YoshuaNava/TesisCuadricoptero/Circuitos/Datasheets/Changing PWM frequencies on Arduino controllers   Let's Make Robots!_files/great_motor_2.jpg

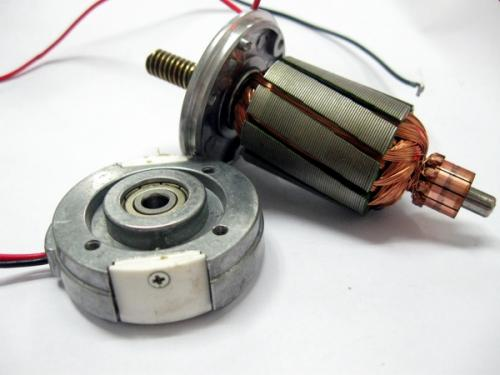
Circuitos/Datasheets/Changing PWM frequencies on Arduino controllers Let's Make Robots!_files/great_motor_2.jpg
