YoshuaNava/TesisCuadricoptero/README.md

Estabilización de un cuadricoptero mediante un algoritmo Proporcional-Integral-Derivativo
==================

Documentos, códigos, imagenes y videos de la tesis. 

Trabajo realizado por Luis Vicens y Yoshua Nava, estudiantes de Ingeniería Informática de la Universidad Católica Andrés Bello.
