YoshuaNava/TesisCuadricoptero/Documento/Lista de graficas que faltan en el documento.txt

Gráfico de respuesta en frecuencia del sensor ultrasónico
  Gráfico de las mediciones del sensor ultrasónico sin filtro y con filtro
