YoshuaNava/TesisCuadricoptero/Referencias/lecture3_state_estimation_tum.pdf

## Visual Navigation for Flying Robots

Dr. Jürgen Sturm

## Probabilistic Models and State Estimation

## Scientific Research

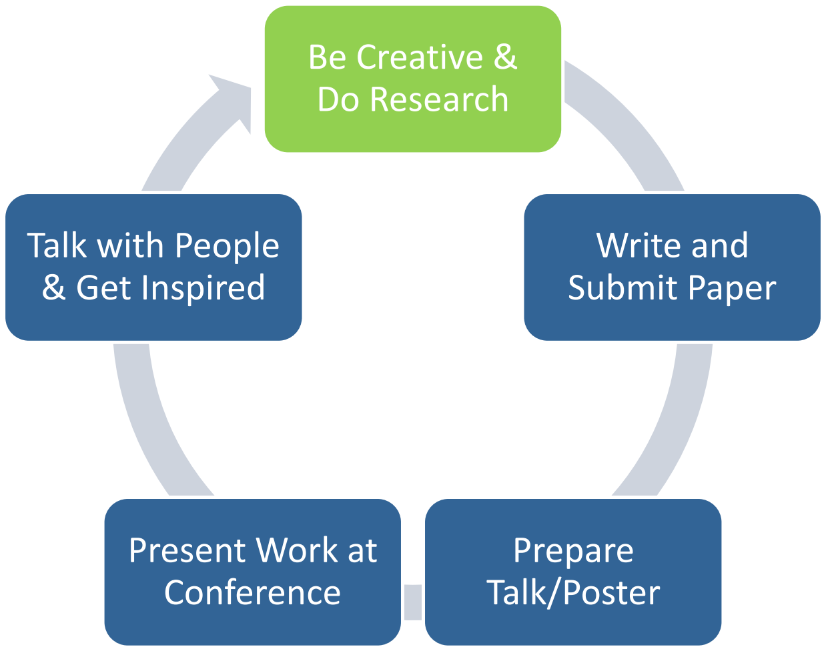
[picture p189: figure]
Be Creative & Do Research; Write and Submit Paper; Prepare Talk/Poster; Present Work at Conference; Talk with People & Get Inspired

Visual Navigation for Flying Robots | 2 | Dr. Jürgen Sturm, Computer Vision Group, TUM

## Flow of Publications

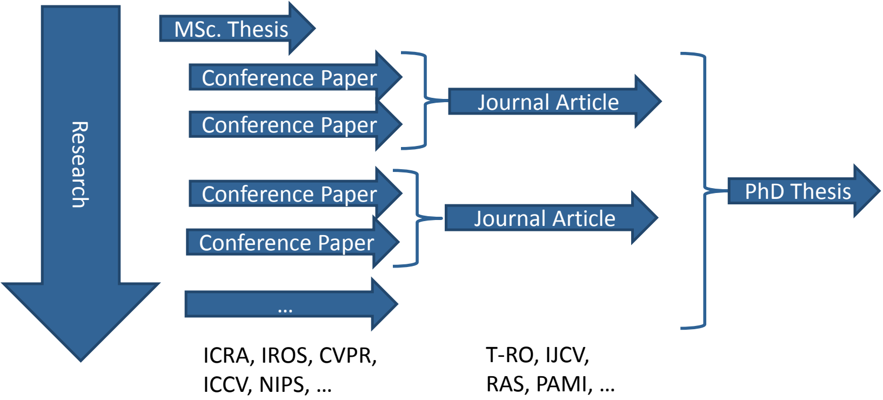
[picture p190: figure]
Conference Paper; Journal Article; ICRA, IROS, CVPR, ICCV, NIPS, …; PhD Thesis; T-RO, IJCV, RAS, PAMI, …; MSc. Thesis

Visual Navigation for Flying Robots | 3 | Dr. Jürgen Sturm, Computer Vision Group, TUM Research

## Important Conferences

- Robotics
- International Conference on Robotics and Automation (ICRA)
- International Conference on Intelligent Robots and Systems (IROS)
- Robotics: Science and Systems (RSS)
- Computer Vision
- International Conference on Computer Vision (ICCV)
- Computer Vision and Pattern Recognition (CVPR)
- German Conference on Computer Vision (GCPR)
Visual Navigation for Flying Robots | 4 | Dr. Jürgen Sturm, Computer Vision Group, TUM

next week

## ICRA: Preview

- Christian’s work got nominated for the “Best Vision Paper”
- Four sessions (with 6 papers each) on flying robots
- Interesting sessions:
- Localization
- Theory and Methods for SLAM
- Visual Servoing
- Sensor Fusion
- Trajectory Planning for Aerial Robots
- Novel Aerial Robots
- Aerial Robots and Manipulation
- Modeling & Control of Aerial Robots
- Sensing for Navigation
- Will report on interesting papers!
Visual Navigation for Flying Robots | 5 | Dr. Jürgen Sturm, Computer Vision Group, TUM

## Perception

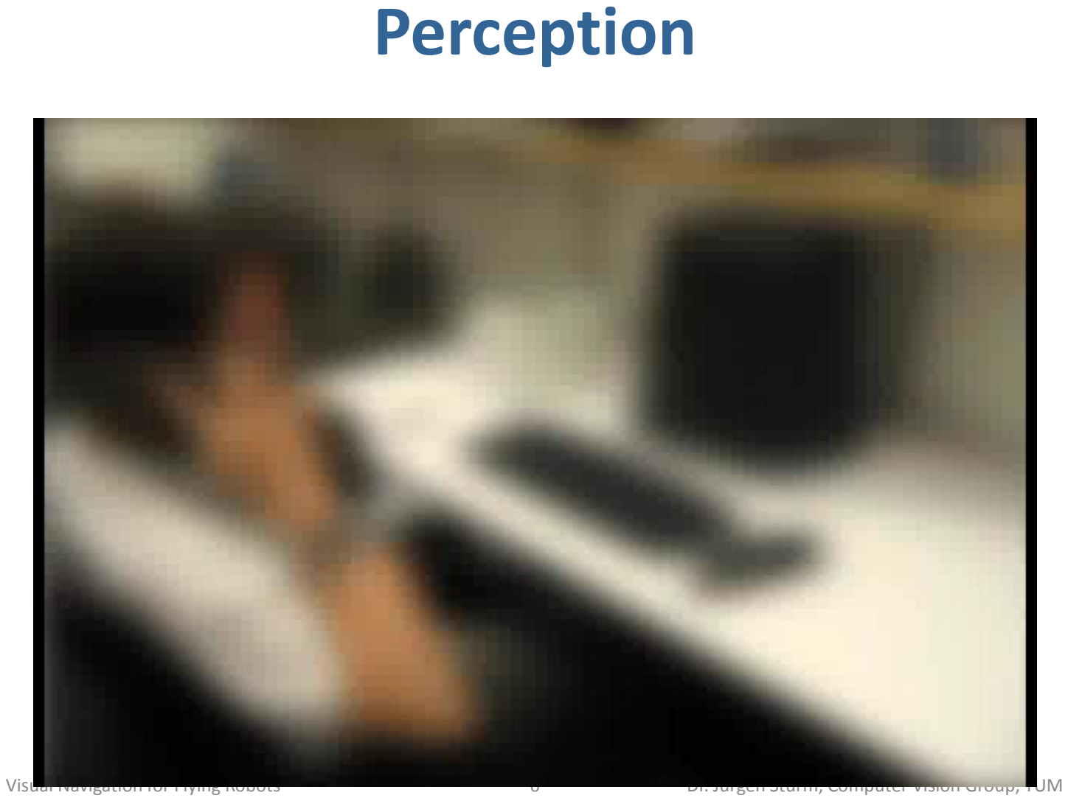
[picture p191: page 6]

Visual Navigation for Flying Robots | 6 | Dr. Jürgen Sturm, Computer Vision Group, TUM

## Perception

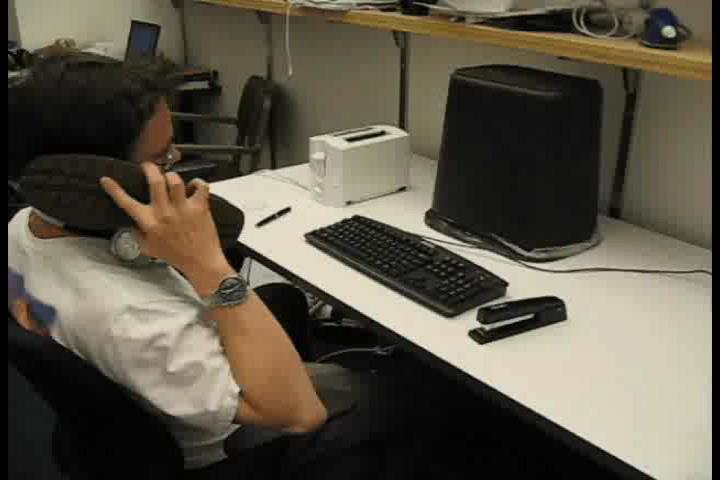
[picture p192: page 7]

Visual Navigation for Flying Robots | 7 | Dr. Jürgen Sturm, Computer Vision Group, TUM

## Perception

- Perception and models are strongly linked

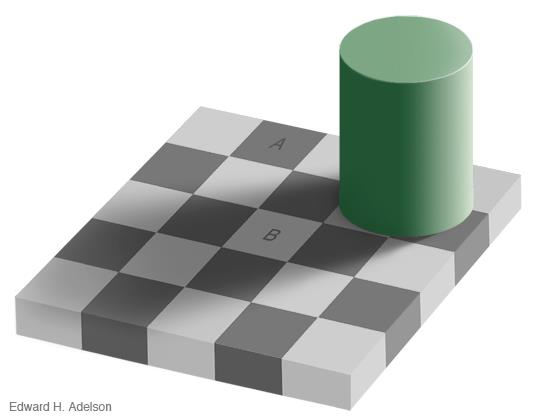
[picture p193: figure]

Visual Navigation for Flying Robots | 8 | Dr. Jürgen Sturm, Computer Vision Group, TUM

## Perception

- Perception and models are strongly linked
- Example: Human Perception

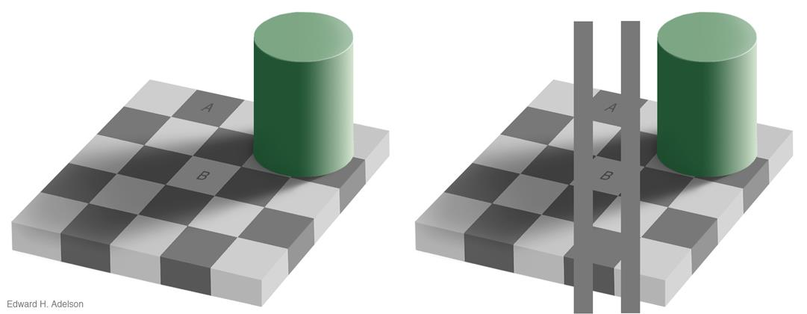
[picture p194: figure]

Visual Navigation for Flying Robots | 9 | Dr. Jürgen Sturm, Computer Vision Group, TUM

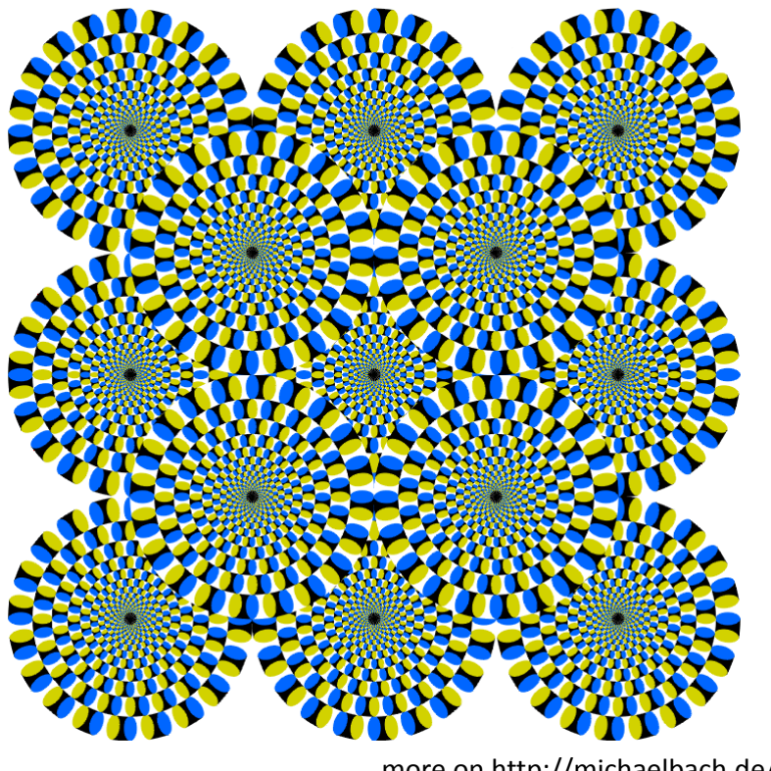
[picture p195: figure]

more on http://michaelbach.de/ot/index.html

Visual Navigation for Flying Robots | 10 | Dr. Jürgen Sturm, Computer Vision Group, TUM

## Models in Human Perception

- Count the black dots

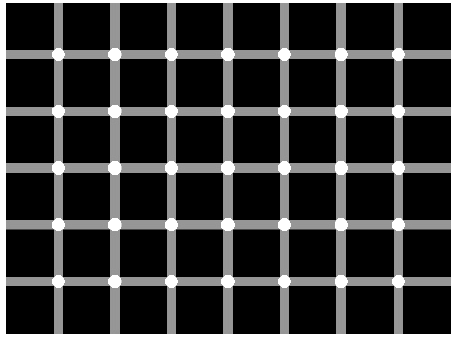
[picture p196: figure]

Visual Navigation for Flying Robots | 11 | Dr. Jürgen Sturm, Computer Vision Group, TUM

## State Estimation

- Cannot observe world state directly
- Need to estimate the world state
- Robot maintains belief about world state
- Update belief according to observations and actions using models
- Sensor observations → sensor model
- Executed actions → action/motion model
Visual Navigation for Flying Robots | 12 | Dr. Jürgen Sturm, Computer Vision Group, TUM

## State Estimation

What parts of the world state are (most) relevant for a flying robot?

Visual Navigation for Flying Robots | 13 | Dr. Jürgen Sturm, Computer Vision Group, TUM

## State Estimation

What parts of the world state are (most) relevant for a flying robot?
- Position
- Velocity
- Obstacles
- Map
- Positions and intentions of other
robots/humans
- …
Visual Navigation for Flying Robots | 14 | Dr. Jürgen Sturm, Computer Vision Group, TUM

## Models and State Estimation

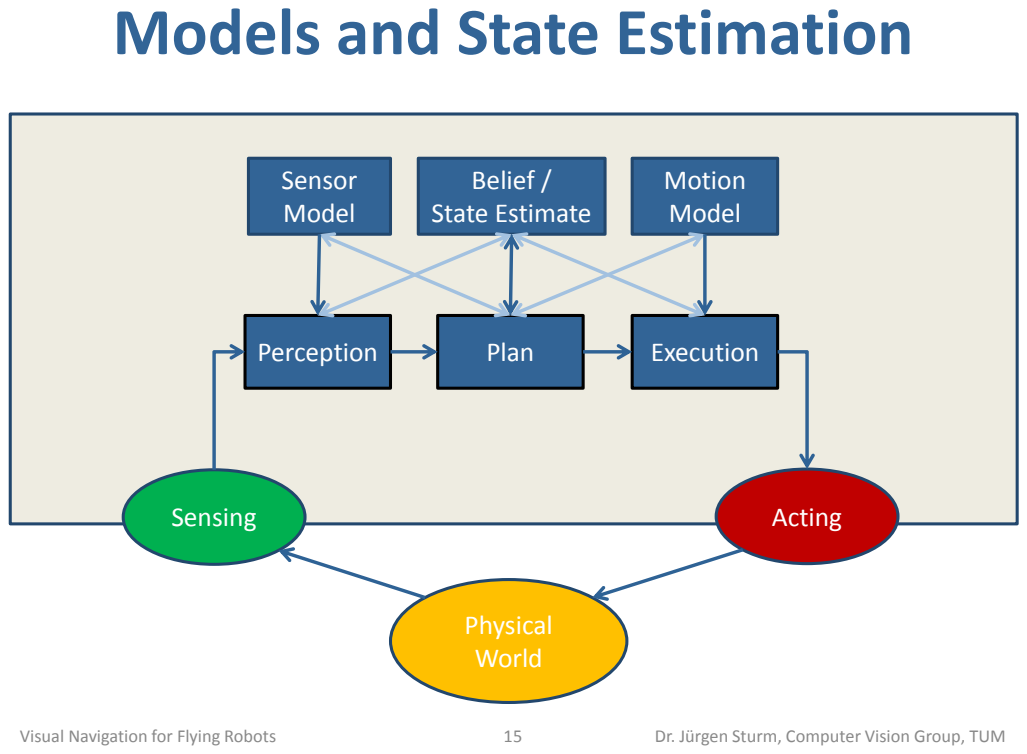
[picture p197: page 15]
Sensor Model; Visual Navigation for Flying Robots; Dr. Jürgen Sturm, Computer Vision Group, TUM; Perception; Plan; Execution; Sensing; Acting; Physical World; Belief / State Estimate; Motion Model

## (Deterministic) Sensor Model

- Robot perceives the environment through its sensors
- Goal: Infer the state of the world from sensor readings

sensor
reading

world
state

observation
function
Visual Navigation for Flying Robots | 16 | Dr. Jürgen Sturm, Computer Vision Group, TUM

## (Deterministic) Motion Model

- Robot executes an action
(e.g., move forward at 1m/s)
- Update belief state according to motion model
Visual Navigation for Flying Robots | 17 | Dr. Jürgen Sturm, Computer Vision Group, TUM
current state | previous
state

transition
function

executed
action

## Probabilistic Robotics

- Sensor observations are noisy, partial, potentially missing (why?)
- All models are partially wrong and incomplete (why?)
- Usually we have prior knowledge (from where?)
Visual Navigation for Flying Robots | 18 | Dr. Jürgen Sturm, Computer Vision Group, TUM

## Probabilistic Robotics

- Probabilistic sensor and motion models
- Integrate information from multiple sensors (multi-modal)
- Integrate information over time (filtering)
Visual Navigation for Flying Robots | 19 | Dr. Jürgen Sturm, Computer Vision Group, TUM

## Agenda for Today

- Motivation ✓
- Bayesian Probability Theory
- Bayes Filter
- Normal Distribution
- Kalman Filter
Visual Navigation for Flying Robots | 20 | Dr. Jürgen Sturm, Computer Vision Group, TUM

## The Axioms of Probability Theory

Visual Navigation for Flying Robots | 21 | Dr. Jürgen Sturm, Computer Vision Group, TUM
Notation: | refers to the probability that
proposition holds

1.

2.

3.

## A Closer Look at Axiom 3

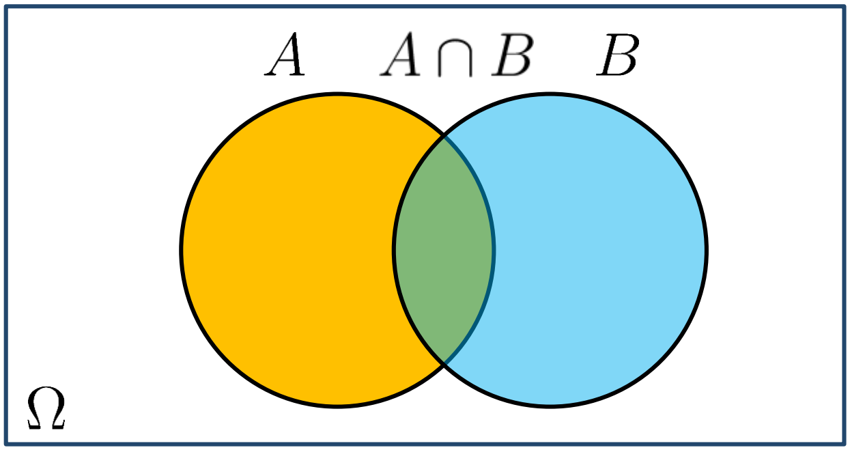
[picture p198: figure]

Visual Navigation for Flying Robots | 22 | Dr. Jürgen Sturm, Computer Vision Group, TUM

## Discrete Random Variables

- denotes a random variable
- can take on a countable number of values in
- is the probability that the random variable takes on value
- is called the probability mass function
- Example:
Visual Navigation for Flying Robots | 23 | Dr. Jürgen Sturm, Computer Vision Group, TUM

## Continuous Random Variables

- takes on continuous values
- | or | is called the probability
density function (PDF)
- Example
Visual Navigation for Flying Robots | 24 | Dr. Jürgen Sturm, Computer Vision Group, TUM

## Proper Distributions Sum To One

- Discrete case
- Continuous case
Visual Navigation for Flying Robots | 25 | Dr. Jürgen Sturm, Computer Vision Group, TUM

## Joint and Conditional Probabilities

Visual Navigation for Flying Robots | 26 | Dr. Jürgen Sturm, Computer Vision Group, TUM

▪

- If and are independent then
- is the probability of x given y
- If and are independent then

## Conditional Independence

Visual Navigation for Flying Robots | 27 | Dr. Jürgen Sturm, Computer Vision Group, TUM
- Definition of conditional independence
- Equivalent to
- Note: this does not necessarily mean that

## Marginalization

- Discrete case
- Continuous case
Visual Navigation for Flying Robots | 28 | Dr. Jürgen Sturm, Computer Vision Group, TUM

## Example: Marginalization

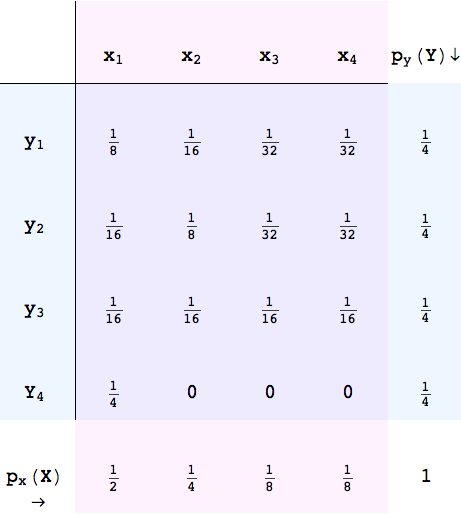
[picture p199: figure]

Visual Navigation for Flying Robots | 29 | Dr. Jürgen Sturm, Computer Vision Group, TUM

## Law of Total Probability

- Discrete case
- Continuous case
Visual Navigation for Flying Robots | 30 | Dr. Jürgen Sturm, Computer Vision Group, TUM

- Discrete case
- Continuous case
- The expected value is the weighted average of all values a random variable can take on.
- Expectation is a linear operator

## Expected Value of a Random Variable

Visual Navigation for Flying Robots | 31 | Dr. Jürgen Sturm, Computer Vision Group, TUM

## Covariance of a Random Variable

- Measures the squared expected deviation from the mean
Visual Navigation for Flying Robots | 32 | Dr. Jürgen Sturm, Computer Vision Group, TUM

## Estimation from Data

- Observations
- Sample Mean

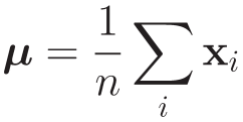
[picture p200: figure]

- Sample Covariance
Visual Navigation for Flying Robots | 33 | Dr. Jürgen Sturm, Computer Vision Group, TUM

## The State Estimation Problem

We want to estimate the world state from
1. Sensor measurements and
2. Controls (or odometry readings)

We need to model the relationship between these random variables, i.e.,

Visual Navigation for Flying Robots | 34 | Dr. Jürgen Sturm, Computer Vision Group, TUM

## Causal vs. Diagnostic Reasoning

- is diagnostic
- is causal
- Often causal knowledge is easier to obtain
- Bayes rule allows us to use causal knowledge:
Visual Navigation for Flying Robots | 35 | Dr. Jürgen Sturm, Computer Vision Group, TUM

observation likelihood prior on world state

prior on sensor observations

## Bayes Formula

- Derivation of Bayes Formula
- Our usage
Visual Navigation for Flying Robots | 36 | Dr. Jürgen Sturm, Computer Vision Group, TUM

## Bayes Formula

- Derivation of Bayes Formula
- Our usage
Visual Navigation for Flying Robots | 37 | Dr. Jürgen Sturm, Computer Vision Group, TUM

- Direct computation of can be difficult
- Idea: Compute improper distribution, normalize afterwards
- Step 1:
- Step 2:
- Step 3:

## Normalization

Visual Navigation for Flying Robots | 38 | Dr. Jürgen Sturm, Computer Vision Group, TUM

(Law of total
probability)

### Bayes Rule with Background Knowledge

Visual Navigation for Flying Robots | 39 | Dr. Jürgen Sturm, Computer Vision Group, TUM

## Example: Sensor Measurement

- Quadrocopter seeks the landing zone
- Landing zone is marked with many bright lamps
- Quadrocopter has a brightness sensor

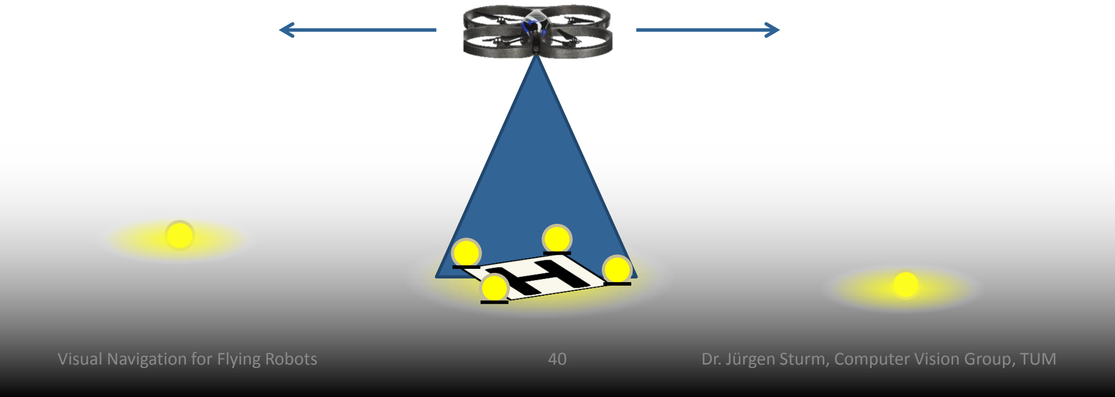
[picture p201: figure]

Visual Navigation for Flying Robots | 40 | Dr. Jürgen Sturm, Computer Vision Group, TUM

## Example: Sensor Measurement

- Binary sensor
- Binary world state
- Sensor model
- Prior on world state
- Assume: Robot observes light, i.e.,
- What is the probability

that the robot is above the landing zone?

Visual Navigation for Flying Robots | 41 | Dr. Jürgen Sturm, Computer Vision Group, TUM

## Example: Sensor Measurement

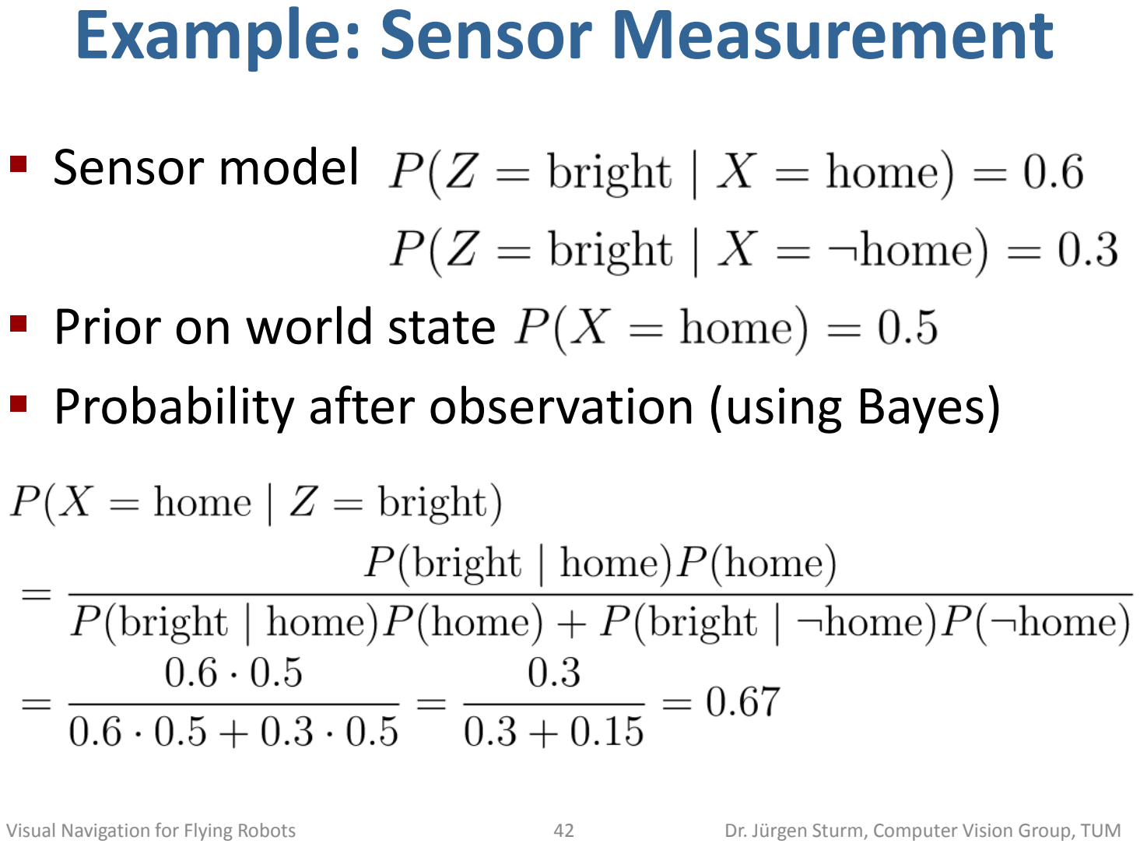
[picture p202: page 42]

- Sensor model
- Prior on world state
- Probability after observation (using Bayes)
Visual Navigation for Flying Robots | 42 | Dr. Jürgen Sturm, Computer Vision Group, TUM

## Example: Sensor Measurement

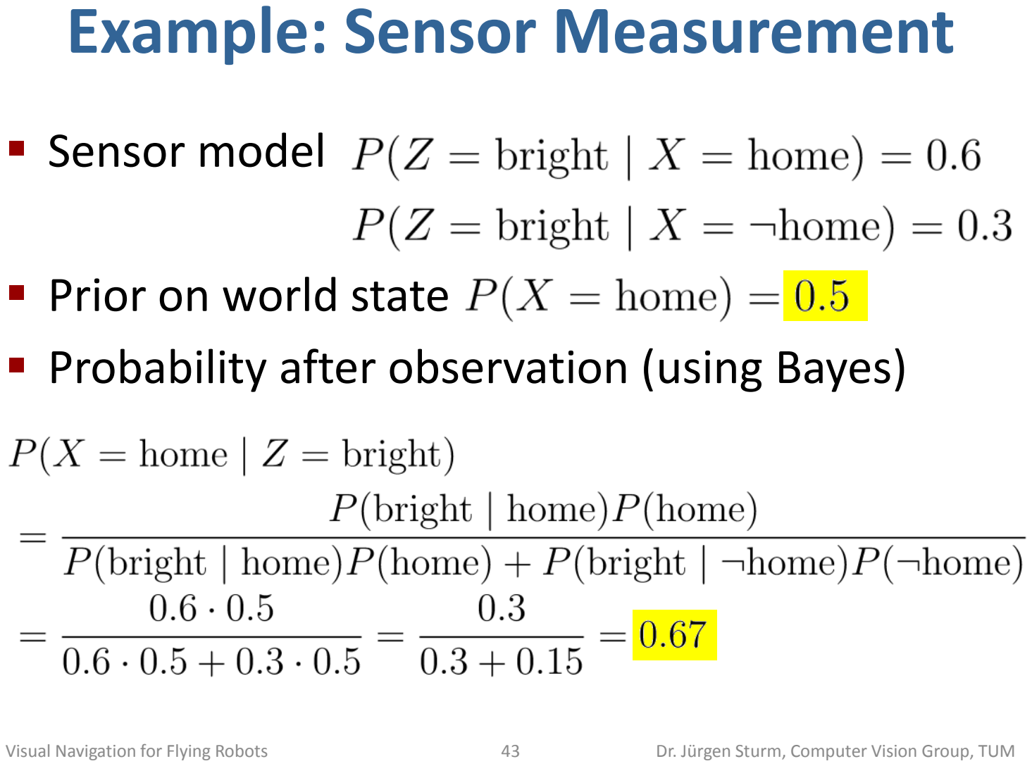
[picture p203: page 43]

- Sensor model
- Prior on world state
- Probability after observation (using Bayes)
Visual Navigation for Flying Robots | 43 | Dr. Jürgen Sturm, Computer Vision Group, TUM

## Combining Evidence

- Suppose our robot obtains another observation (either from the same or a different sensor)
- How can we integrate this new information?
- More generally, how can we estimate
| ?
Visual Navigation for Flying Robots | 44 | Dr. Jürgen Sturm, Computer Vision Group, TUM

## Combining Evidence

- Suppose our robot obtains another observation (either from the same or a different sensor)
- How can we integrate this new information?
- More generally, how can we estimate
| ?
- Bayes formula gives us:
Visual Navigation for Flying Robots | 45 | Dr. Jürgen Sturm, Computer Vision Group, TUM

## Recursive Bayesian Updates

Visual Navigation for Flying Robots | 46 | Dr. Jürgen Sturm, Computer Vision Group, TUM

## Recursive Bayesian Updates

Visual Navigation for Flying Robots | 47 | Dr. Jürgen Sturm, Computer Vision Group, TUM
- Markov Assumption:
is independent of | if we know

## Recursive Bayesian Updates

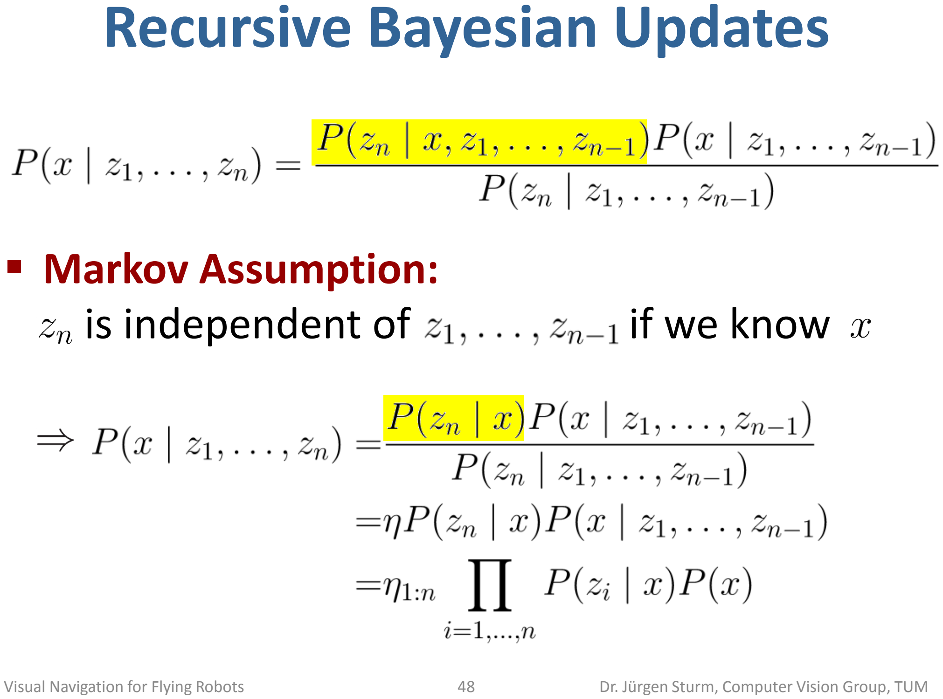
[picture p204: page 48]

Visual Navigation for Flying Robots | 48 | Dr. Jürgen Sturm, Computer Vision Group, TUM
- Markov Assumption:
is independent of | if we know

## Example: Sensor Measurement

- Quadrocopter seeks the landing zone
- Landing zone is marked with many bright lamps and a visual marker

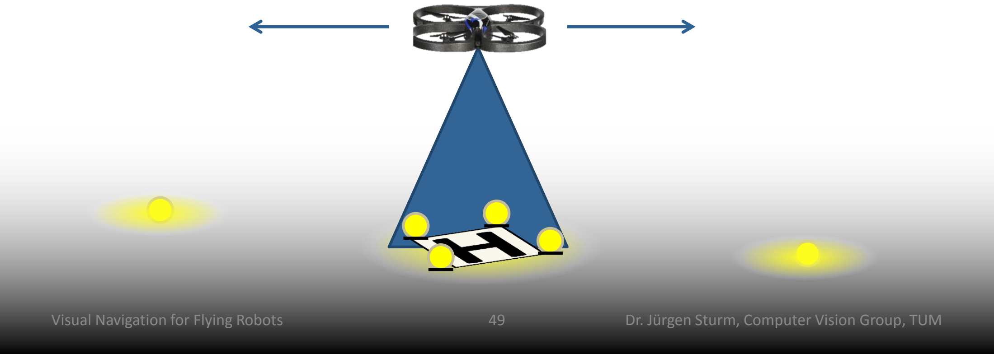
[picture p205: figure]

Visual Navigation for Flying Robots | 49 | Dr. Jürgen Sturm, Computer Vision Group, TUM

## Example: Second Measurement

- Sensor model
- Previous estimate
- Assume robot does not observe marker
- What is the probability of being home?

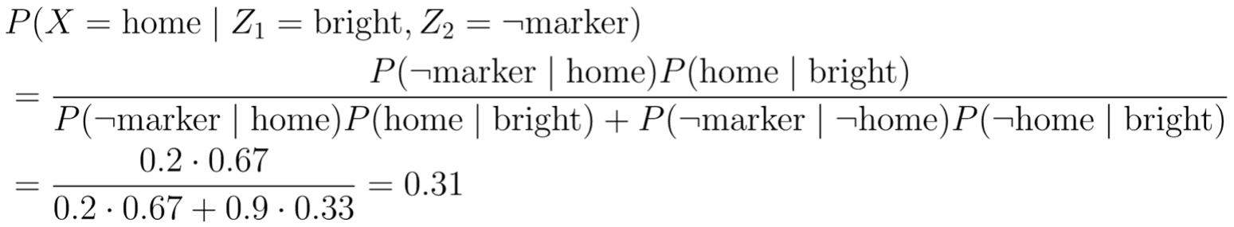
[picture p206: figure]

Visual Navigation for Flying Robots | 50 | Dr. Jürgen Sturm, Computer Vision Group, TUM

## Example: Second Measurement

- Sensor model
- Previous estimate
- Assume robot does not observe marker
- What is the probability of being home?

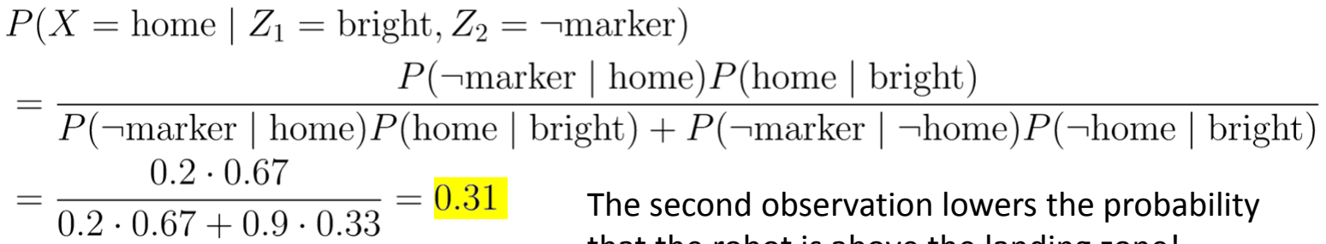
[picture p207: figure]

Visual Navigation for Flying Robots | 51 | Dr. Jürgen Sturm, Computer Vision Group, TUM

The second observation lowers the probability that the robot is above the landing zone!

## Actions (Motions)

- Often the world is dynamic since
- actions carried out by the robot…
- actions carried out by other agents…
- or just time passing by…
…change the world
- How can we incorporate actions?
Visual Navigation for Flying Robots | 52 | Dr. Jürgen Sturm, Computer Vision Group, TUM

## Typical Actions

- Quadrocopter accelerates by changing the speed of its motors
- Position also changes when quadrocopter does “nothing” (and drifts..)
- Actions are never carried out with absolute certainty
- In contrast to measurements, actions generally increase the uncertainty of the state estimate
Visual Navigation for Flying Robots | 53 | Dr. Jürgen Sturm, Computer Vision Group, TUM

## Action Models

- To incorporate the outcome of an action into the current state estimate (“belief”), we use the conditional pdf
- This term specifies the probability that executing the action u in state x will lead to state x’
Visual Navigation for Flying Robots | 54 | Dr. Jürgen Sturm, Computer Vision Group, TUM

## Example: Take-Off

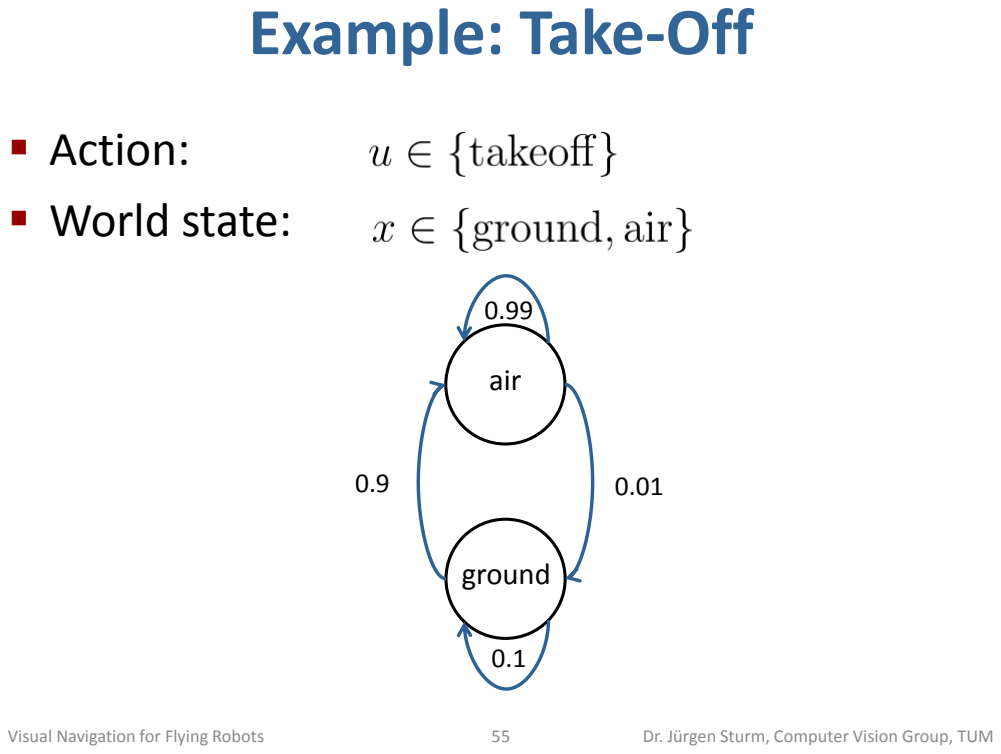
[picture p208: page 55]
▪ Action: ▪ World state:; Visual Navigation for Flying Robots; Dr. Jürgen Sturm, Computer Vision Group, TUM; ground; air

## Integrating the Outcome of Actions

- Discrete case
- Continuous case
Visual Navigation for Flying Robots | 56 | Dr. Jürgen Sturm, Computer Vision Group, TUM

## Example: Take-Off

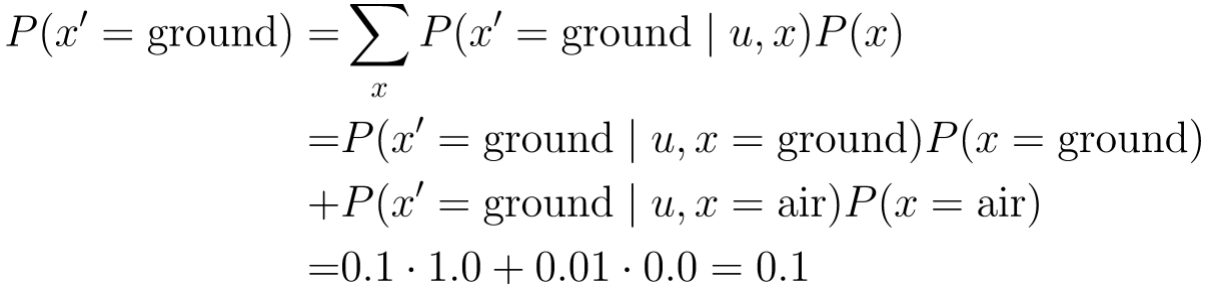
[picture p209: figure]

Visual Navigation for Flying Robots | 57 | Dr. Jürgen Sturm, Computer Vision Group, TUM
- Prior belief on robot state:
(robot is located on the ground)
- Robot executes “take-off” action
- What is the robot’s belief after one time step?
- Question: What is the probability at t=2?

## Markov Chain

- A Markov chain is a stochastic process where, given the present state, the past and the future states are independent

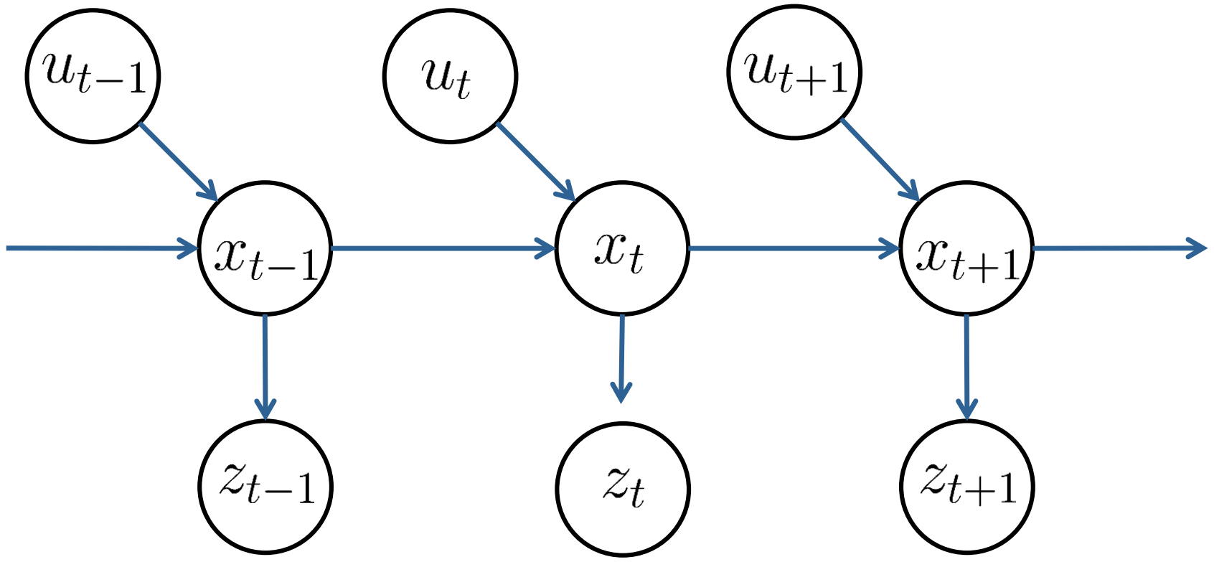
[picture p210: figure]

Visual Navigation for Flying Robots | 58 | Dr. Jürgen Sturm, Computer Vision Group, TUM

## Markov Assumption

- Observations depend only on current state
- Current state depends only on previous state and current action
- Underlying assumptions
- Static world
- Independent noise
- Perfect model, no approximation errors
Visual Navigation for Flying Robots | 59 | Dr. Jürgen Sturm, Computer Vision Group, TUM

## Bayes Filter

- Given:
- Stream of observations and actions :
- Sensor model
- Action model
- Prior probability of the system state
- Wanted:
- Estimate of the state of the dynamic system
- Posterior of the state is also called belief
Visual Navigation for Flying Robots | 60 | Dr. Jürgen Sturm, Computer Vision Group, TUM

## Bayes Filter

For each time step, do
1. Apply motion model
2. Apply sensor model

Note: Bayes filters also work on continuous state spaces (replace sum by integral)

Visual Navigation for Flying Robots | 61 | Dr. Jürgen Sturm, Computer Vision Group, TUM

## Bayes Filter

For each time step, do
1. Apply motion model
2. Apply sensor model

Second note: Bayes filter also works when actions and observations are asynchronous!

Visual Navigation for Flying Robots | 62 | Dr. Jürgen Sturm, Computer Vision Group, TUM

## Example: Localization

- Discrete state
- Belief distribution can be represented as a grid
- This is also called a histogram filter
Visual Navigation for Flying Robots | 63 | Dr. Jürgen Sturm, Computer Vision Group, TUM

P = 1.0

P = 0.0

## Example: Localization

- Action
- Robot can move one cell in each time step
- Actions are not perfectly executed

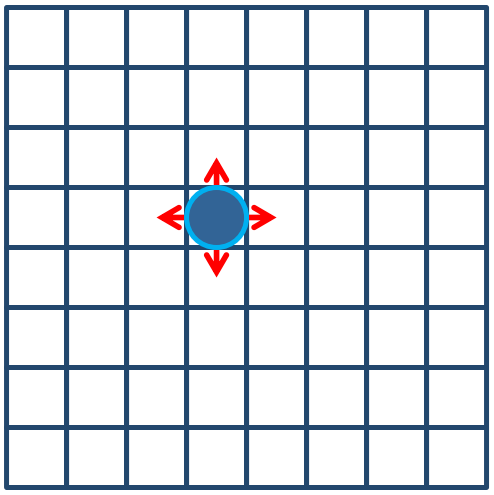
[picture p211: figure]

Visual Navigation for Flying Robots | 64 | Dr. Jürgen Sturm, Computer Vision Group, TUM

## Example: Localization

- Action
- Robot can move one cell in each time step
- Actions are not perfectly executed
- Example: move east

60% success rate, 10% to stay/move too far/ move one up/move one down

Visual Navigation for Flying Robots | 65 | Dr. Jürgen Sturm, Computer Vision Group, TUM

## Example: Localization

- Binary observation
- One (special) location has a marker
- Marker is sometimes also detected in neighboring cells
Visual Navigation for Flying Robots | 66 | Dr. Jürgen Sturm, Computer Vision Group, TUM

## Example: Localization

- Let’s start a simulation run… (shades are hand-drawn, not exact!)
Visual Navigation for Flying Robots | 67 | Dr. Jürgen Sturm, Computer Vision Group, TUM

## Example: Localization

- t=0
- Prior distribution (initial belief)
- Assume we know the initial location (if not, we could initialize with a uniform prior)

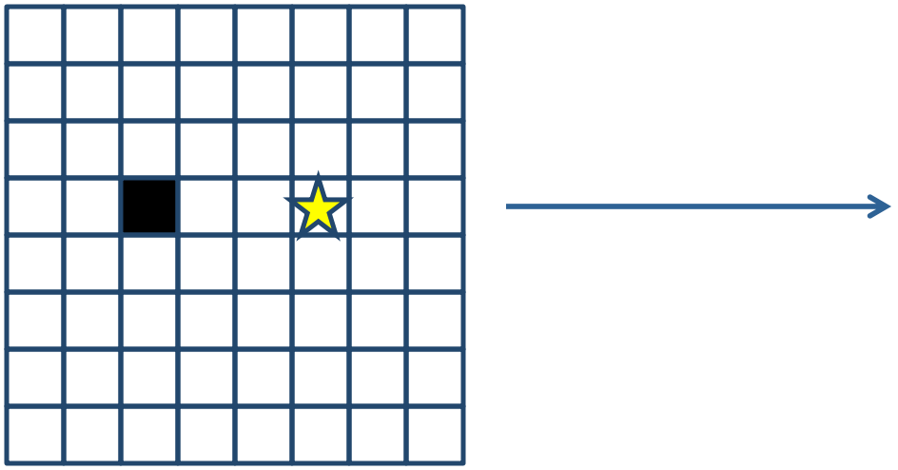
[picture p212: figure]

Visual Navigation for Flying Robots | 68 | Dr. Jürgen Sturm, Computer Vision Group, TUM

## Example: Localization

- t=1, u=east, z=no-marker
- Bayes filter step 1: Apply motion model

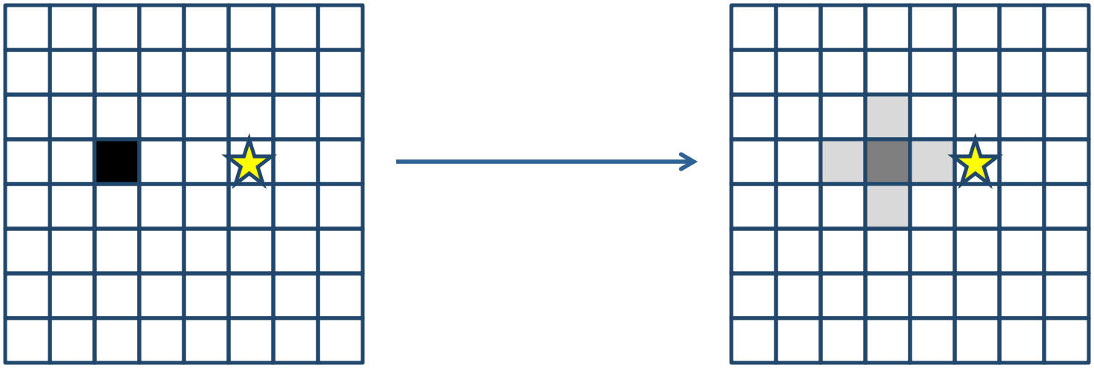
[picture p213: figure]

Visual Navigation for Flying Robots | 69 | Dr. Jürgen Sturm, Computer Vision Group, TUM

## Example: Localization

- t=1, u=east, z=no-marker
- Bayes filter step 2: Apply observation model

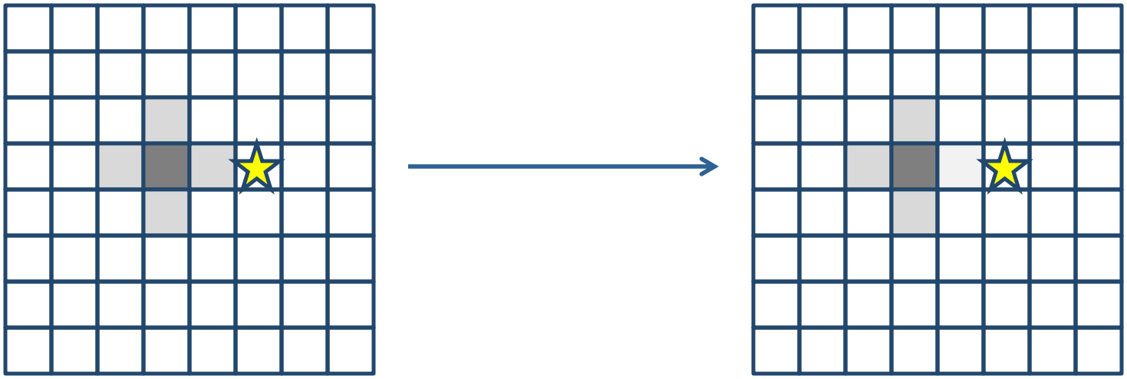
[picture p214: figure]

Visual Navigation for Flying Robots | 70 | Dr. Jürgen Sturm, Computer Vision Group, TUM

## Example: Localization

- t=2, u=east, z=marker
- Bayes filter step 2: Apply motion model

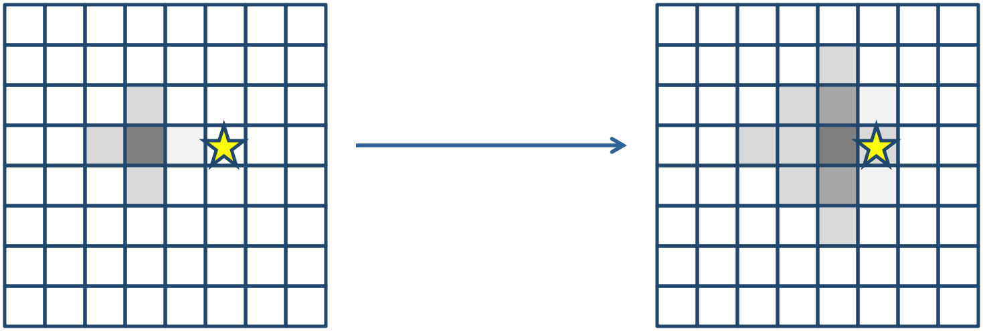
[picture p215: figure]

Visual Navigation for Flying Robots | 71 | Dr. Jürgen Sturm, Computer Vision Group, TUM

## Example: Localization

- t=2, u=east, z=marker
- Bayes filter step 1: Apply observation model
- Question: Where is the robot?

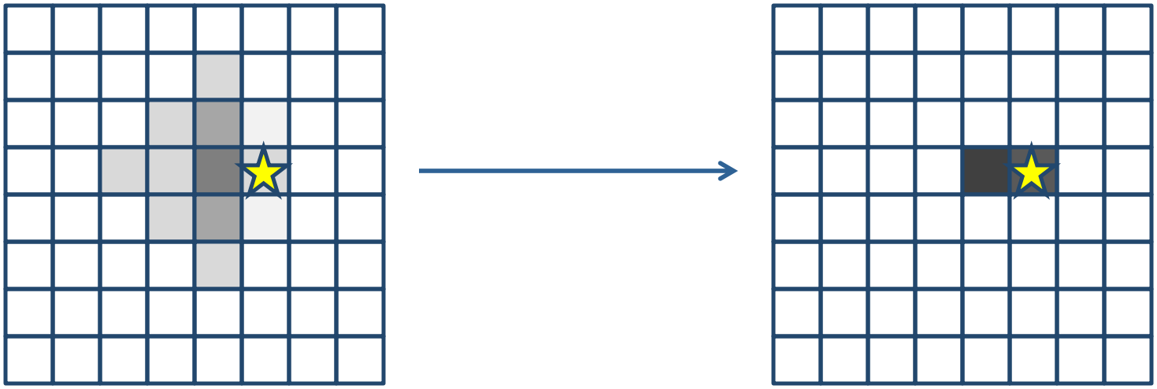
[picture p216: figure]

Visual Navigation for Flying Robots | 72 | Dr. Jürgen Sturm, Computer Vision Group, TUM

## Bayes Filter - Summary

- Markov assumption allows efficient recursive Bayesian updates of the belief distribution
- Useful tool for estimating the state of a dynamic system
- Bayes filter is the basis of many other filters
- Kalman filter
- Particle filter
- Hidden Markov models
- Dynamic Bayesian networks
- Partially observable Markov decision processes (POMDPs)
Visual Navigation for Flying Robots | 73 | Dr. Jürgen Sturm, Computer Vision Group, TUM

## Kalman Filter

- Bayes filter with continuous states
- State represented with a normal distribution
- Developed in the late 1950’s
- Kalman filter is very efficient (only requires a few matrix operations per time step)
- Applications range from economics, weather forecasting, satellite navigation to robotics and many more
- Most relevant Bayes filter variant in practice
→ exercise sheet 2
Visual Navigation for Flying Robots | 74 | Dr. Jürgen Sturm, Computer Vision Group, TUM

## Normal Distribution

- Univariate normal distribution

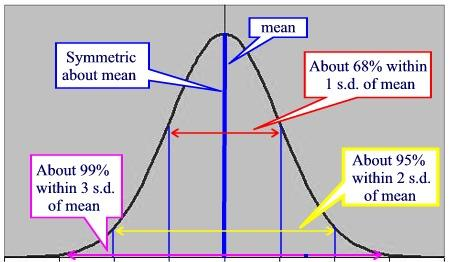
[picture p217: figure]

Visual Navigation for Flying Robots | 75 | Dr. Jürgen Sturm, Computer Vision Group, TUM

## Normal Distribution

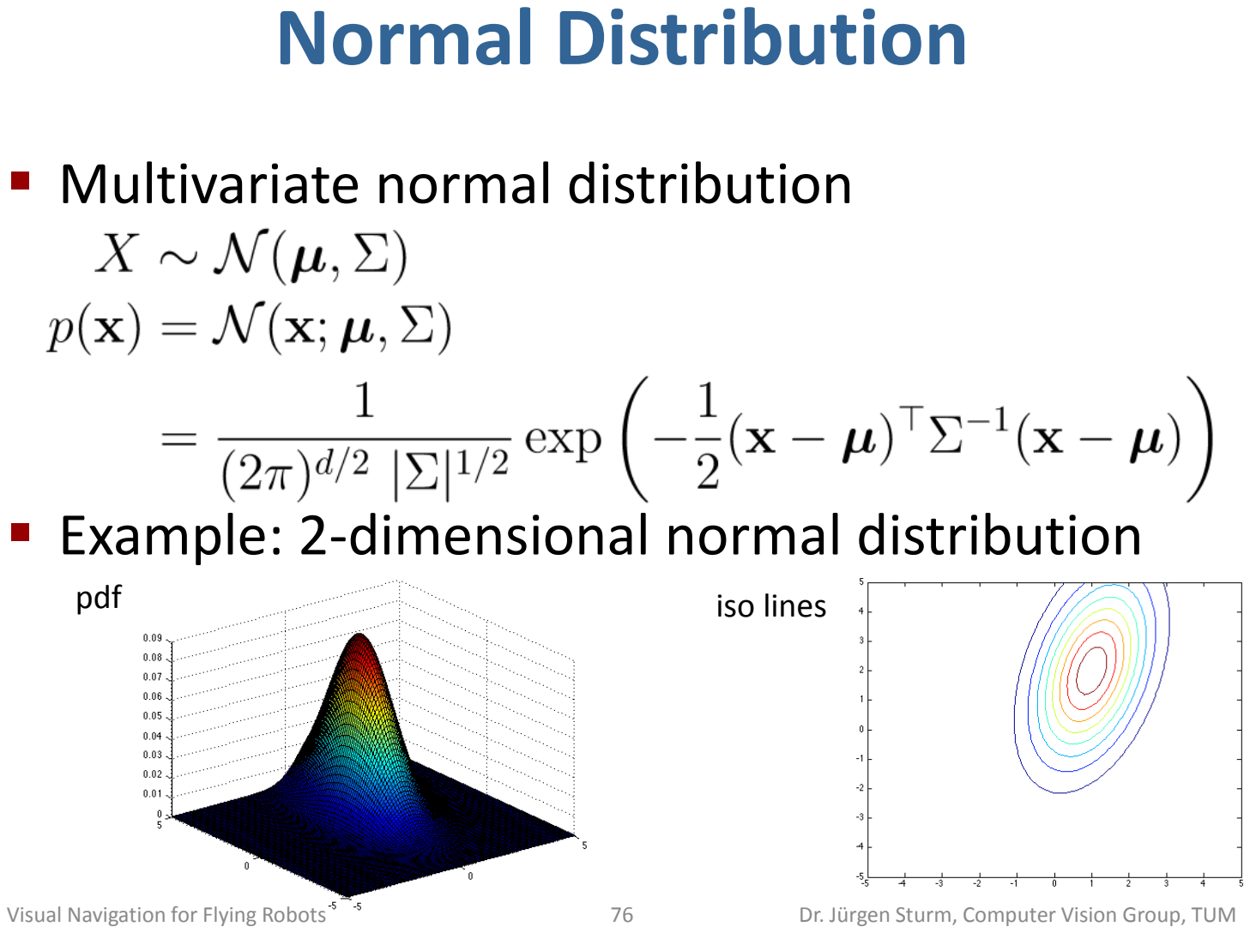
[picture p218: page 76]

- Multivariate normal distribution
- Example: 2-dimensional normal distribution
Visual Navigation for Flying Robots | 76 | Dr. Jürgen Sturm, Computer Vision Group, TUM
pdf | iso lines

## Properties of Normal Distributions

- Linear transformation → remains Gaussian
- Intersection of two Gaussians → remains Gaussian
Visual Navigation for Flying Robots | 77 | Dr. Jürgen Sturm, Computer Vision Group, TUM

## Linear Process Model

- Consider a time-discrete stochastic process (Markov chain)
Visual Navigation for Flying Robots | 78 | Dr. Jürgen Sturm, Computer Vision Group, TUM

## Linear Process Model

- Consider a time-discrete stochastic process
- Represent the estimated state (belief) by a Gaussian
Visual Navigation for Flying Robots | 79 | Dr. Jürgen Sturm, Computer Vision Group, TUM

## Linear Process Model

- Consider a time-discrete stochastic process
- Represent the estimated state (belief) by a Gaussian
- Assume that the system evolves linearly over time, then
Visual Navigation for Flying Robots | 80 | Dr. Jürgen Sturm, Computer Vision Group, TUM

## Linear Process Model

- Consider a time-discrete stochastic process
- Represent the estimated state (belief) by a Gaussian
- Assume that the system evolves linearly over time and depends linearly on the controls
Visual Navigation for Flying Robots | 81 | Dr. Jürgen Sturm, Computer Vision Group, TUM

## Linear Process Model

- Consider a time-discrete stochastic process
- Represent the estimated state (belief) by a Gaussian
- Assume that the system evolves linearly over time, depends linearly on the controls, and has zero-mean, normally distributed process noise

with

Visual Navigation for Flying Robots | 82 | Dr. Jürgen Sturm, Computer Vision Group, TUM

## Linear Observations

- Further, assume we make observations that depend linearly on the state
Visual Navigation for Flying Robots | 83 | Dr. Jürgen Sturm, Computer Vision Group, TUM

## Linear Observations

- Further, assume we make observations that depend linearly on the state and that are perturbed by zero-mean, normally distributed observation noise

with

Visual Navigation for Flying Robots | 84 | Dr. Jürgen Sturm, Computer Vision Group, TUM

## Kalman Filter

Estimates the state of a discrete-time controlled process that is governed by the linear stochastic difference equation

and (linear) measurements of the state

with | and
Visual Navigation for Flying Robots | 85 | Dr. Jürgen Sturm, Computer Vision Group, TUM

## Variables and Dimensions

- State
- Controls
- Observations
- Process equation
- Measurement equation
Visual Navigation for Flying Robots | 86 | Dr. Jürgen Sturm, Computer Vision Group, TUM

## Kalman Filter

- Initial belief is Gaussian
- Next state is also Gaussian (linear transformation)
- Observations are also Gaussian
Visual Navigation for Flying Robots | 87 | Dr. Jürgen Sturm, Computer Vision Group, TUM

## From Bayes Filter to Kalman Filter

For each time step, do
1. Apply motion model
Visual Navigation for Flying Robots | 88 | Dr. Jürgen Sturm, Computer Vision Group, TUM

## From Bayes Filter to Kalman Filter

For each time step, do
1. Apply motion model

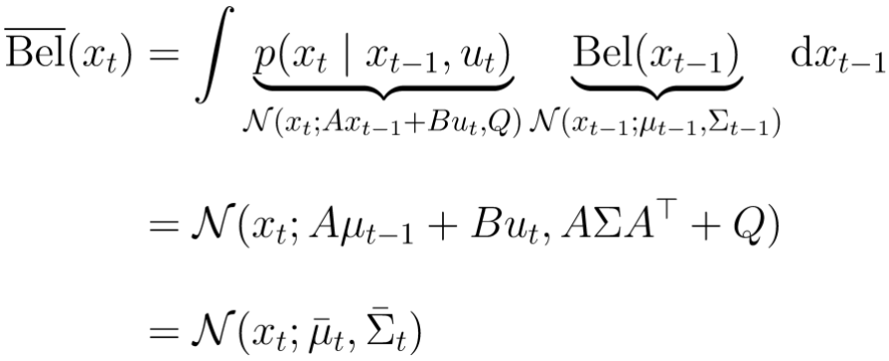
[picture p219: figure]

Visual Navigation for Flying Robots | 89 | Dr. Jürgen Sturm, Computer Vision Group, TUM

## From Bayes Filter to Kalman Filter

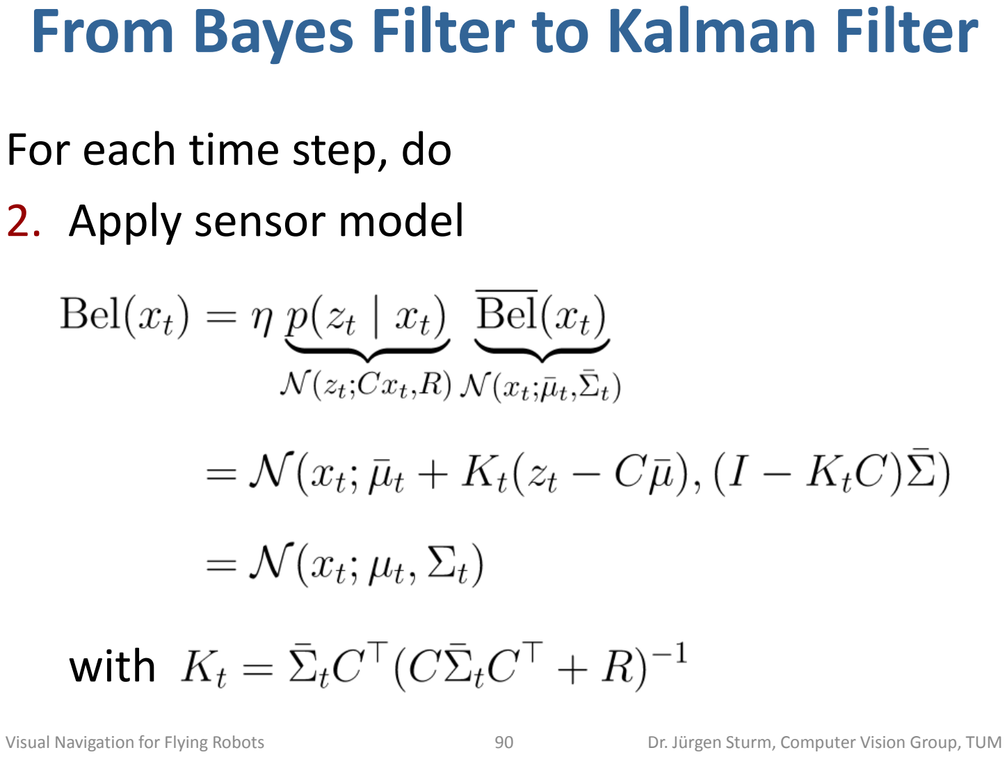
[picture p220: page 90]

For each time step, do
2. Apply sensor model

with

Visual Navigation for Flying Robots | 90 | Dr. Jürgen Sturm, Computer Vision Group, TUM

## Kalman Filter

For each time step, do
1. Apply motion model
2. Apply sensor model

with

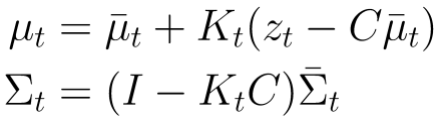
[picture p221: figure]

Visual Navigation for Flying Robots | 91 | Dr. Jürgen Sturm, Computer Vision Group, TUM

For the interested readers: See Probabilistic Robotics for full derivation (Chapter 3)

## Kalman Filter

- Highly efficient: Polynomial in the measurement dimensionality k and state dimensionality n:
- Optimal for linear Gaussian systems!
- Most robotics systems are nonlinear!
Visual Navigation for Flying Robots | 92 | Dr. Jürgen Sturm, Computer Vision Group, TUM

## Nonlinear Dynamical Systems

- Most realistic robotic problems involve nonlinear functions
- Motion function
- Observation function
Visual Navigation for Flying Robots | 93 | Dr. Jürgen Sturm, Computer Vision Group, TUM

## Taylor Expansion

- Solution: Linearize both functions
- Motion function
- Observation function

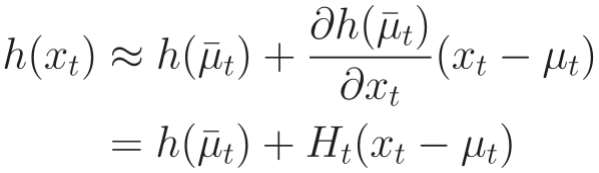
[picture p222: figure]

Visual Navigation for Flying Robots | 94 | Dr. Jürgen Sturm, Computer Vision Group, TUM

## Extended Kalman Filter

For each time step, do
1. Apply motion model

with

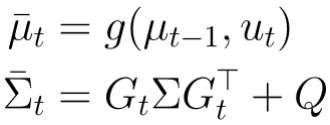
[picture p223: figure]

2. Apply sensor model

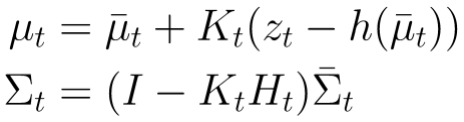
[picture p224: figure]

Visual Navigation for Flying Robots | 95 | Dr. Jürgen Sturm, Computer Vision Group, TUM

For the interested readers: See Probabilistic Robotics for full derivation (Chapter 3)

## Example

- 2D case
- State

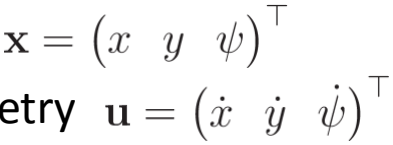
[picture p225: figure]

- Odometry
- Observations of visual marker (relative to robot pose)
- Fixed time intervals
Visual Navigation for Flying Robots | 96 | Dr. Jürgen Sturm, Computer Vision Group, TUM

## Example

- Motion function
- Derivative of motion function
Visual Navigation for Flying Robots | 97 | Dr. Jürgen Sturm, Computer Vision Group, TUM

## Example

- Observation Function (→ Sheet 2)
Visual Navigation for Flying Robots | 98 | Dr. Jürgen Sturm, Computer Vision Group, TUM

## Example

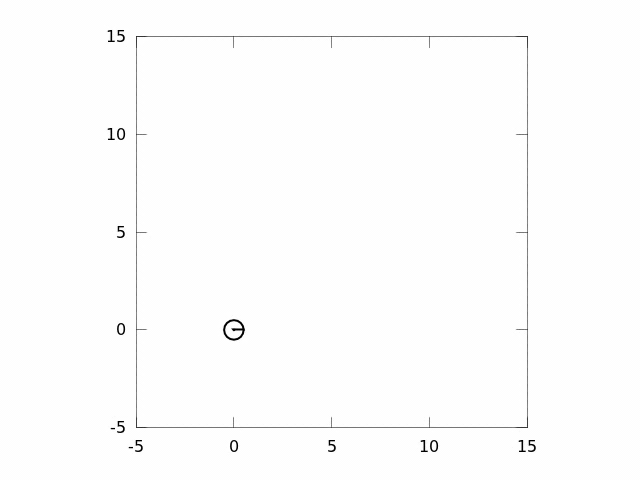
[picture p226: figure]

Visual Navigation for Flying Robots | 99 | Dr. Jürgen Sturm, Computer Vision Group, TUM
- Dead reckoning (no observations)
- Large process noise in x+y

## Example

Visual Navigation for Flying Robots | 100 | Dr. Jürgen Sturm, Computer Vision Group, TUM
- Dead reckoning (no observations)
- Large process noise in x+y+yaw

## Example

- Now with observations (limited visibility)
- Assume robot knows correct starting pose
Visual Navigation for Flying Robots | 101 | Dr. Jürgen Sturm, Computer Vision Group, TUM

## Example

- What if the initial pose (x+y) is wrong?

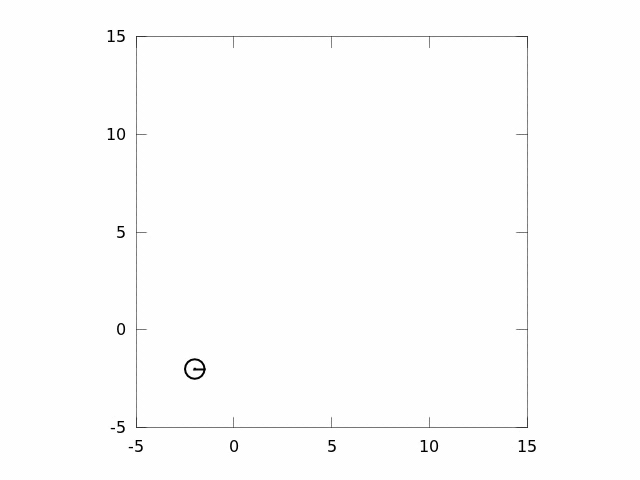
[picture p227: figure]

Visual Navigation for Flying Robots | 102 | Dr. Jürgen Sturm, Computer Vision Group, TUM

## Example

- What if the initial pose (x+y+yaw) is wrong?

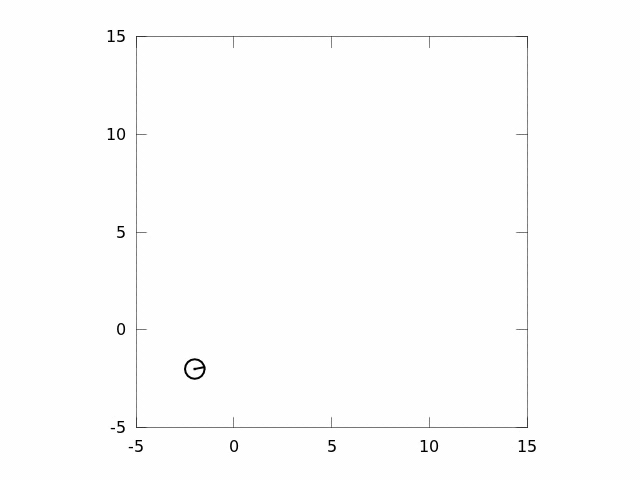
[picture p228: figure]

Visual Navigation for Flying Robots | 103 | Dr. Jürgen Sturm, Computer Vision Group, TUM

## Example

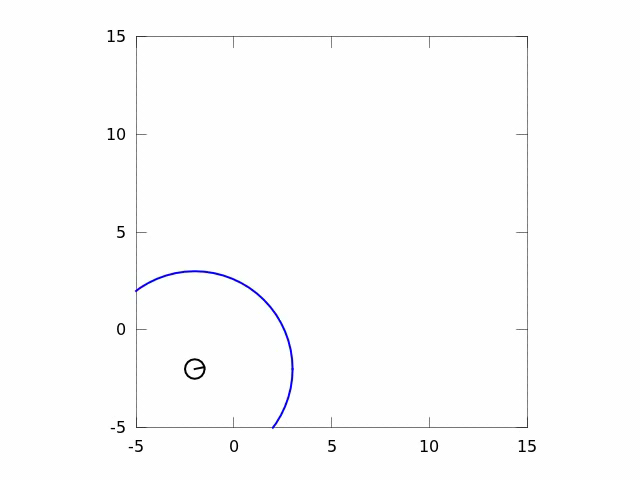
[picture p229: figure]

Visual Navigation for Flying Robots | 104 | Dr. Jürgen Sturm, Computer Vision Group, TUM
- If we are aware of a bad initial guess, we set the initial sigma to a large value (large uncertainty)

## Example

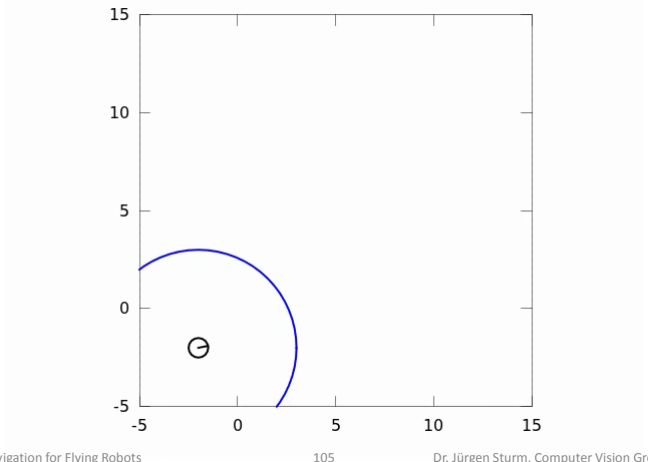
[picture p230: figure]

Visual Navigation for Flying Robots | 105 | Dr. Jürgen Sturm, Computer Vision Group, TUM

## Lessons Learned Today

- Observations and actions are inherently noisy
- Knowledge about state is inherently uncertain
- Probability theory
- Probabilistic sensor and motion models
- Bayes Filter, Histogram Filter, Kalman Filter, Examples
Visual Navigation for Flying Robots | 106 | Dr. Jürgen Sturm, Computer Vision Group, TUM
