YoshuaNava/TesisCuadricoptero/Referencias/FULLTEXT01.pdf

Document name

Military Quadrotor

Author | Approved by | Date of issue | Page
Mathias Wannberg | Owe Lyrsell | 2012-7-2 | 1 (62)
Address | Gävlegatan 22
SE-113 30 Stockholm, Sweden

Phone:
Fax:

+46-(0)8-674 12 00
+46-(0)8-674 12 01
Web | www.etteplan.com

## The Quadrotor Platform

from a military point of view

Mathias Wannberg

mwan@kth.se

7/2/2012

Author | Document name | Date of issue | Page
Mathias Wannberg | Military Quadrotor | 2012-07-09 | 2 (62)

## Abstract

The use of military UAV’s has become increasingly popular amongst the military powers of the world. But most of these UAV’s lack the vertical take-off and landing (VTOL) ability. This report investigates the quadrotor which is an excellent VTOL platform. The main disadvantage that the quadrotor platform possesses is that it suffers from poor performance if compared to airplanes. Quadrotors lack the endurance and the capability to carry heavy payloads. An effort is to be done to investigate the possible application area of use for the quadrotor platform from a military point of view. In order to solve these problems, two COTS (Commercial off the Shelf) quadrotors has been bought and a number of test flights have been performed with them. The results from these tests have been evaluated in MATLAB and a number of simulation models have been created in order to get a clear picture of the quadrotors potential. Rotorcraft such as the quadrotor is affected by the aerodynamic phenomena of induced power, this phenomena is important to understand when designing a control system for the quadrotor and when optimizing its endurance. A number of suggestions for how to improve the quadrotor platform have been proposed such as using ducted propellers, hybrid fuel systems, gyroscopes, and micro technology. A simulation model has been created that predicts the time that a quadrotor of a given size carrying different payloads could maintain itself in hover, this model show that battery based quadrotors are limited in how big they can be made. Much work has been dedicated to the extended sight concept where the quadrotor is intended to be powered by a cable and serve as a
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
