YoshuaNava/TesisCuadricoptero/Circuitos/CircuitoDiodos.png

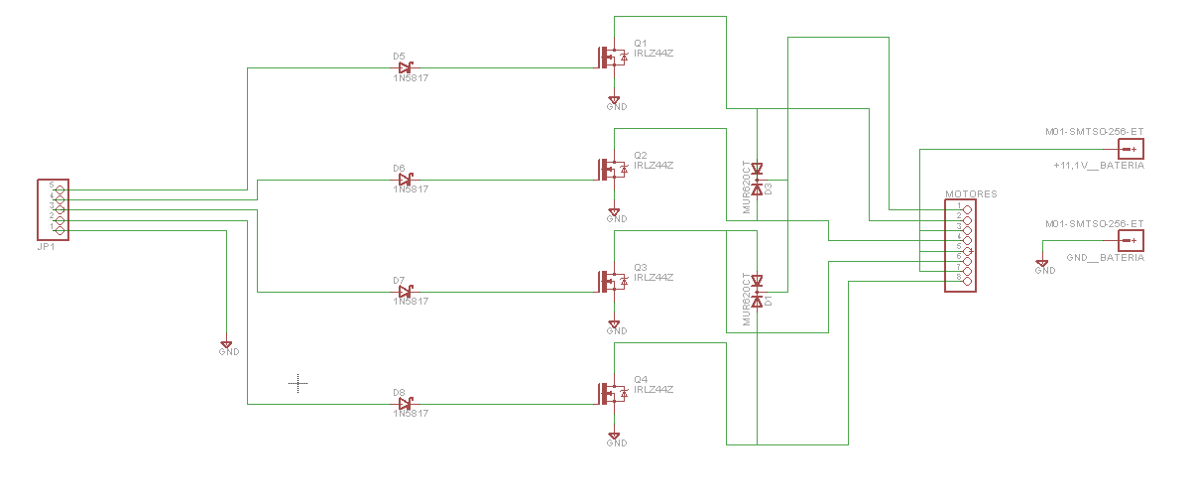
Circuitos/CircuitoDiodos.png
