YoshuaNava/TesisCuadricoptero/Circuitos/CircuitoOptocoupler.png

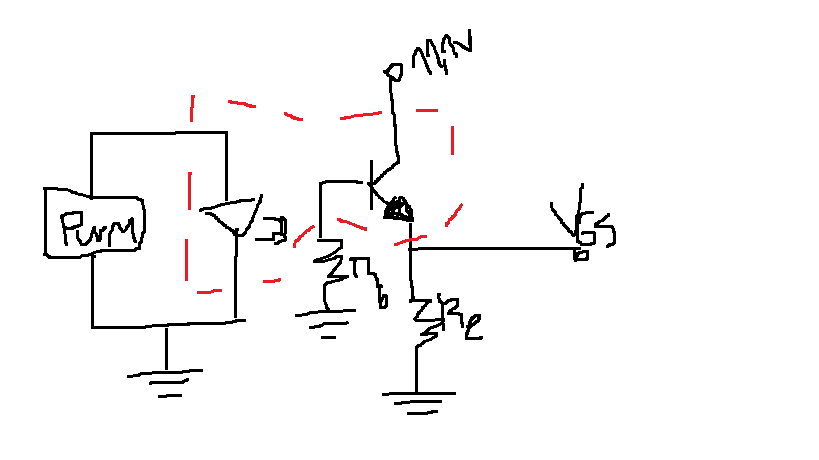
Circuitos/CircuitoOptocoupler.png
