YoshuaNava/TesisCuadricoptero/Circuitos/Datasheets/FR307.jpg

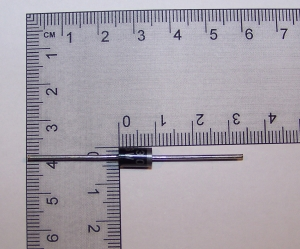
Circuitos/Datasheets/FR307.jpg
