YoshuaNava/TesisCuadricoptero/Circuitos/Datasheets/MOSFETs que venían de fábrica.jpg

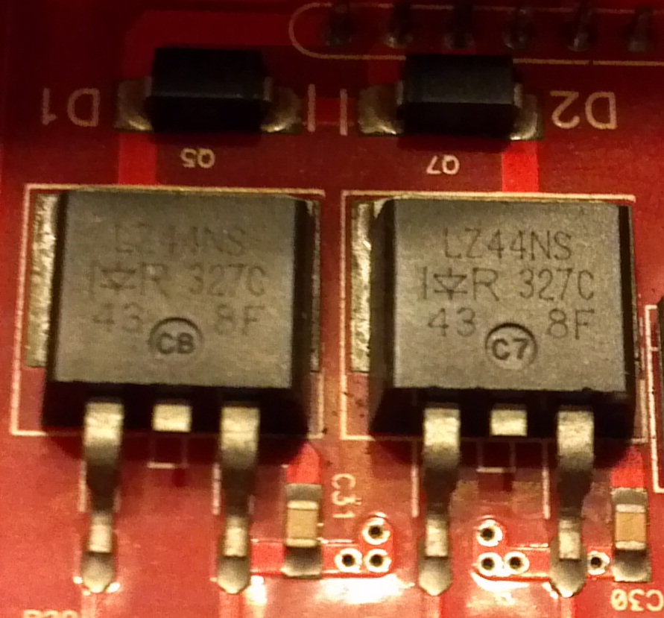
Circuitos/Datasheets/MOSFETs que venían de fábrica.jpg
