YoshuaNava/TesisCuadricoptero/Circuitos/EsquemaCircuito.png

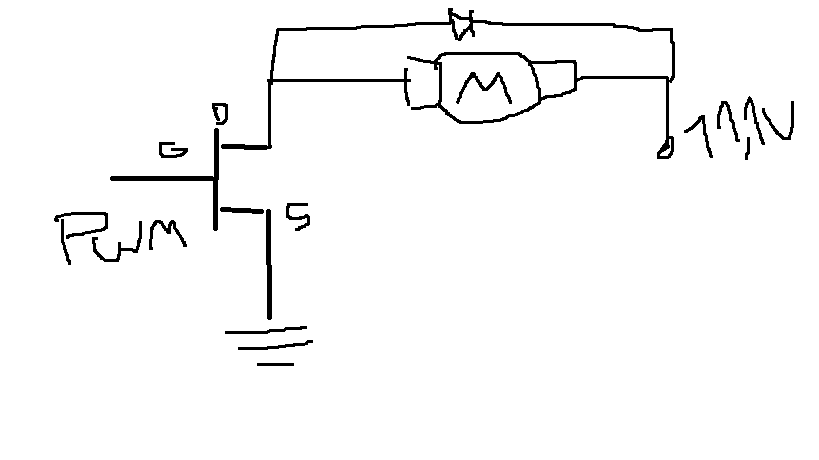
Circuitos/EsquemaCircuito.png
