YoshuaNava/TesisCuadricoptero/Documento/CapturasPantallaROS/Captura_rqt_graph.png

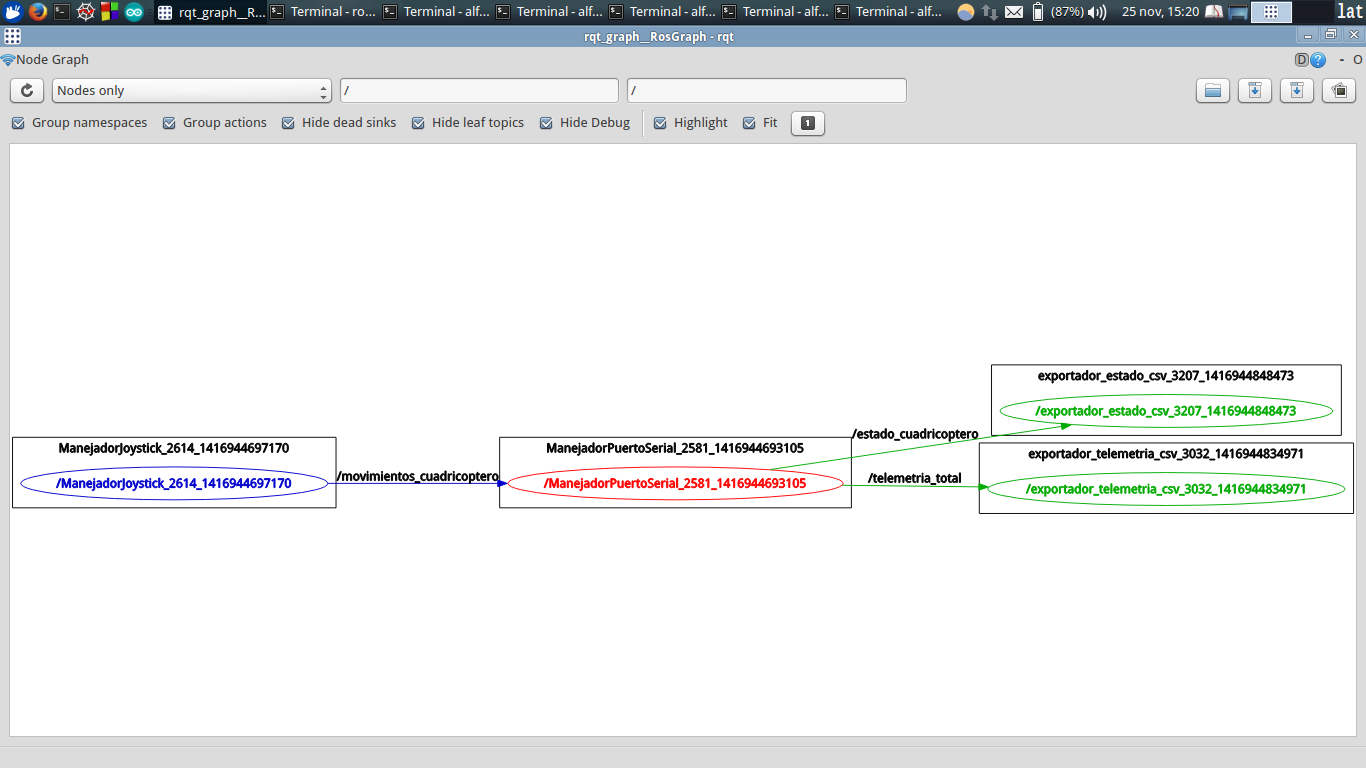
Documento/CapturasPantallaROS/Captura_rqt_graph.png
