YoshuaNava/TesisCuadricoptero/Documento/CaracterizacionSensoresPID/EstimacionVelocidadZ.png

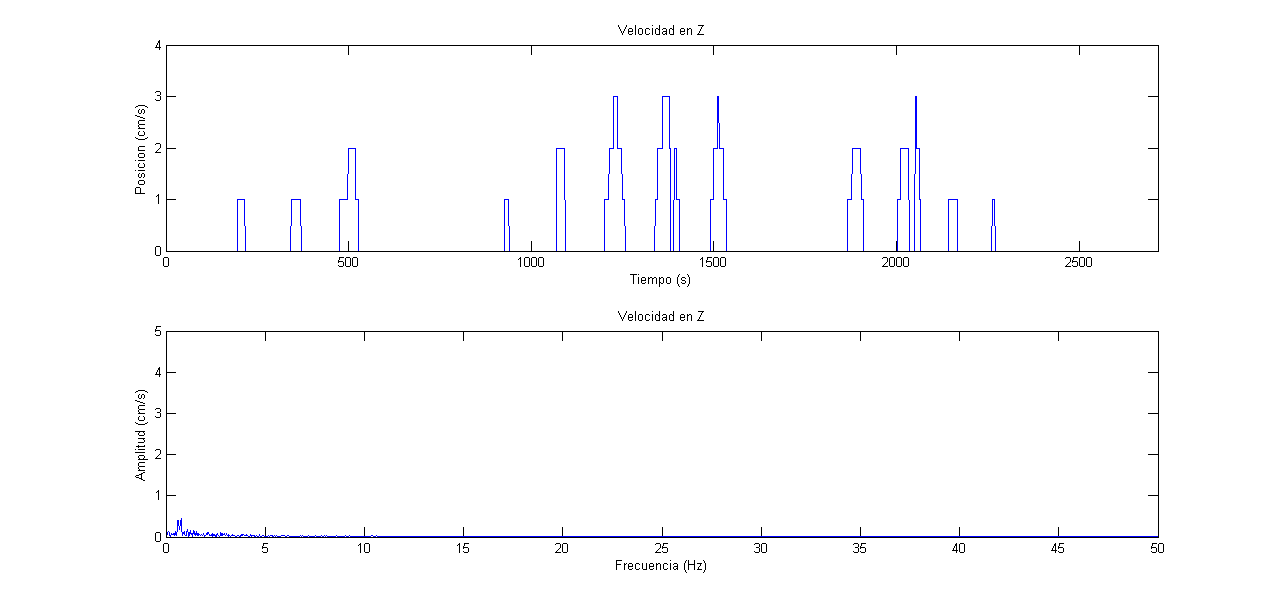
Documento/CaracterizacionSensoresPID/EstimacionVelocidadZ.png
