YoshuaNava/TesisCuadricoptero/Documento/CaracterizacionSensoresPID/FiltradoSensorUltrasonicoDistancia.png

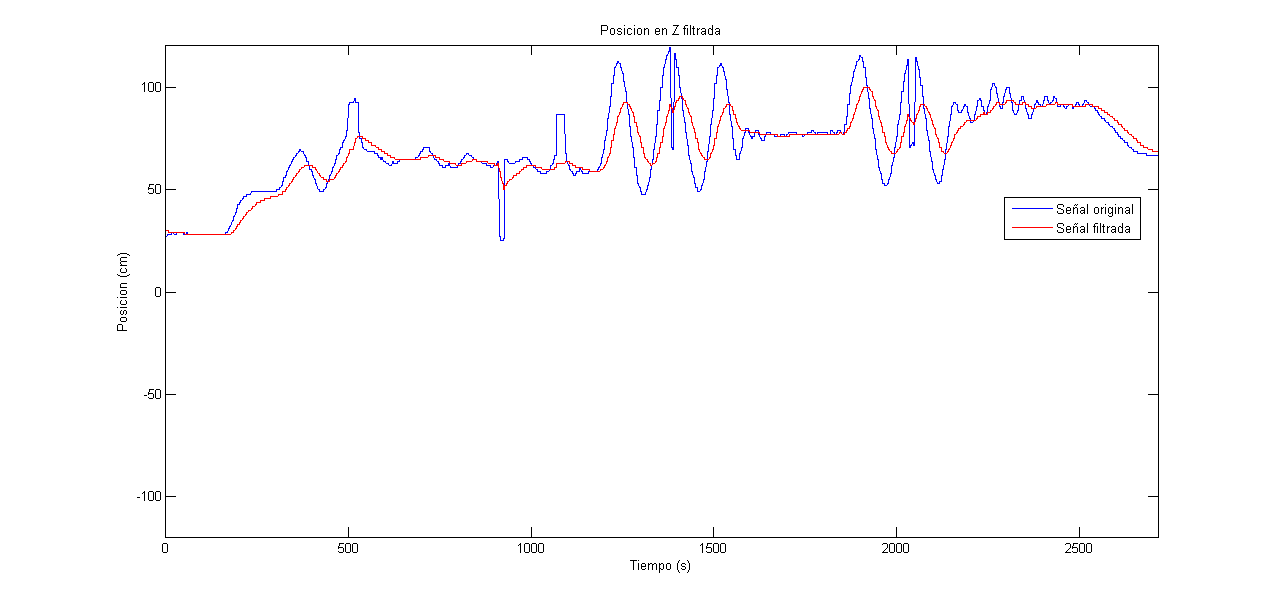
Documento/CaracterizacionSensoresPID/FiltradoSensorUltrasonicoDistancia.png
