YoshuaNava/TesisCuadricoptero/Documento/CaracterizacionSensoresPID/RendimientoPID_posicionAngularYaw_08012015.jpg

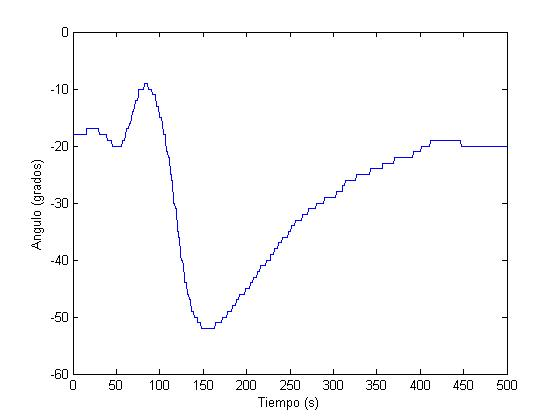
Documento/CaracterizacionSensoresPID/RendimientoPID_posicionAngularYaw_08012015.jpg
