YoshuaNava/TesisCuadricoptero/Documento/CaracterizacionSensoresPID/RendimientoPID_velocidadAngularYaw_08012015.jpg

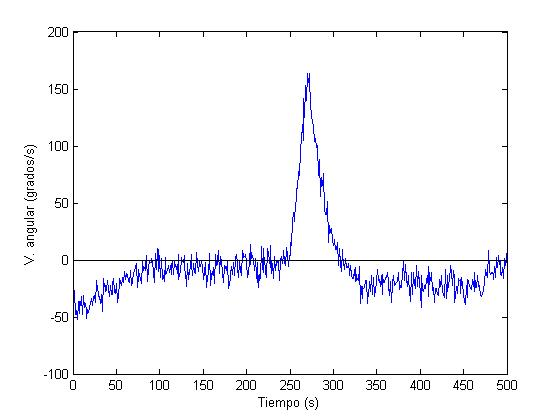
Documento/CaracterizacionSensoresPID/RendimientoPID_velocidadAngularYaw_08012015.jpg
