YoshuaNava/TesisCuadricoptero/Documento/CaracterizacionSensoresPID/RespuestaFrecuenciaSensorUltrasonicoDistanciaFiltrado.png

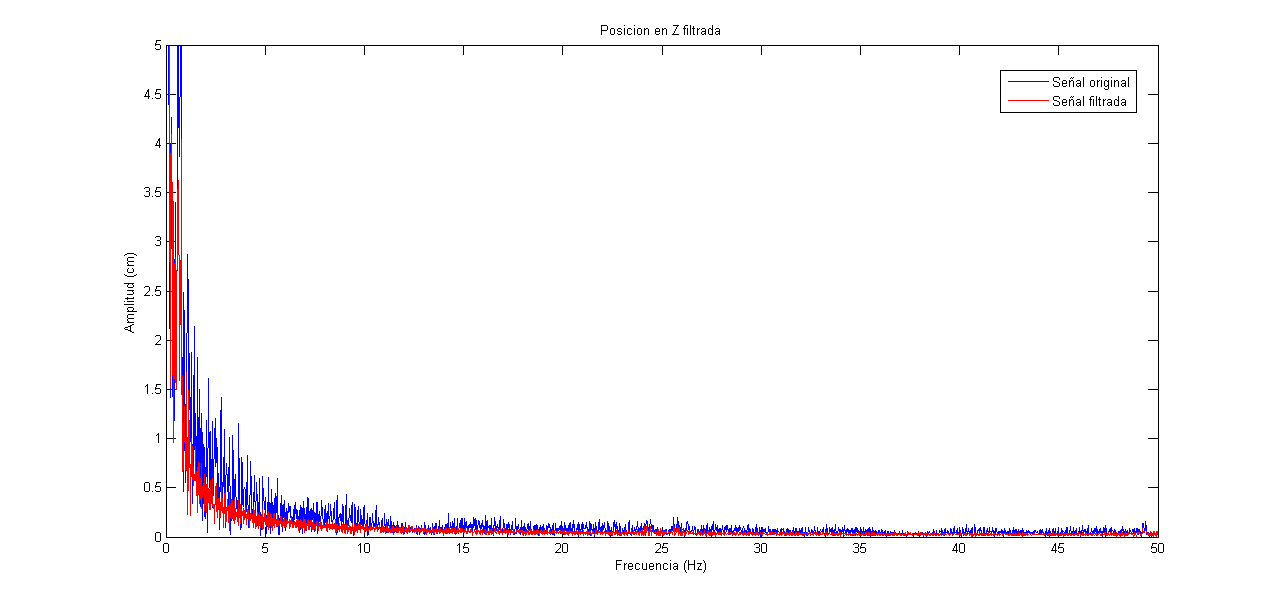
Documento/CaracterizacionSensoresPID/RespuestaFrecuenciaSensorUltrasonicoDistanciaFiltrado.png
