YoshuaNava/TesisCuadricoptero/Documento/Diagramas/ArquitecturaSoftware.png

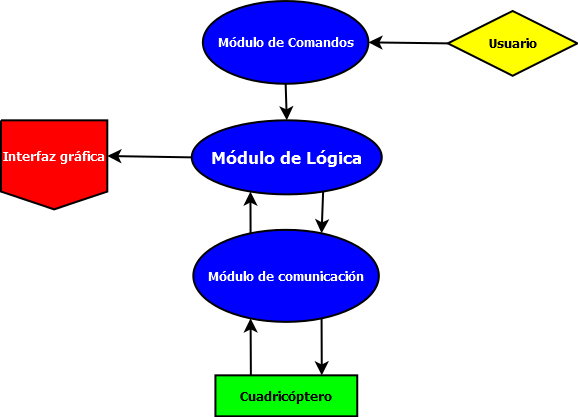
Documento/Diagramas/ArquitecturaSoftware.png
