YoshuaNava/TesisCuadricoptero/Documento/Diagramas/comunicacion arduino PC.jpg

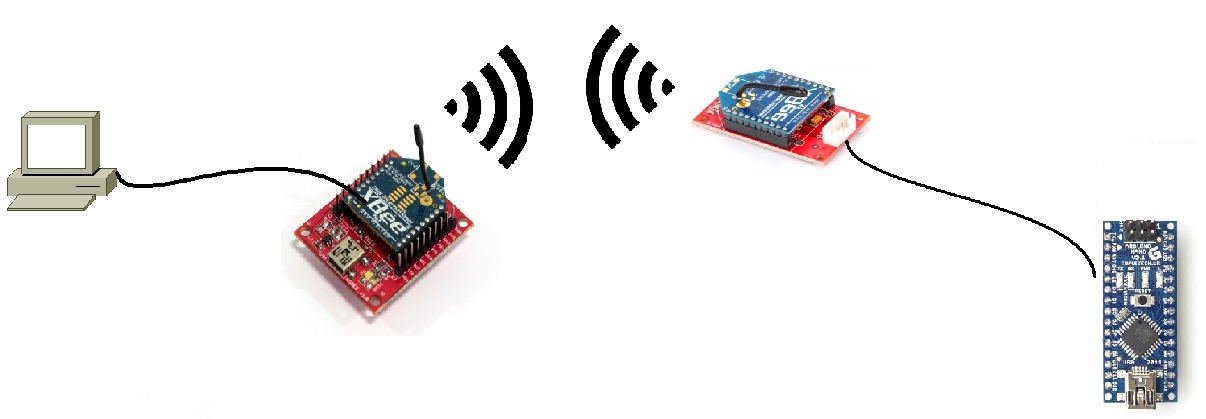
Documento/Diagramas/comunicacion arduino PC.jpg
