YoshuaNava/TesisCuadricoptero/Documento/Diagramas/Estimacion altura y velocidad de elevacion.jpeg

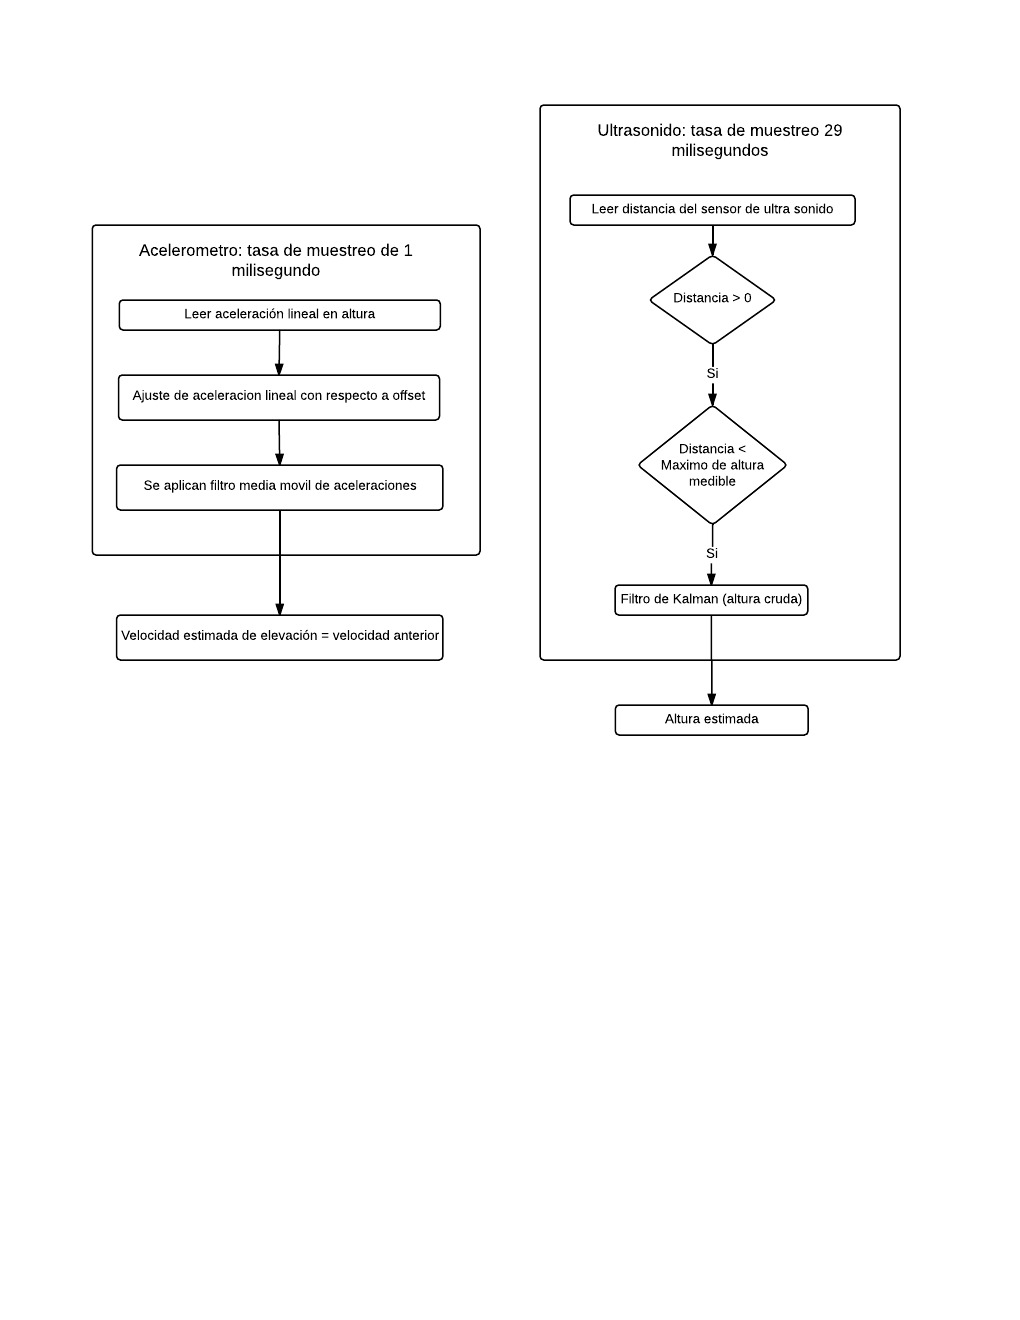
Documento/Diagramas/Estimacion altura y velocidad de elevacion.jpeg
