YoshuaNava/TesisCuadricoptero/Fotos/05-09-2014/DSC_0121.JPG

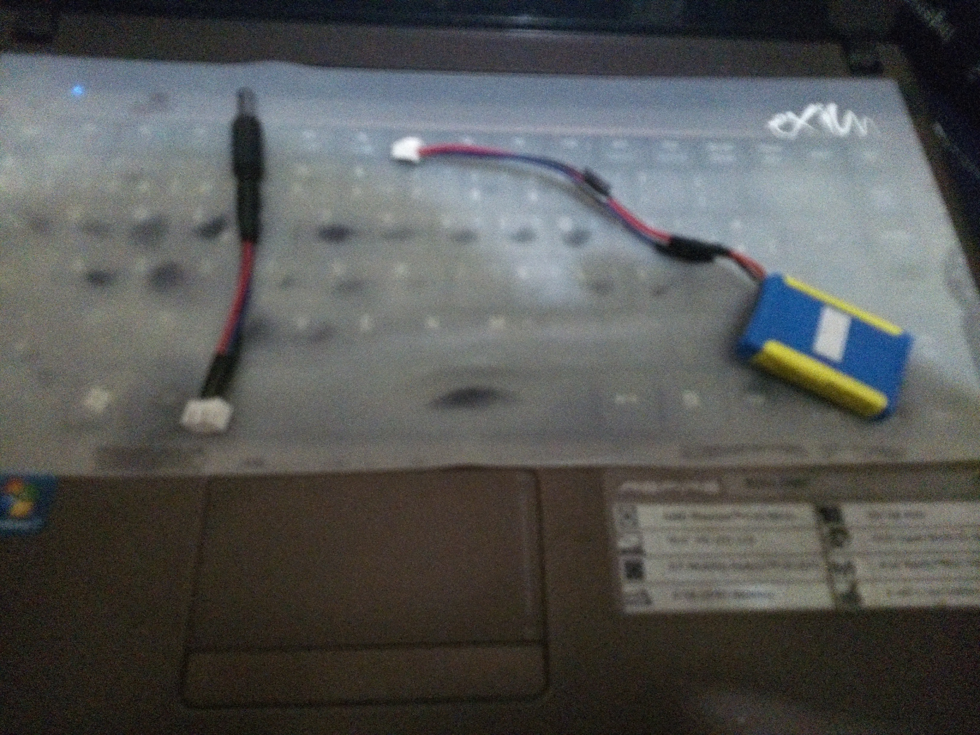
Fotos/05-09-2014/DSC_0121.JPG
