YoshuaNava/TesisCuadricoptero/Fotos/05-09-2014/DSC_0135.JPG

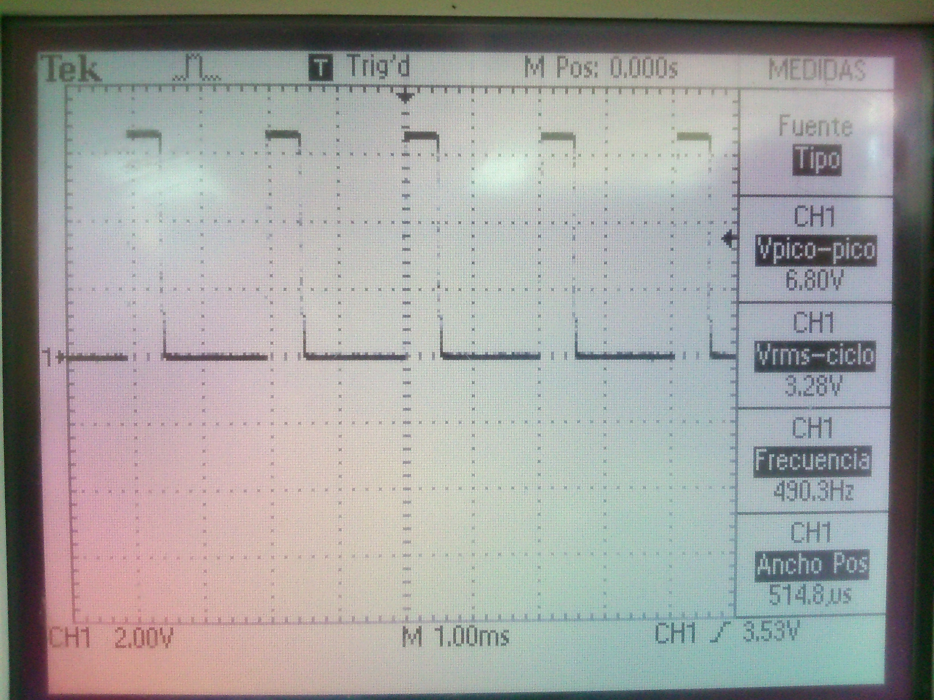
Fotos/05-09-2014/DSC_0135.JPG
