YoshuaNava/TesisCuadricoptero/Fotos/DSC_0097.JPG

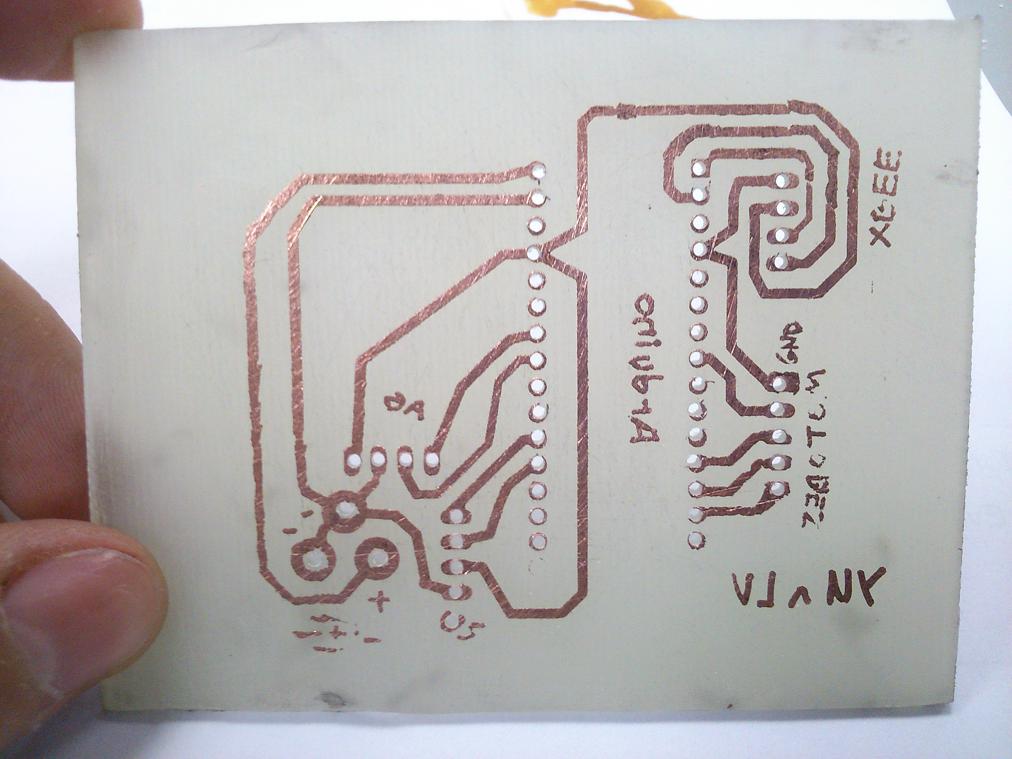
Fotos/DSC_0097.JPG
