YoshuaNava/TesisCuadricoptero/Fotos/DSC_0107.jpg

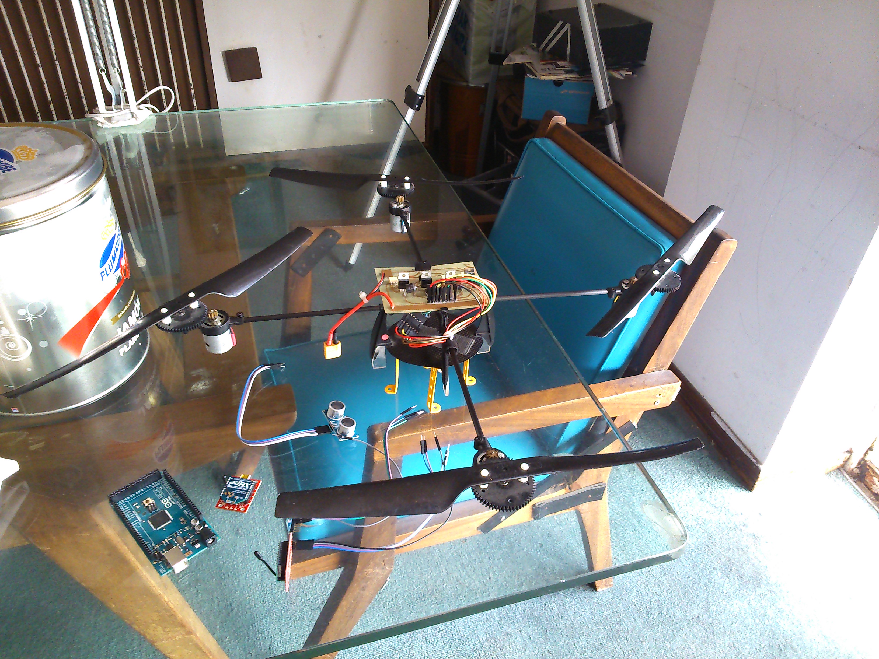
Fotos/DSC_0107.jpg
