YoshuaNava/TesisCuadricoptero/Fotos/DSC_0114.jpg

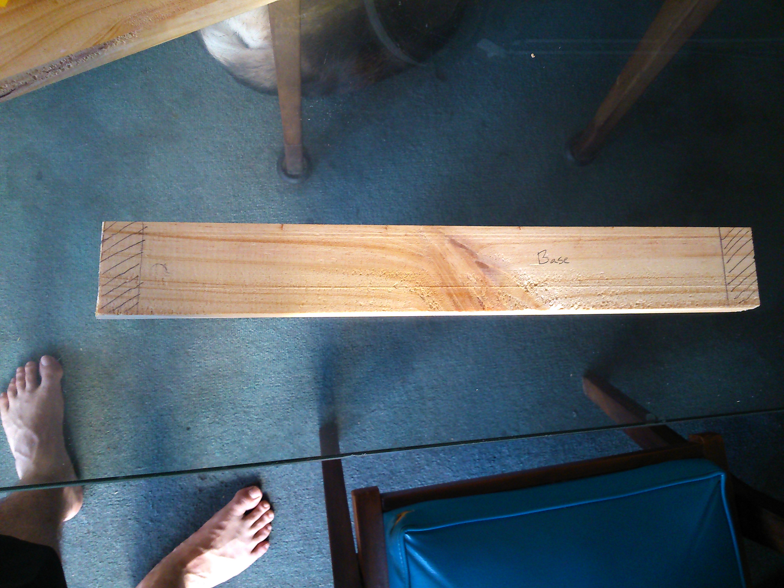
Fotos/DSC_0114.jpg
