YoshuaNava/TesisCuadricoptero/Fotos/DSC_0115.jpg

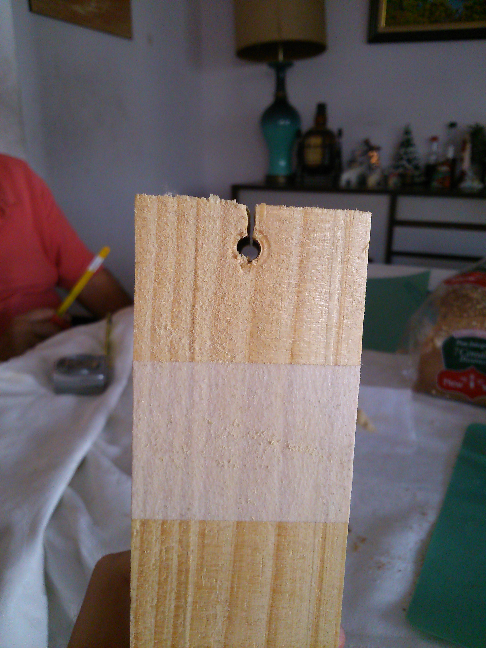
Fotos/DSC_0115.jpg
