YoshuaNava/TesisCuadricoptero/Fotos/DSC_0119.jpg

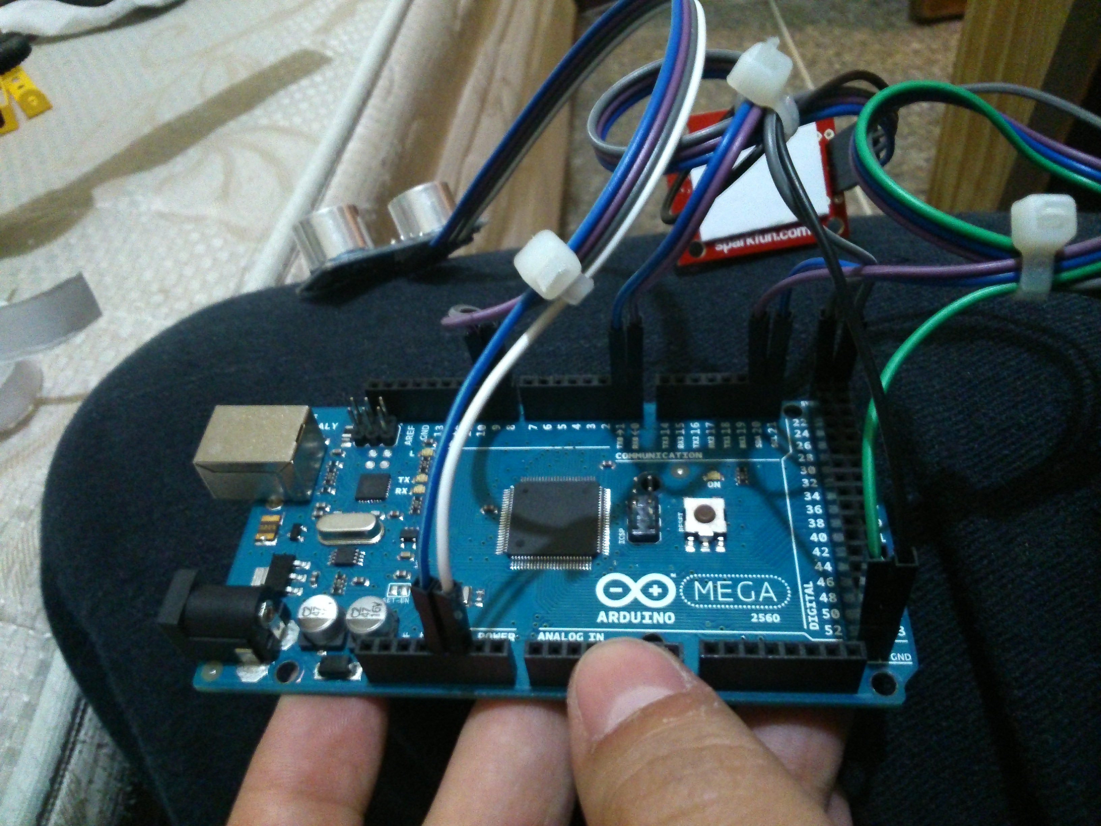
Fotos/DSC_0119.jpg
