YoshuaNava/TesisCuadricoptero/Fotos/DSC_0122.JPG

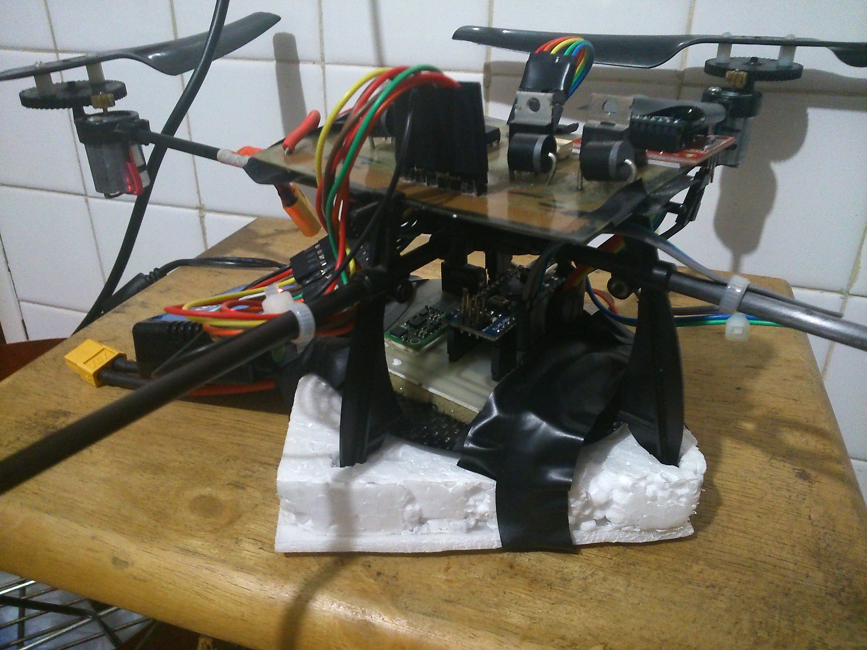
Fotos/DSC_0122.JPG
