YoshuaNava/TesisCuadricoptero/Fotos/DSC_0124.JPG

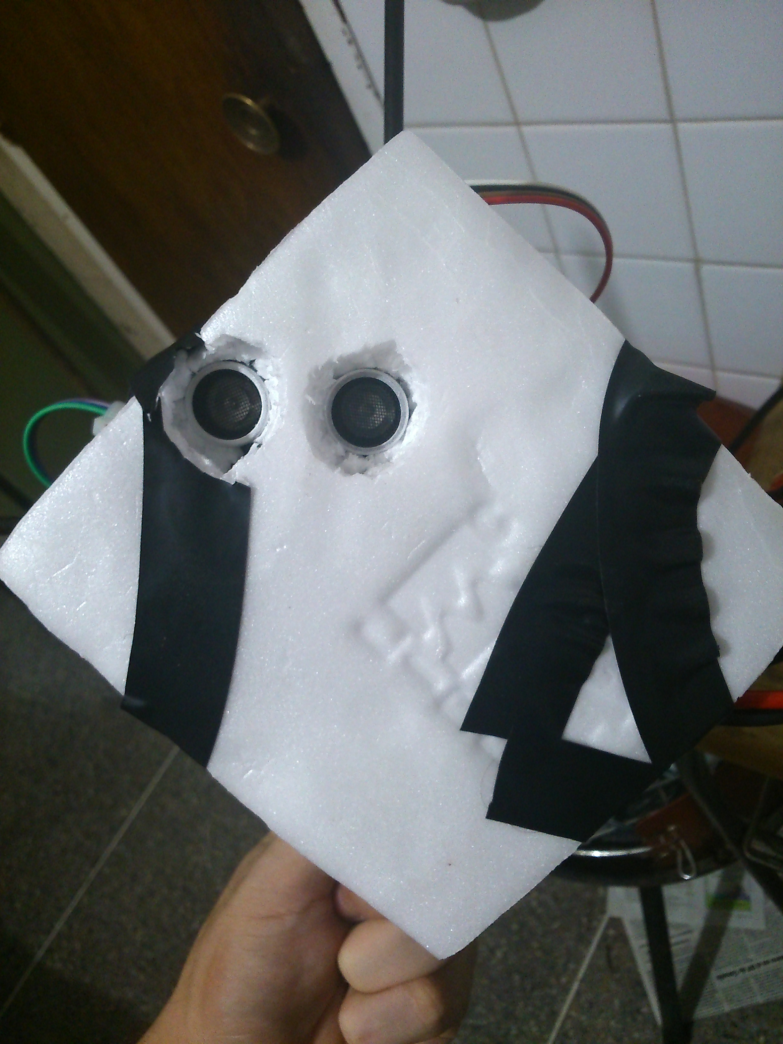
Fotos/DSC_0124.JPG
