YoshuaNava/TesisCuadricoptero/Fotos/DSC_0126.JPG

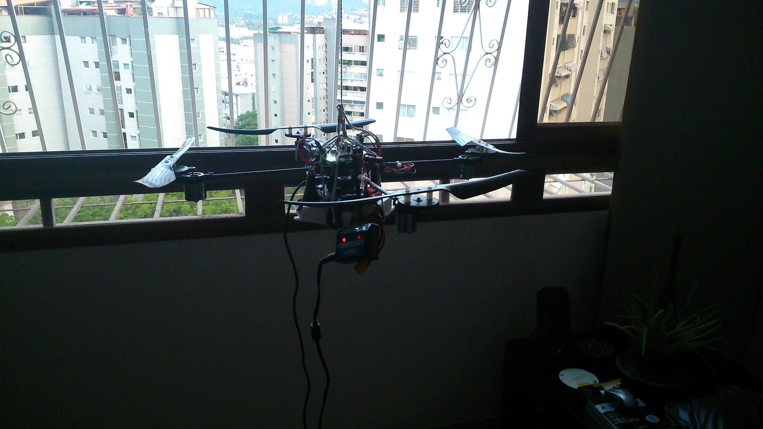
Fotos/DSC_0126.JPG
