YoshuaNava/TesisCuadricoptero/Fotos/DSC_0127.JPG

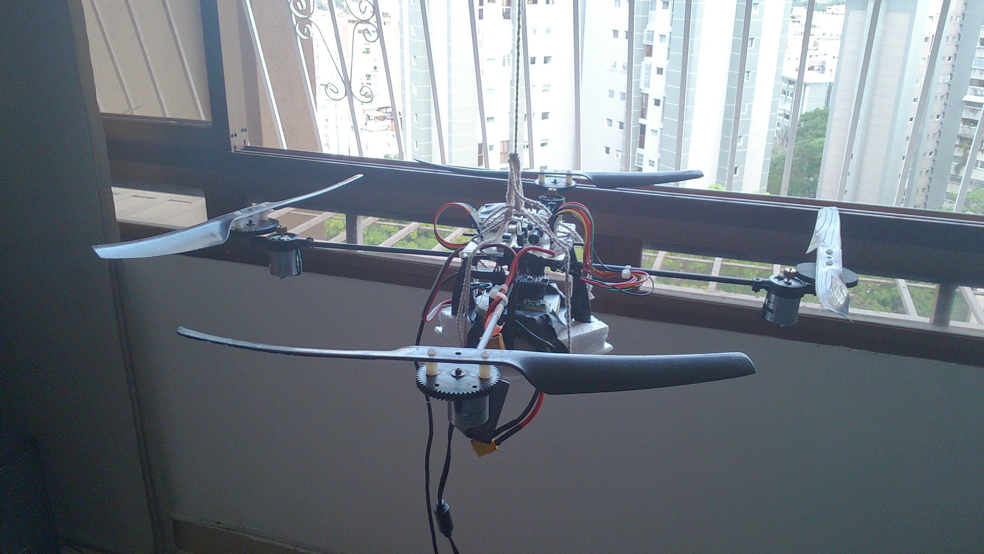
Fotos/DSC_0127.JPG
