YoshuaNava/TesisCuadricoptero/Fotos/DSC_0135.JPG

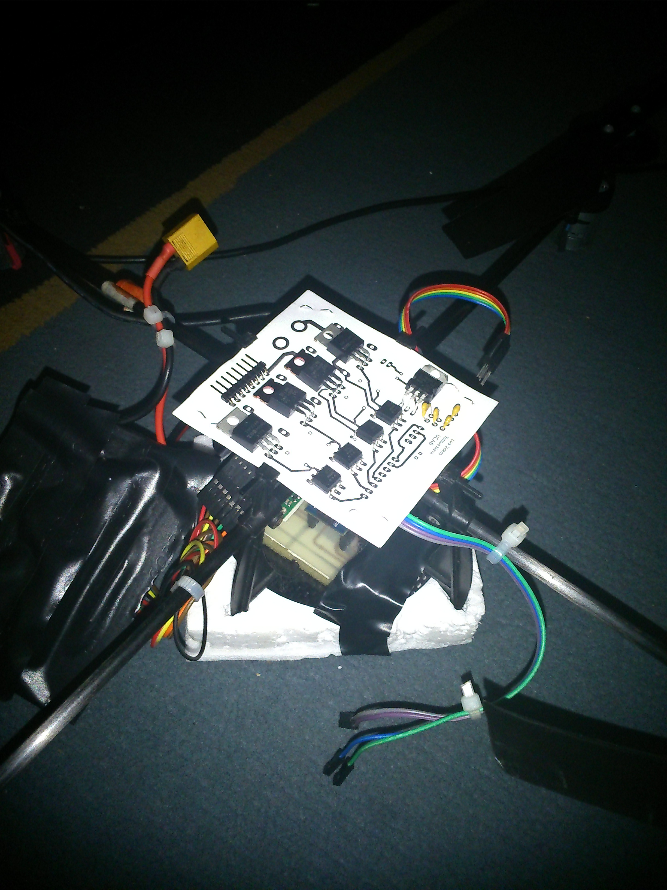
Fotos/DSC_0135.JPG
