YoshuaNava/TesisCuadricoptero/Fotos/DSC_0163.JPG

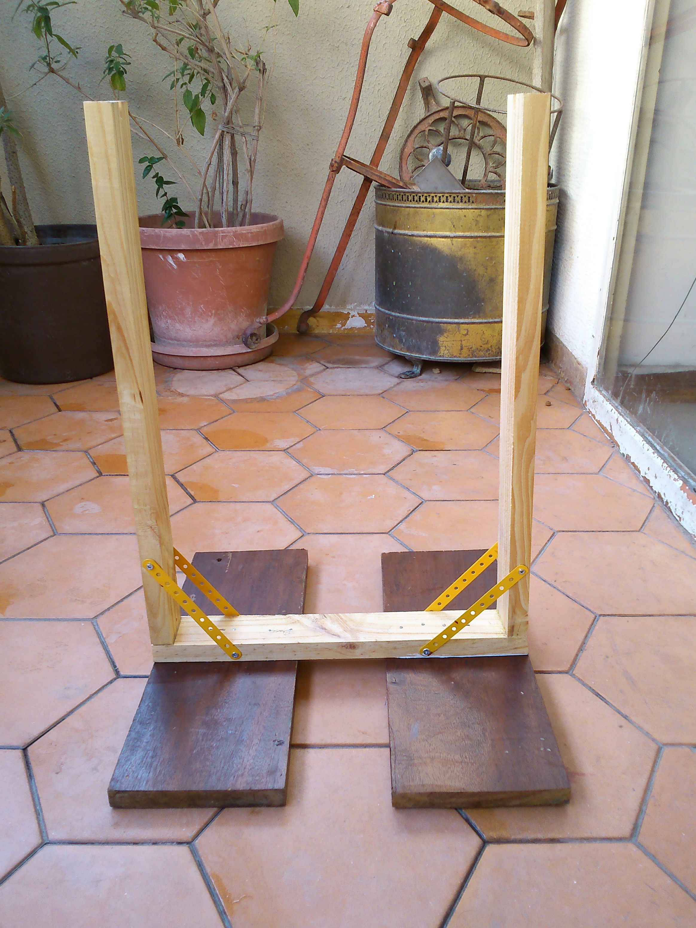
Fotos/DSC_0163.JPG
