YoshuaNava/TesisCuadricoptero/Fotos/DSC_0180.JPG

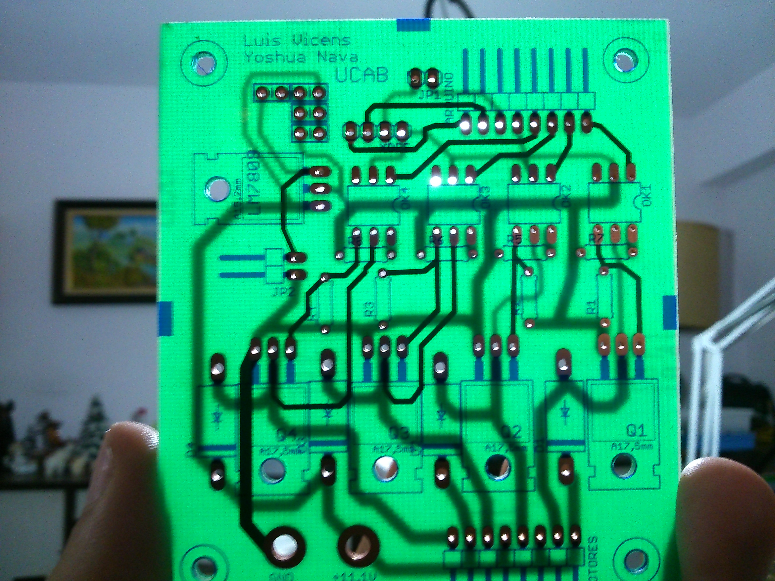
Fotos/DSC_0180.JPG
