YoshuaNava/TesisCuadricoptero/Fotos/DSC_0181.JPG

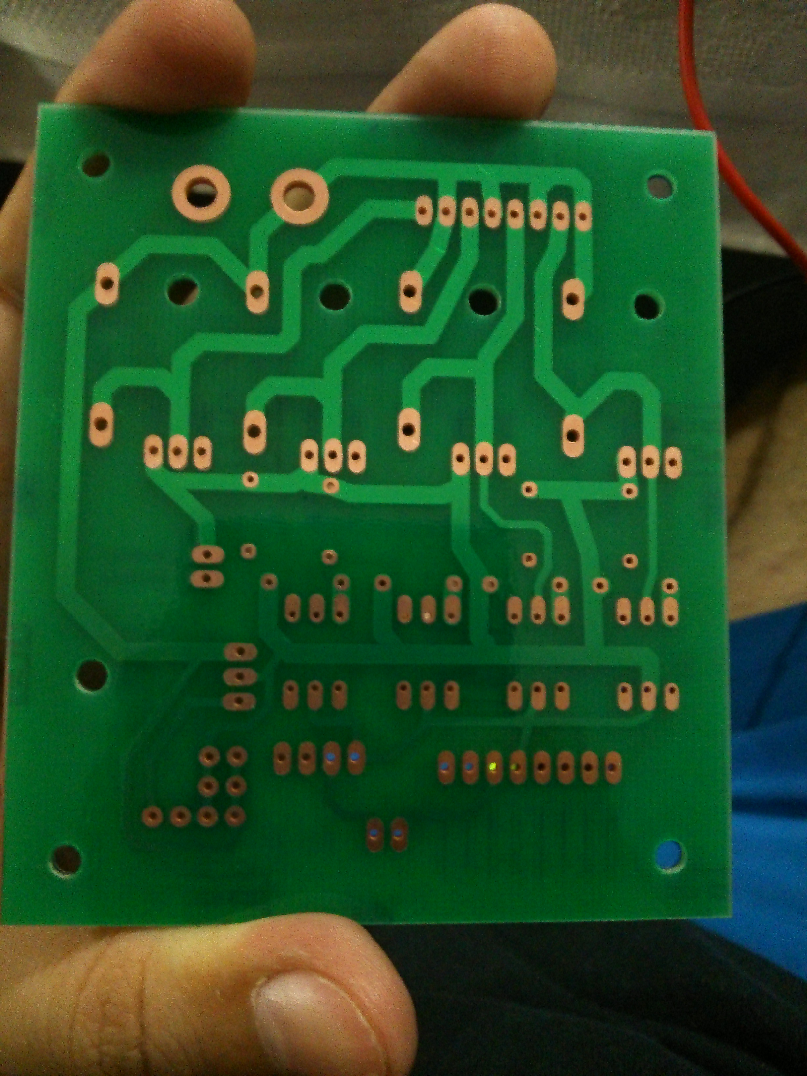
Fotos/DSC_0181.JPG
