YoshuaNava/TesisCuadricoptero/Fotos/DSC_0182.JPG

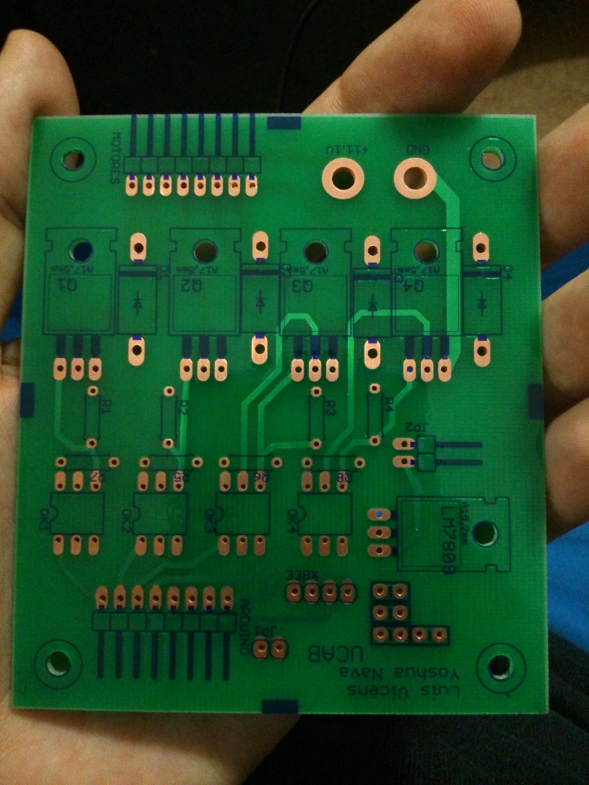
Fotos/DSC_0182.JPG
