YoshuaNava/TesisCuadricoptero/Fotos/DSC_0191.JPG

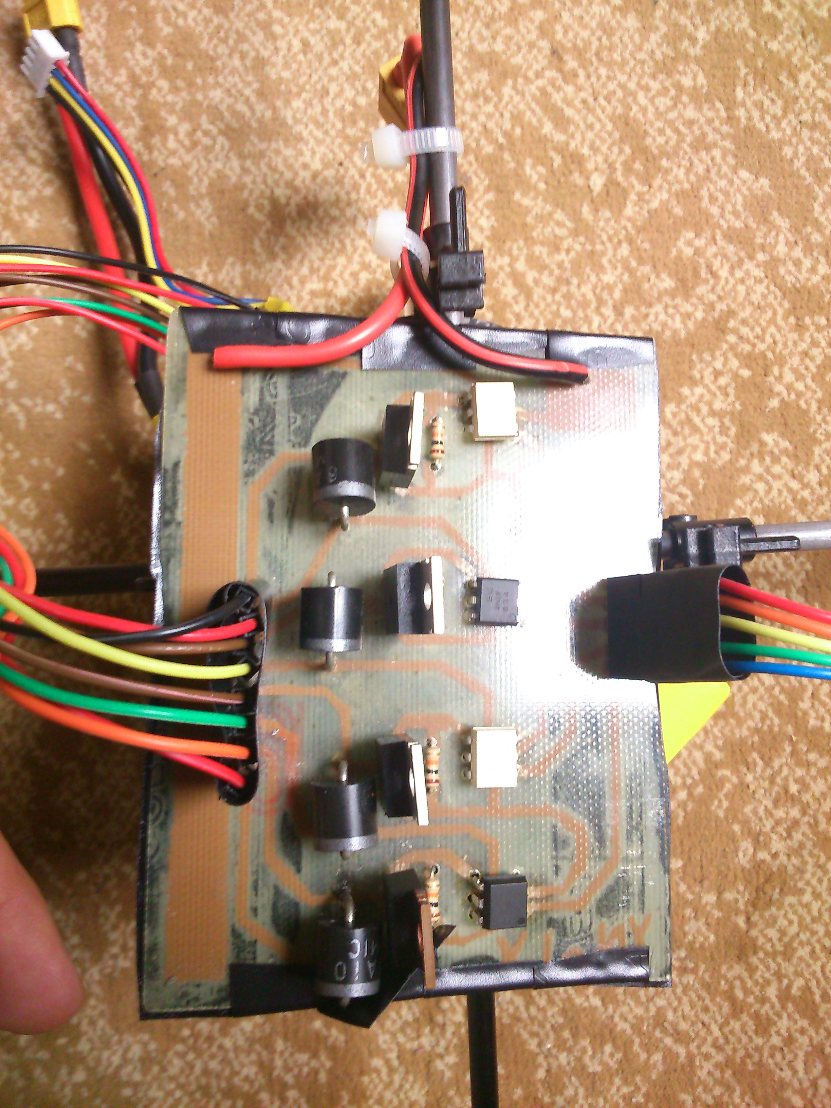
Fotos/DSC_0191.JPG
