YoshuaNava/TesisCuadricoptero/Fotos/DSC_0219.JPG

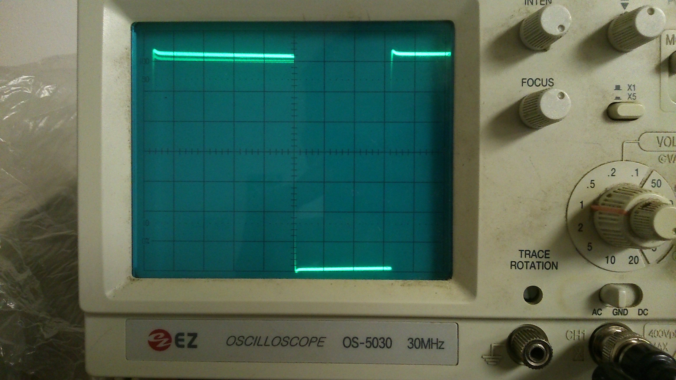
Fotos/DSC_0219.JPG
