YoshuaNava/TesisCuadricoptero/Fotos/DSC_0220.JPG

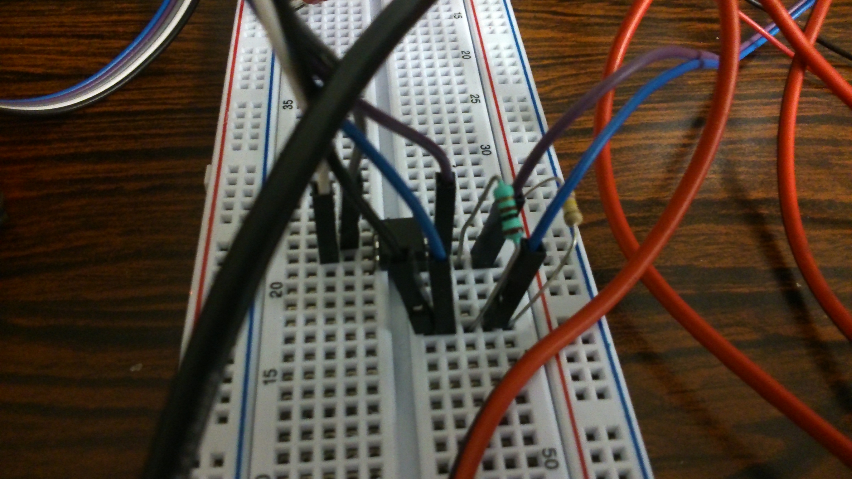
Fotos/DSC_0220.JPG
