YoshuaNava/TesisCuadricoptero/Fotos/DSC_0245.JPG

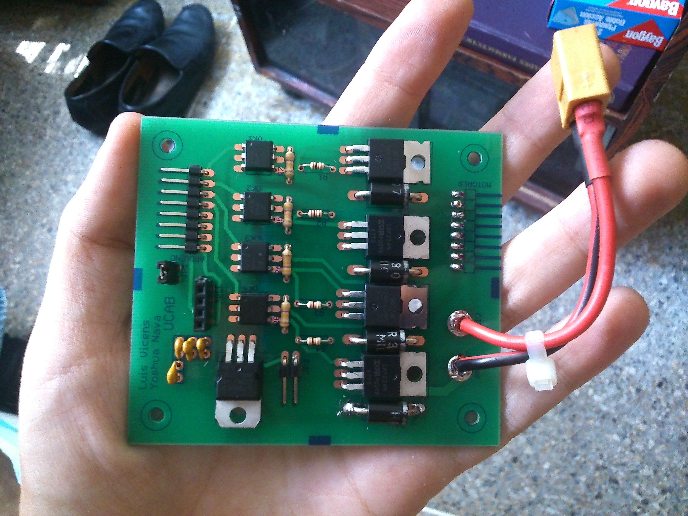
Fotos/DSC_0245.JPG
