YoshuaNava/TesisCuadricoptero/Fotos/DSC_0247.JPG

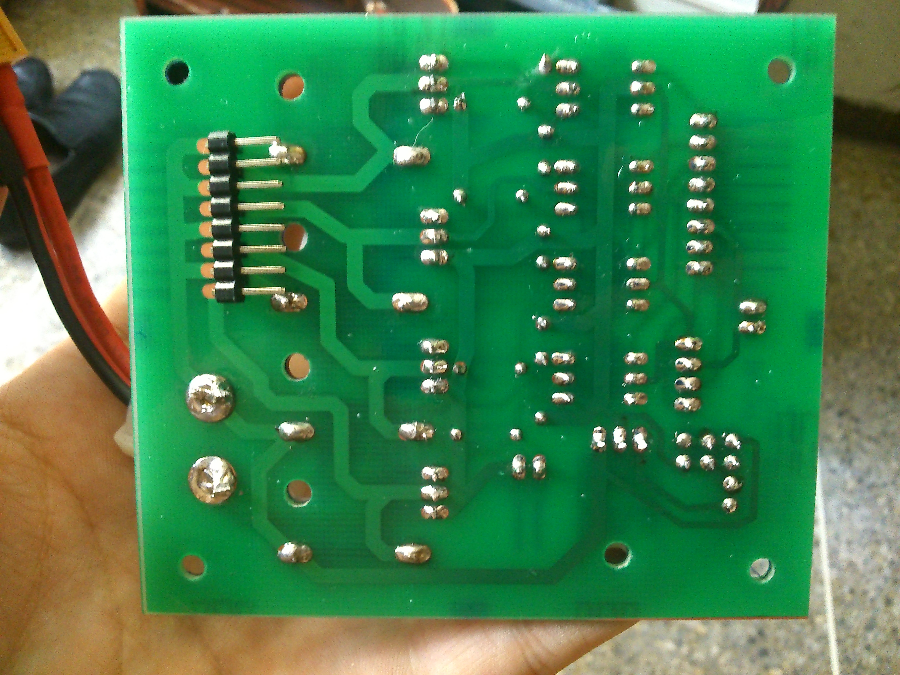
Fotos/DSC_0247.JPG
