YoshuaNava/TesisCuadricoptero/Fotos/DSC_0248.JPG

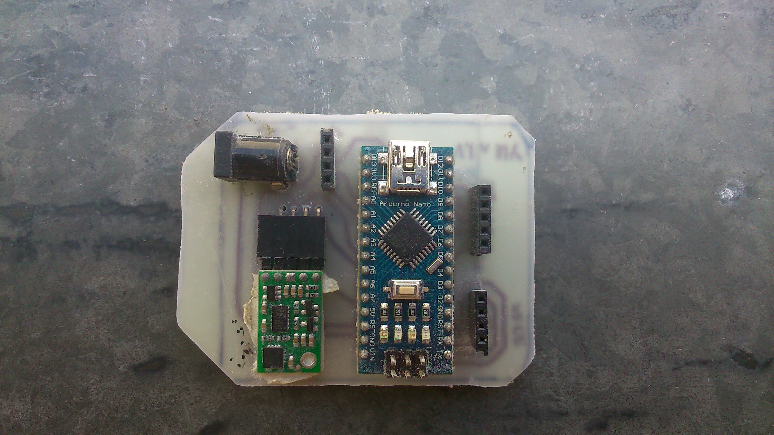
Fotos/DSC_0248.JPG
