YoshuaNava/TesisCuadricoptero/Fotos/IMG_20140119_162431.jpg

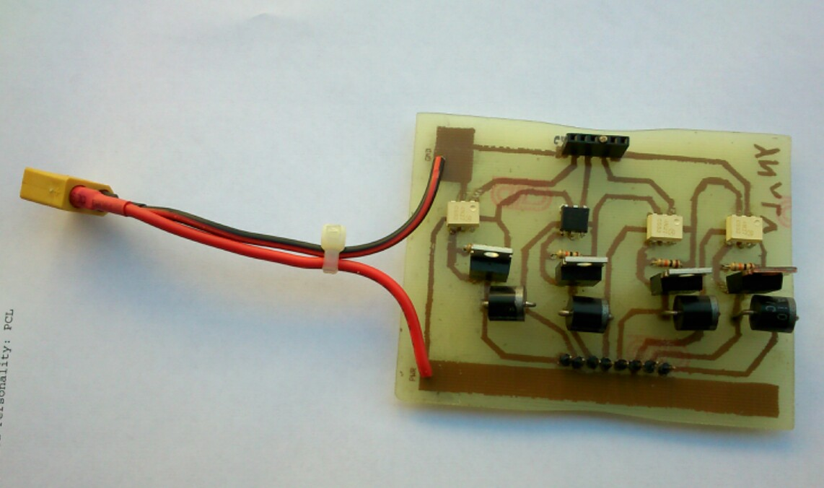
Fotos/IMG_20140119_162431.jpg
