YoshuaNava/TesisCuadricoptero/Fotos/IMG_20140119_162508.jpg

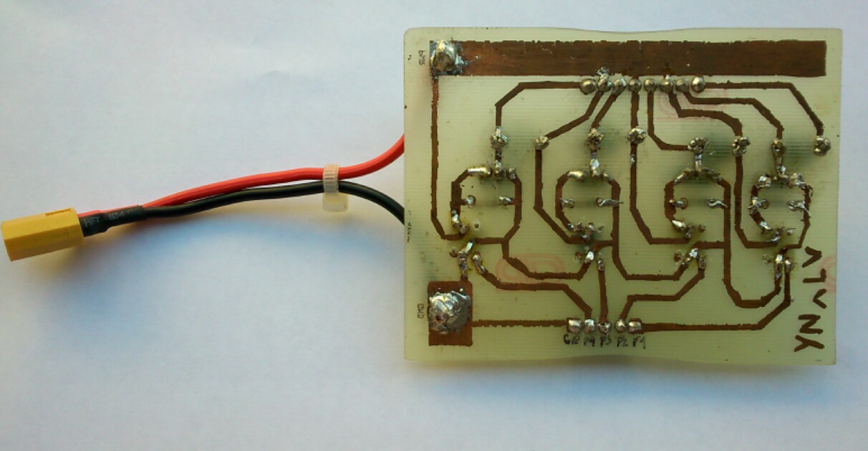
Fotos/IMG_20140119_162508.jpg
