YoshuaNava/TesisCuadricoptero/Fotos/IMG_20140313_173442.jpg

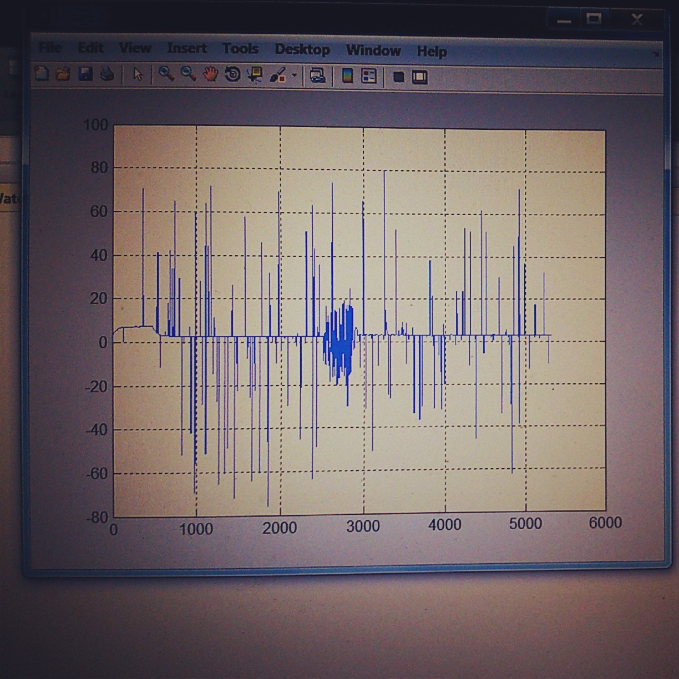
Fotos/IMG_20140313_173442.jpg
