YoshuaNava/TesisCuadricoptero/Fotos/IMG_20140329_142308.jpg

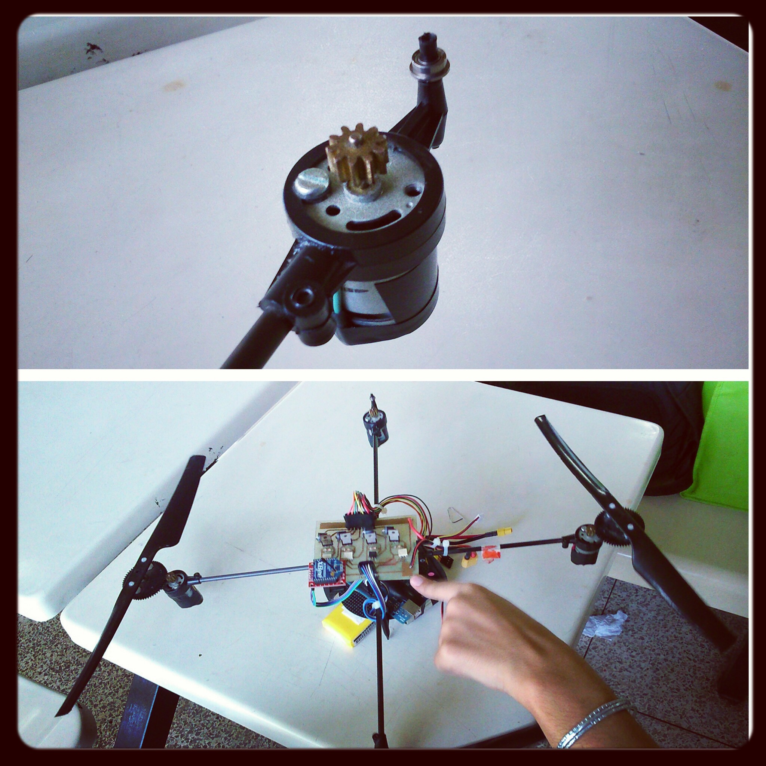
Fotos/IMG_20140329_142308.jpg
