YoshuaNava/TesisCuadricoptero/Fotos/IMG_20140414_145531.jpg

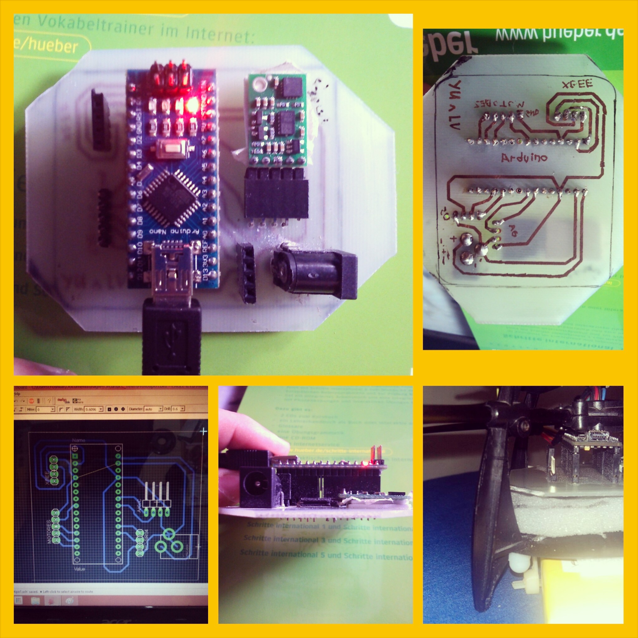
Fotos/IMG_20140414_145531.jpg
