YoshuaNava/TesisCuadricoptero/Modelo físico/RendimientoPIDVelocidad.png

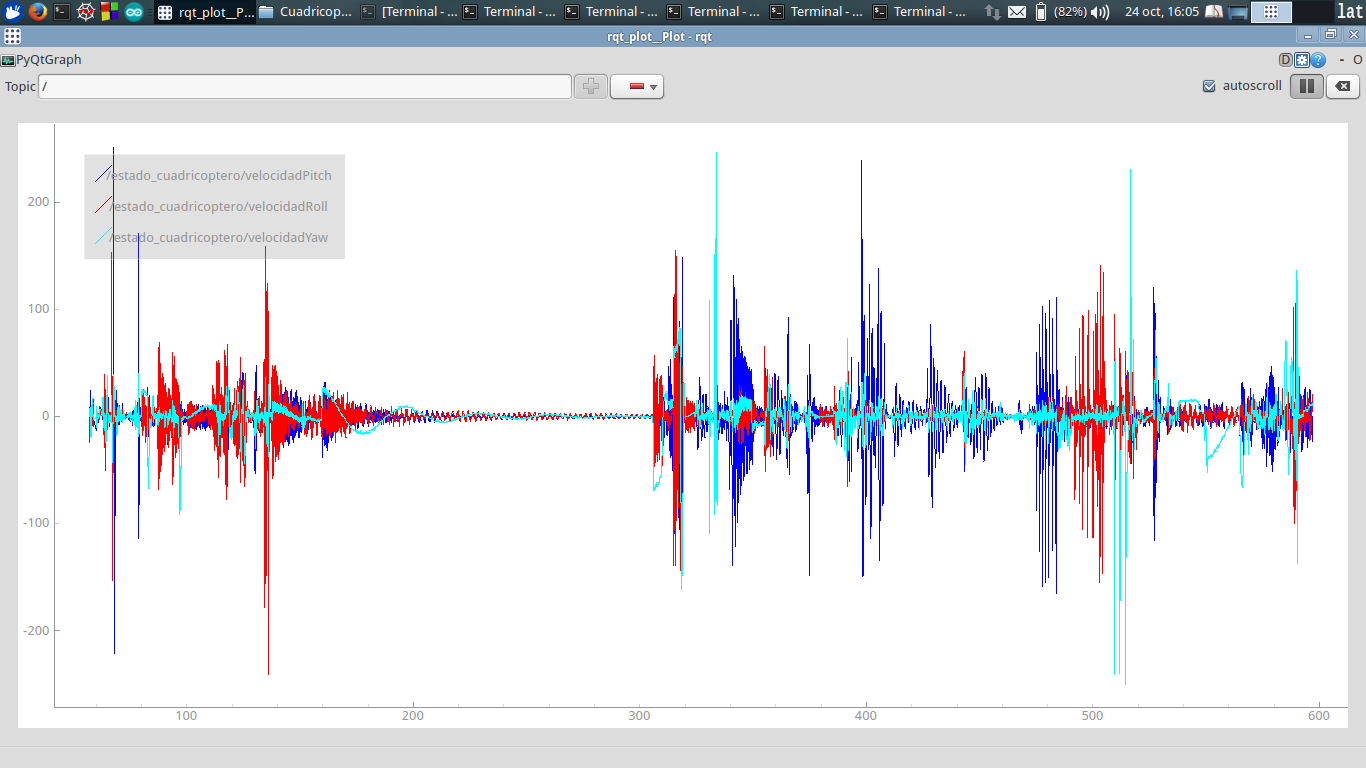
Modelo físico/RendimientoPIDVelocidad.png
