YoshuaNava/TesisCuadricoptero/Modelo físico/VibracionesGiroscopio.png

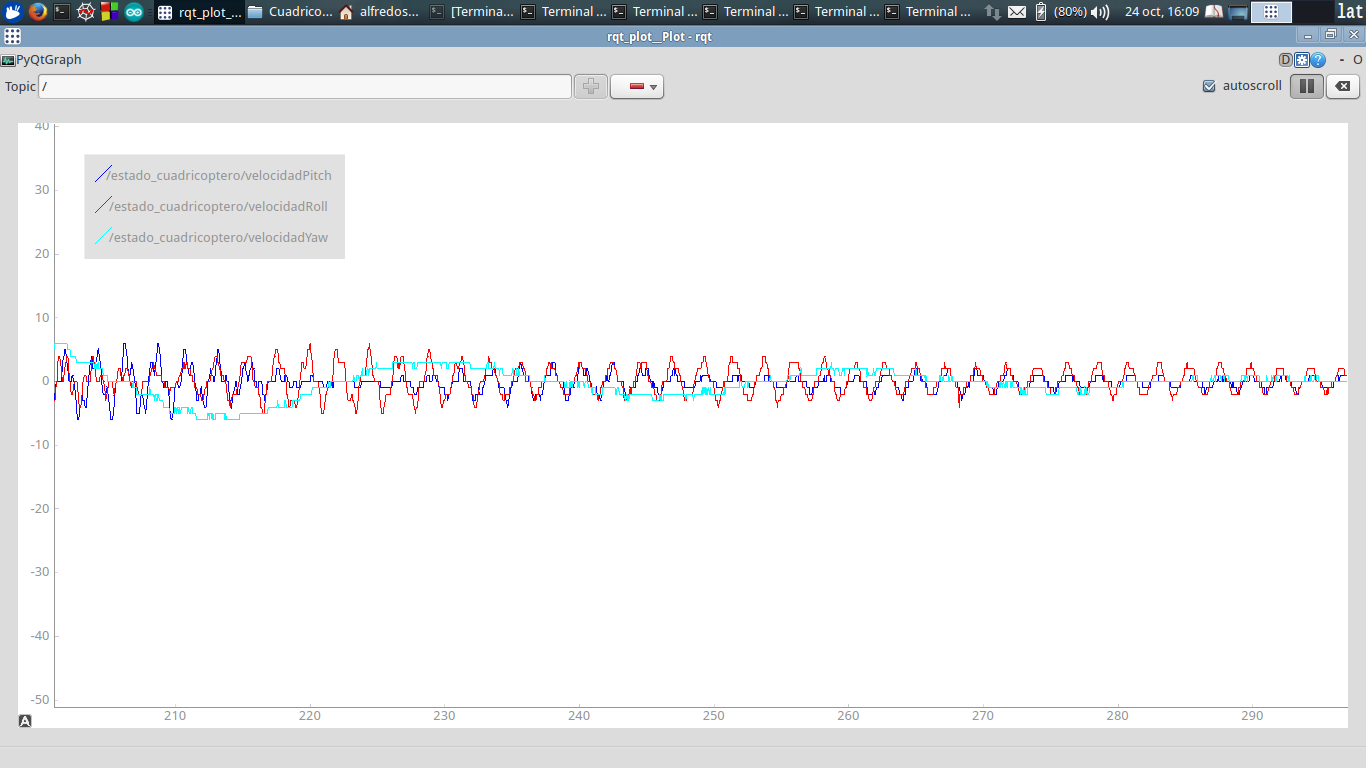
Modelo físico/VibracionesGiroscopio.png
