YoshuaNava/TesisCuadricoptero/Documento/Cuadro mensajes de telemetria.xlsx

Sheet: Hoja1
Tipo de mensaje | Codigo de mensaje | Contenido del mensaje
Mensaje de estado | 6 | Posición YAW positiva | Posición YAW negativa | Posición PITCH (de 0 a 180 siendo el valor 90 igual a 0 grados) | Posición ROLL (de 0 a 180 siendo el valor 90 igual a 0 grados) | Velocidad YAW positiva | Velocidad YAW negativa | Velocidad PITCH positiva | Velocidad PITCH Negativa | Velocidad ROLL positiva | Velocidad ROLL negativa | Altura | Estado Motores
Mensaje de telemetría completo | 8 | ESTMADO |  |  |  |  |  | BRUTO |  |  |  |  |  | FILTRADO |  |  |  |  |  | BRUTO |  |  |  |  |  | FILTRADO |  |  |  |  |  | BRUTO | FILTRADO | Estimado
 |  | Posición YAW positiva | Posición YAW positiva | Posición PITCH positiva | Posición PITCH positiva | Posición ROLL positiva | Posición ROLL positiva | Velocidad YAW positiva | Velocidad YAW positiva | Velocidad PITCH positiva | Velocidad PITCH positiva | Velocidad ROLL positiva | Velocidad ROLL positiva | Velocidad YAW positiva | Velocidad YAW positiva | Velocidad PITCH positiva | Velocidad PITCH positiva | Velocidad ROLL positiva | Velocidad ROLL positiva | Aceleracion YAW positiva | Aceleracion YAW positiva | Aceleracion PITCH positiva | Aceleracion PITCH positiva | Aceleracion ROLL positiva | Aceleracion ROLL positiva | Aceleracion YAW positiva | Aceleracion YAW positiva | Aceleracion PITCH positiva | Aceleracion PITCH positiva | Aceleracion ROLL positiva | Aceleracion ROLL positiva | altura | ALTURA | Velocidad Z positiva | Velocidad Z negativa | pwm motor delantero | pwm motor trasero | pwm motor derecho | pwm motor izquierdo
Mensaje de recibido | 7 | Código mensaje recibido
Mensaje de motores | 1 | · Para apagar motores: 0
 |  | · Para encender motores:1
Mensaje de movimiento | 2 | Movimiento Eje Roll |  |  |  | Movimiento Eje Pitch

Sheet: Hoja2
Tipo de mensaje | Estado | Telemetría completa |  | Acknowledge | Encendido de motores | Movimiento
Codigo de mensaje | 6 | 8 |  | 7 | 1 | 2
Contenido del mensaje | Posición YAW positiva | Estimado | Posición YAW positiva | Código mensaje recibido | Para apagar motores: 0 Para encender motores: 1 | Movimiento Eje Pitch
 | Posición YAW negativa |  | Posición YAW negativa
 | Posición PITCH (de 0 a 180 siendo el valor 90 igual a 0 grados) |  | Posición PITCH positiva
 | Posición ROLL (de 0 a 180 siendo el valor 90 igual a 0 grados) |  | Posición PITCH negativa
 | Velocidad YAW positiva |  | Posición ROLL positiva |  |  | Movimiento Eje Roll
 | Velocidad YAW negativa |  | Posición ROLL negativa
 | Velocidad PITCH positiva | Bruto | Velocidad YAW positiva
 | Velocidad PITCH Negativa |  | Velocidad YAW negativa
 | Velocidad ROLL positiva |  | Velocidad PITCH positiva |  |  | Movimiento de altura
 | Velocidad ROLL negativa |  | Velocidad PITCH positiva
 | Altura |  | Velocidad ROLL positiva
 | Estado Motores |  | Velocidad ROLL positiva
 |  | Filtrado | Velocidad YAW positiva
 |  |  | Velocidad YAW negativa
 |  |  | Velocidad PITCH positiva
 |  |  | Velocidad PITCH negativa
 |  |  | Velocidad ROLL positiva
 |  |  | Velocidad ROLL negativa
 |  | Bruto | Aceleracion YAW positiva
 |  |  | Aceleracion YAW positiva
 |  |  | Aceleracion PITCH positiva
 |  |  | Aceleracion PITCH positiva
 |  |  | Aceleracion ROLL positiva
 |  |  | Aceleracion ROLL positiva
 |  | Filtrado | Aceleracion YAW positiva
 |  |  | Aceleracion YAW negativa
 |  |  | Aceleracion PITCH positiva
 |  |  | Aceleracion PITCH negativa
 |  |  | Aceleracion ROLL positiva
 |  |  | Aceleracion ROLL negativa
 |  | Bruto | Altura
 |  | Filtrado | Altura
 |  | Estimado | Velocidad Z positiva
 |  |  | Velocidad Z negativa
 |  | PWM motor delantero
 |  | PWM motor trasero
 |  | PWM motor derecho
 |  | PWM motor izquierdo

Sheet: Hoja3
Tipo de mensaje | Codigo de mensaje | Contenido del mensaje
Estado | 6 | Posición YAW positiva | Posición YAW negativa | Posición PITCH (de 0 a 180 siendo el valor 90 igual a 0 grados) | Posición ROLL (de 0 a 180 siendo el valor 90 igual a 0 grados) | Velocidad YAW positiva | Velocidad YAW negativa | Velocidad PITCH positiva | Velocidad PITCH Negativa | Velocidad ROLL positiva | Velocidad ROLL negativa | Altura | Estado Motores
Telemetría completa | 8 | Estimado |  |  |  |  |  | Bruto |  |  |  |  |  | Filtrado |  |  |  |  |  | Bruto |  |  |  |  |  | Filtrado |  |  |  |  |  | Bruto | Filtrado | Estimado |  | PWM motor delantero | PWM motor trasero | PWM motor derecho | PWM motor izquierdo
 |  | Posición YAW positiva | Posición YAW negativa | Posición PITCH positiva | Posición PITCH negativa | Posición ROLL positiva | Posición ROLL negativa | Velocidad YAW positiva | Velocidad YAW negativa | Velocidad PITCH positiva | Velocidad PITCH positiva | Velocidad ROLL positiva | Velocidad ROLL positiva | Velocidad YAW positiva | Velocidad YAW negativa | Velocidad PITCH positiva | Velocidad PITCH negativa | Velocidad ROLL positiva | Velocidad ROLL negativa | Aceleracion YAW positiva | Aceleracion YAW positiva | Aceleracion PITCH positiva | Aceleracion PITCH positiva | Aceleracion ROLL positiva | Aceleracion ROLL positiva | Aceleracion YAW positiva | Aceleracion YAW negativa | Aceleracion PITCH positiva | Aceleracion PITCH negativa | Aceleracion ROLL positiva | Aceleracion ROLL negativa | Altura | Altura | Velocidad Z positiva | Velocidad Z negativa
Acknowledge | 7 | Código mensaje recibido
Encendido de motores | 1 | Para apagar motores: 0 Para encender motores: 1
Movimiento | 2 | Movimiento Eje Roll |  |  |  | Movimiento Eje Pitch |  |  |  | Movimiento de altura
