YoshuaNava/TesisCuadricoptero/(list of files, cad)

Other CAD files:
EstacionControl_ROS/src/pygame/obj/win32/scale_mmx.obj
EstacionControl_ROS/src/pygame/obj/win64/scale_mmx.obj
