YoshuaNava/TesisCuadricoptero/Referencias/Misceláneos/PWM/Changing PWM frequencies on Arduino controllers _ Let's Make Robots!.pdf

29/6/2014 | Changing PWM frequencies on Arduino controllers | Let's Make Robots!

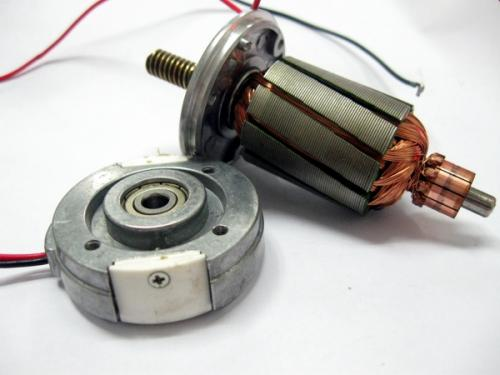
[picture p312: figure]

http://letsmakerobots.com/node/40136 | 1/3

## Changing PWM frequencies on Arduino controllers

Login (http://letsmakerobots.com/user/login?destination=node/40136%2523comment-form) or register (http://letsmakerobots.com/user/register?destination=node/40136%2523comment-form) to post comments by OddBot (http://letsmakerobots.com/profile/oddbot) Collected by 5 users (http://letsmakerobots.com/node/40136/who)
Tip/walkthrough (http://letsmakerobots.com/view/node/list/robot_tip)

By OddBot (http://letsmakerobots.com/users/oddbot) @ January 29, 2014
Increase torque or reduce noise in DC brushed motors

By default, most Arduino pwm outputs are set to about 490Hz or 980Hz. These frequencies work quite well with small dc brushed motors but can cause unwanted noise or reduce motor torque in some cases.

The frequencies are generated as a result of the clock frequency (this tutorial assumes 16MHz) being divided by a pre-scaler. For 8Mhz clocks, divide the frequency by 2. Before you start changing frequencies there are a few things you must be careful of.

1. Many motor controllers cannot work at high frequencies and can short circuit when you change to high frequencies.
2. High frequencies increase inductive reactance of the motor windings. This can increase heat and decrease motor torque.
3. Timers may be used by other functions and libraries. Changing PWM frequencies can have unexpected side affects.

So before you start, check what is the maximum PWM frequency your motor controller can handle, check what timers are currently used (eg. Timer 0 used for Arduino timing functions, Timer 1 or 5 used for servos, Timer 2 used by tone() command.

Below are 2 list of timer settings. 1 for Arduinos using ATmega 8, 168, 328 and the other for Arduino's using ATmega1280 and ATmega2560 processors. Cut and paste the lines you need directly into your setup() function.

You should find that lower frequencies provide better torque for most small DC hobby motors. A frequency of 122.55Hz provides good torque without too much noise. A frequency of 30.64Hz give the best torque at low speeds but can cause noticable vibration in your robot.

Frequencies from 490.2Hz to 7812.5Hz are noisy and cause the motors to loose torque. Frequencies above 20000Hz cannot be heard by most humans although the pets might complain. Unless your motor and motor driver are designed for these frequencies then you
risk damaging them. I found that the most small DC motors lost a lot of torque and tended to overheat.

Note: Divide the PWM frequency by 2 for an 8MHz clock, multiply by 1.25 for a 20MHz clock.

For Arduino Uno, Nano, Micro Magician, Mini Driver, Lilly Pad and any other board using ATmega 8, 168 or 328 //---------------------------------------------- Set PWM frequency for D5 & D6 -------------------------------
//TCCR0B = TCCR0B & B11111000 | B00000001; | // set timer 0 divisor to | 1 for PWM frequency of 62500.00 Hz (http://letsmakerobots.com/user/14021)
//TCCR0B = TCCR0B & B11111000 | B00000010; | // set timer 0 divisor to | 8 for PWM frequency of 7812.50 Hz
TCCR0B = TCCR0B & B11111000 | B00000011; | // set timer 0 divisor to | 64 for PWM frequency of | 976.56 Hz (http://letsmakerobots.com/user/17864)
//TCCR0B = TCCR0B & B11111000 | B00000100; | // set timer 0 divisor to | 256 for PWM frequency of | 244.14 (http://letsmakerobots.com/users/bdk6) Hz

Start Here (http://letsmakerobots.com/start)
Rules (http://letsmakerobots.com/lmr/rules)
TopTips (http://letsmakerobots.com/view/tip/list)
Robots (http://letsmakerobots.com/view/node/list/robot)
Something else (http://letsmakerobots.com/view/node/list/something_else)
Blogs (http://letsmakerobots.com/blog)
Reviews (http://letsmakerobots.com/reviews/components)
3D print club (http://letsmakerobots.com/content/join-lmr-3d-print-club)
Challenges (http://letsmakerobots.com/view/challenges/list)
Forums (http://letsmakerobots.com/forums)
Recent (http://letsmakerobots.com/tracker)
About (http://letsmakerobots.com/content/together-we-push-evolution-0)
My Account (http://letsmakerobots.com/user)
My stuff (http://letsmakerobots.com/my)

Home (http://letsmakerobots.com/)

### Search

Search
Shout Box Pop Out (http://letsmakerobots.com/content/shout-box)

### User login

Username: *

Password: *

Log in
Create new account (http://letsmakerobots.com/user/register)
Request new password (http://letsmakerobots.com/user/password)
Log in using OpenID (http://letsmakerobots.com/%2523)

### Recent blog posts

Miscellaneous items
updates.... (http://letsmakerobots.com/blog/roxanna77/miscellaneous-items-updates)
AuMac, a multitask robot (http://letsmakerobots.com/blog/vishu2287/aumac-multitask-robot)
Good bye for a while. (http://letsmakerobots.com/blog/dangerousthing/good-bye-while)
Wall-e MkII/Project 2:
The master plans (http://letsmakerobots.com/blog/craighissett/wall-e-mkiiproject-2-master-plans)
Toys for kids with
disabilities (http://letsmakerobots.com/blog/lumi/toys-kids-disabilities)
The batteries are coming! (http://letsmakerobots.com/blog/dangerousthing/batteries-are-coming)
Rocker-Bogies. (http://letsmakerobots.com/blog/fossil1999/rocker-bogies)
I2C IO expander/servo
controller using a picaxe
20x2 (http://letsmakerobots.com/blog/mintvelt/i2c-io-expanderservo-controller-using-picaxe-20x2)
Emotions and
Motivations as behaviour
architecture (http://letsmakerobots.com/blog/lordbot/emotions-and-motivations-behaviour-architecture)
Wall-e MkII - the
tinkering begins... (http://letsmakerobots.com/blog/craighissett/wall-e-mkii-tinkering-begins)
more (http://letsmakerobots.com/blog)

### Latest weblinks

SoCal MakerCon - Nov
8th 2014 (http://letsmakerobots.com/content/socal-makercon-nov-8th-2014)
Linear travel motor (http://letsmakerobots.com/content/linear-travel-motor)
Oh dear Jesus this is
Terrifying (http://letsmakerobots.com/content/oh-dear-jesus-terrifying)
Safety (http://letsmakerobots.com/content/safety)
Octaworm (http://letsmakerobots.com/content/octaworm)
Forth (http://letsmakerobots.com/content/forth)
Humanoid Robot Pianist
On Your PC (http://letsmakerobots.com/content/humanoid-robot-pianist-your-pc)
The PiBot Website (http://letsmakerobots.com/content/pibot-website)
Hackaday judge and
embedded guru: Jack
Ganssle (http://letsmakerobots.com/content/hackaday-judge-and-embedded-guru-jack-ganssle)
Engineering 101: It's all
in the datasheet (http://letsmakerobots.com/content/engineering-101-its-all-datasheet)

### Who's online

There are currently 21 users and 21 guests online.
Online users
birdmun (http://letsmakerobots.com/user/14021)
Mr.What (http://letsmakerobots.com/user/17864)
bdk6 (http://letsmakerobots.com/users/bdk6)

//TCCR0B = TCCR0B & B11111000 | B00000101; | // set timer 0 divisor to 1024 for PWM frequency of | 61.04 (http://letsmakerobots.com/user/19048) Hz

//---------------------------------------------- Set PWM frequency for D9 & D10 ------------------------------ (http://letsmakerobots.com/user/4873)
//TCCR1B = TCCR1B & B11111000 | B00000001; | // set timer 1 divisor to | 1 for PWM frequency of 31372.55 Hz
//TCCR1B = TCCR1B & B11111000 | B00000010; | // set timer 1 divisor to | 8 for PWM frequency of 3921.16 Hz (http://letsmakerobots.com/users/mark8suttongmailcom)
TCCR1B = TCCR1B & B11111000 | B00000011; | // set timer 1 divisor to | 64 for PWM frequency of | 490.20 Hz (http://letsmakerobots.com/user/22059)
//TCCR1B = TCCR1B & B11111000 | B00000100; | // set timer 1 divisor to | 256 for PWM frequency of | 122.55 Hz
//TCCR1B = TCCR1B & B11111000 | B00000101; | // set timer 1 divisor to 1024 for PWM frequency of | 30.64 Hz (http://letsmakerobots.com/user/3022)
//---------------------------------------------- Set PWM frequency for D3 & D11 ------------------------------
//TCCR2B = TCCR2B & B11111000 | B00000001; | // set timer 2 divisor to | 1 for PWM frequency of 31372.55 (http://letsmakerobots.com/users/bdk6) Hz
//TCCR2B = TCCR2B & B11111000 | B00000010; | // set timer 2 divisor to | 8 for PWM frequency of 3921.16 Hz
//TCCR2B = TCCR2B & B11111000 | B00000011; | // set timer 2 divisor to | 32 for PWM frequency of | 980.39 Hz (http://letsmakerobots.com/users/maxhirez)
TCCR2B = TCCR2B & B11111000 | B00000100; | // set timer 2 divisor to | 64 for PWM frequency of | 490.20 Hz (http://letsmakerobots.com/users/dannyjeffrey)
//TCCR2B = TCCR2B & B11111000 | B00000101; | // set timer 2 divisor to | 128 for PWM frequency of | 245.10 Hz
//TCCR2B = TCCR2B & B11111000 | B00000110; | // set timer 2 divisor to | 256 for PWM frequency of | 122.55 Hz (http://letsmakerobots.com/user/14887)
//TCCR2B = TCCR2B & B11111000 | B00000111; | // set timer 2 divisor to 1024 for PWM frequency of | 30.64 Hz (http://letsmakerobots.com/user/5404)

For Arduino Mega1280, Mega2560, MegaADK, Spider or any other board using ATmega1280 or ATmega2560 //---------------------------------------------- Set PWM frequency for D4 & D13 ------------------------------ (http://letsmakerobots.com/users/drewtoby)
//TCCR0B = TCCR0B & B11111000 | B00000001; | // set timer 0 divisor to | 1 for PWM frequency of 62500.00 Hz
//TCCR0B = TCCR0B & B11111000 | B00000010; | // set timer 0 divisor to | 8 for PWM frequency of 7812.50 Hz
TCCR0B = TCCR0B & B11111000 | B00000011; | // set timer 0 divisor to | 64 for PWM frequency of | 976.56 Hz (https://plus.google.com/u/0/112079279304962380860/posts)
//TCCR0B = TCCR0B & B11111000 | B00000100; | // set timer 0 divisor to | 256 for PWM frequency of | 244.14 Hz (http://www.facebook.com/group.php?gid=52847854131)
//TCCR0B = TCCR0B & B11111000 | B00000101; | // set timer 0 divisor to 1024 for PWM frequency of | 61.04 Hz (http://www.flickr.com/groups/letsmakerobots)

//---------------------------------------------- Set PWM frequency for D11 & D12 ----------------------------- (http://letsmakerobots.com/content/lmr-scrapbook)
//TCCR1B = TCCR1B & B11111000 | B00000001; | // set timer 1 divisor to | 1 for PWM frequency of 31372.55 (http://letsmakerobots.com/user_list) Hz
//TCCR1B = TCCR1B & B11111000 | B00000010; | // set timer 1 divisor to | 8 for PWM frequency of 3921.16 Hz (http://letsmakerobots.com/tracker_unread/all)
TCCR1B = TCCR1B & B11111000 | B00000011; | // set timer 1 divisor to | 64 for PWM frequency of | 490.20 Hz
//TCCR1B = TCCR1B & B11111000 | B00000100; | // set timer 1 divisor to | 256 for PWM frequency of | 122.55 Hz (http://letsmakerobots.com/rss_feeds)
//TCCR1B = TCCR1B & B11111000 | B00000101; | // set timer 1 divisor to 1024 for PWM frequency of | 30.64 Hz (http://letsmakerobots.com/view/admin/spam)
//---------------------------------------------- Set PWM frequency for D9 & D10 ------------------------------
//TCCR2B = TCCR2B & B11111000 | B00000001; | // set timer 2 divisor to | 1 for PWM frequency of 31372.55 Hz
//TCCR2B = TCCR2B & B11111000 | B00000010; | // set timer 2 divisor to | 8 for PWM frequency of 3921.16 Hz
//TCCR2B = TCCR2B & B11111000 | B00000011; | // set timer 2 divisor to | 32 for PWM frequency of | 980.39 Hz
TCCR2B = TCCR2B & B11111000 | B00000100; | // set timer 2 divisor to | 64 for PWM frequency of | 490.20 Hz
//TCCR2B = TCCR2B & B11111000 | B00000101; | // set timer 2 divisor to | 128 for PWM frequency of | 245.10 Hz
//TCCR2B = TCCR2B & B11111000 | B00000110; | // set timer 2 divisor to | 256 for PWM frequency of | 122.55 Hz
//TCCR2B = TCCR2B & B11111000 | B00000111; | // set timer 2 divisor to 1024 for PWM frequency of | 30.64 Hz

//---------------------------------------------- Set PWM frequency for D2, D3 & D5 ---------------------------
//TCCR3B = TCCR3B & B11111000 | B00000001; | // set timer 3 divisor to | 1 for PWM frequency of 31372.55 Hz
//TCCR3B = TCCR3B & B11111000 | B00000010; | // set timer 3 divisor to | 8 for PWM frequency of 3921.16 Hz
TCCR3B = TCCR3B & B11111000 | B00000011; | // set timer 3 divisor to | 64 for PWM frequency of | 490.20 Hz
//TCCR3B = TCCR3B & B11111000 | B00000100; | // set timer 3 divisor to | 256 for PWM frequency of | 122.55 Hz
//TCCR3B = TCCR3B & B11111000 | B00000101; | // set timer 3 divisor to 1024 for PWM frequency of | 30.64 Hz

//---------------------------------------------- Set PWM frequency for D6, D7 & D8 ---------------------------
//TCCR4B = TCCR4B & B11111000 | B00000001; | // set timer 4 divisor to | 1 for PWM frequency of 31372.55 Hz
//TCCR4B = TCCR4B & B11111000 | B00000010; | // set timer 4 divisor to | 8 for PWM frequency of 3921.16 Hz
TCCR4B = TCCR4B & B11111000 | B00000011; | // set timer 4 divisor to | 64 for PWM frequency of | 490.20 Hz
//TCCR4B = TCCR4B & B11111000 | B00000100; | // set timer 4 divisor to | 256 for PWM frequency of | 122.55 Hz
//TCCR4B = TCCR4B & B11111000 | B00000101; | // set timer 4 divisor to 1024 for PWM frequency of | 30.64 Hz

//---------------------------------------------- Set PWM frequency for D44, D45 & D46 ------------------------
//TCCR5B = TCCR5B & B11111000 | B00000001; | // set timer 5 divisor to | 1 for PWM frequency of 31372.55 Hz
//TCCR5B = TCCR5B & B11111000 | B00000010; | // set timer 5 divisor to | 8 for PWM frequency of 3921.16 Hz
TCCR5B = TCCR5B & B11111000 | B00000011; | // set timer 5 divisor to | 64 for PWM frequency of | 490.20 Hz
//TCCR5B = TCCR5B & B11111000 | B00000100; | // set timer 5 divisor to | 256 for PWM frequency of | 122.55 Hz
//TCCR5B = TCCR5B & B11111000 | B00000101; | // set timer 5 divisor to 1024 for PWM frequency of | 30.64 Hz

Differences in timer frequencies:
You will see that timer 0 frequencies are double that of the other timers. This is because Timer 0 is used by Arduino for timing functions
such as delay(), millis(), micros() and more. To get better accuracy, The Arduino IDE sets Timer 0 to fast PWM mode. It should be
noted that for these timing functions,the Arduino software automatically compensates for 8MHz, 16MHz and 20MHz clocks. The default prescaler setting is always 64.

For all other timers, the Arduino IDE sets the timer mode to phase correct PWM. This causes the counter to count from 0 to 255 and then from 255 back to 0 again. This provides a more symetrical output but at half the frequency. The default timer settings are configured in the wiring.c file of your Arduino installation.

If you are looking for a timer library for generating timer interrupts or custom PWM outputs then check out this library: http://playground.arduino.cc/Code/Timer1. There are 2 versions, one for timer 1 and another for timer 3. It should be easy to modify these libraries to work with the other timers if required.

If you want more information about configuring timers and the different modes then check these tutorials out.
Ken Shirriff's secrets of Arduino PWMs: http://www.righto.com/2009/07/secrets-of-arduino-pwm.html
RobotFreaks's Arduino 101: Timers and interrupts: http://letsmakerobots.com/node/28278

Ladvien (http://letsmakerobots.com/user/19048)
cevinius (http://letsmakerobots.com/user/20896)
bluesthue (http://letsmakerobots.com/user/4873)
Dan M (http://letsmakerobots.com/user/15049)
mark8sutton@gma... (http://letsmakerobots.com/users/mark8suttongmailcom)
Hackgar (http://letsmakerobots.com/user/22059)
K120189 (http://letsmakerobots.com/user/3022)
mtriplett (http://letsmakerobots.com/user/20389)
ncoonrod14 (http://letsmakerobots.com/users/ncoonrod14)
bdk6 (http://letsmakerobots.com/users/bdk6)
Maxhirez (http://letsmakerobots.com/users/maxhirez)
DannyJeffrey (http://letsmakerobots.com/users/dannyjeffrey)
Duane Degn (http://letsmakerobots.com/user/14887)
lukeyes (http://letsmakerobots.com/user/5404)
Yahmez (http://letsmakerobots.com/users/yahmez)
Cromz (http://letsmakerobots.com/users/cromz)
Kallie (http://letsmakerobots.com/users/kallie)
drewtoby (http://letsmakerobots.com/users/drewtoby)

### Navigation

LMR on Google+ (https://plus.google.com/u/0/112079279304962380860/posts)
LMR on Facebook (http://www.facebook.com/group.php?gid=52847854131)
LMR on Flicker (http://www.flickr.com/groups/letsmakerobots)
LMR on Twitter (http://twitter.com/LetsMakeRobots)
LMR Scrapbook (http://letsmakerobots.com/content/lmr-scrapbook)
User list (http://letsmakerobots.com/user_list)
Unread posts (http://letsmakerobots.com/tracker_unread/all)
RSS feeds (http://letsmakerobots.com/rss_feeds)
Spam Control (http://letsmakerobots.com/view/admin/spam)

### Comment viewing options

Threaded list - expanded | Date - newest first | 10 comments per page | Save settings
Select your preferred way to display the comments and click "Save settings" to activate your changes. By 42Bots (http://letsmakerobots.com/user/21784) @ Wed, 2014-01-29 17:34

delay() and millis()

Login (http://letsmakerobots.com/user/login?destination=node/40136%2523comment-form) or register (http://letsmakerobots.com/user/register?destination=node/40136%2523comment-form) to post comments
I read that changing these settings for timer 0 will affect delay() and millis() functions. Would changing the other timers (1 or 3 for example) have the same effect? Any other potential issues (possibly libraries that depend on those, I assume)? Thanks for the informative post!

By OddBot (http://letsmakerobots.com/users/oddbot) @ Thu, 2014-01-30 04:53

Yes timer 0 is used for the

Login (http://letsmakerobots.com/user/login?destination=node/40136%2523comment-form) or register (http://letsmakerobots.com/user/register?destination=node/40136%2523comment-form) to post comments
Yes timer 0 is used for the timing functions so yes, adjusting timer 0 will affect those functions. The simplest workaround is to allow for the changes in your code. For example if you set the prescaler so it runs 4x slower then you know that when the Arduino thinks 1mS has passed, in reality 4mS have passed.

Changing other timers will have no affect on the timing functions but they will affect any libraries that uses those timers.

By unix_guru (http://letsmakerobots.com/user/21264) @ Wed, 2014-01-29 14:52

Thanks OB1. Great tutorial.

Login (http://letsmakerobots.com/user/login?destination=node/40136%2523comment-form) or register (http://letsmakerobots.com/user/register?destination=node/40136%2523comment-form) to post comments
I struggled through all of this a few months ago. This will definitely help newcomers!

Great work as always.

By OddBot (http://letsmakerobots.com/users/oddbot) @ Wed, 2014-01-29 15:19

It's more of a cut an paste

Login (http://letsmakerobots.com/user/login?destination=node/40136%2523comment-form) or register (http://letsmakerobots.com/user/register?destination=node/40136%2523comment-form) to post comments
It's more of a cut an paste solution than a tutorial.

It is based on this tutorial: http://playground.arduino.cc/Main/TimerPWMCheatsheet but I've filled in some blanks for using the ATmega1280 and 2560.

ALL LMR ARE BELONG TO US!
Let's make robots!
