YoshuaNava/TesisCuadricoptero/Documento/Datos de pruebas de Xbee a distancia.xlsx

distancia | prueba 1 | prueba 2 | prueba 3 | media recibidos | % recibidos | % sin recibir
 | recibidos | recibidos | recibidos
0 | 200 | 200 | 200 | 200 | 100 | 0
1 | 200 | 199 | 200 | 199.6666667 | 99.83333333 | 0.1666666667
3 | 199 | 200 | 199 | 199.3333333 | 99.66666667 | 0.3333333333
5 | 197 | 194 | 200 | 197 | 98.5 | 1.5
7 | 196 | 172 | 198 | 188.6666667 | 94.33333333 | 5.666666667
10 | 148 | 200 | 191 | 179.6666667 | 89.83333333 | 10.16666667
