YoshuaNava/TesisCuadricoptero/Documento/Datos de las pruebas del IRFZ44N y motores.xlsx

Vds | 12V
 | Vgs | Ids
 |  | Prueba #1 | Prueba #2 | Prueba #3
 | 0 | 0 | 0 | 0
 | 1 | 0 | 0 | 0
 | 2 | 0 | 0 | 0
 | 3 | 0 | 0 | 0
 | 3.5 | 0.8 | 0.7 | 0.8
 | 4 | 1.2 | 1.5 | 1.7
 | 5 | 3.5 | 3.5 | 3.64
 | 6 | 3.87 | 3.5 | 3.56
 | 7 | 3.87 | 3.46 | 3.51
 | 8 | 3.76 | 3.38 | 3.46
 | 9 | 3.78 | 3.34 | 3.43
 | 10 | 3.69 | 3.34 | 3.41
 | 11 | 3.6 | 3.33 | 3.34
 | Vgs | Rds
 |  | Prueba #1 | Prueba #2 | Prueba #3
 | 3.5 | 15 | 17.14285714 | 15
 | 4 | 10 | 8 | 7.058823529
 | 5 | 3.428571429 | 3.428571429 | 3.296703297
 | 6 | 3.100775194 | 3.428571429 | 3.370786517
 | 7 | 3.100775194 | 3.468208092 | 3.418803419
 | 8 | 3.191489362 | 3.550295858 | 3.468208092
 | 9 | 3.174603175 | 3.592814371 | 3.498542274
 | 10 | 3.25203252 | 3.592814371 | 3.519061584
 | 11 | 3.333333333 | 3.603603604 | 3.592814371
 | Vgs | Pds
 |  | Prueba #1 | Prueba #2 | Prueba #3
 | 0 | 0 | 0 | 0
 | 1 | 0 | 0 | 0
 | 2 | 0 | 0 | 0
 | 3 | 0 | 0 | 0
 | 3.5 | 9.6 | 8.4 | 9.6
 | 4 | 14.4 | 18 | 20.4
 | 5 | 42 | 42 | 43.68
 | 6 | 46.44 | 42 | 42.72
 | 7 | 46.44 | 41.52 | 42.12
 | 8 | 45.12 | 40.56 | 41.52
 | 9 | 45.36 | 40.08 | 41.16
 | 10 | 44.28 | 40.08 | 40.92
 | 11 | 43.2 | 39.96 | 40.08
