YoshuaNava/TesisCuadricoptero/Documento/CaracterizacionSensoresPID/TT_PruebaSensorUltrasonico.csv

TiempoEjecucion | AnguloPitch | AnguloRoll | AnguloYaw | G_Pitch | G_Roll | G_Yaw | G_Pitch_filtrada | G_Roll_filtrada | G_Yaw_filtrada | Ax | Ay | Az | Ax_filtrada | Ay_filtrada | Az_filtrada | posZ | posZ_filtrada | velZ | motorDelantero | motorTrasero | motorDerecho | motorIzquierdo | EstadoEncendido | MensajesRecibidos
116.366782189 | -3 | 0 | -90 | -10 | 0 | 31 | -15 | 0 | 31 | 0 | -17 | 242 | 0 | -17 | 242 | 27 | 30 | 0 | 0 | 0 | 0 | 0 | 0 | 10591
116.377920151 | -3 | 0 | -90 | -10 | 0 | 31 | -15 | 0 | 31 | 0 | -17 | 242 | 0 | -17 | 242 | 27 | 30 | 0 | 0 | 0 | 0 | 0 | 0 | 10592
116.392286063 | -3 | 0 | -90 | -5 | -1 | 30 | -13 | 0 | 31 | -3 | -24 | 238 | -3 | -24 | 238 | 28 | 30 | 0 | 0 | 0 | 0 | 0 | 0 | 10593
116.399917126 | -3 | 0 | -90 | -5 | -1 | 30 | -13 | 0 | 31 | -3 | -24 | 238 | -3 | -24 | 238 | 28 | 30 | 0 | 0 | 0 | 0 | 0 | 0 | 10594
116.410897971 | -3 | 0 | -90 | 1 | -2 | 31 | -10 | 0 | 31 | -2 | -31 | 237 | -2 | -31 | 237 | 28 | 30 | 0 | 0 | 0 | 0 | 0 | 0 | 10595
116.421672106 | -3 | 0 | -90 | 1 | -2 | 31 | -10 | 0 | 31 | -2 | -31 | 237 | -2 | -31 | 237 | 28 | 30 | 0 | 0 | 0 | 0 | 0 | 0 | 10596
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
