YoshuaNava/TesisCuadricoptero/Documento/Diagramas/CircuitoPrueba_Vgs_MOSFET.png

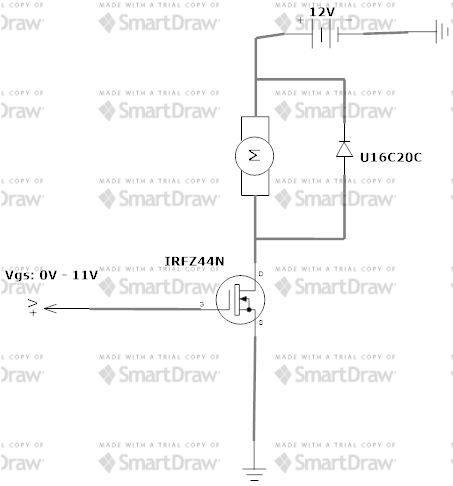
Documento/Diagramas/CircuitoPrueba_Vgs_MOSFET.png
