YoshuaNava/TesisCuadricoptero/Referencias/quadcopter-140210125729-phpapp01.pdf

## How does a Quadrotor fly? A journey from physics, mathematics, control

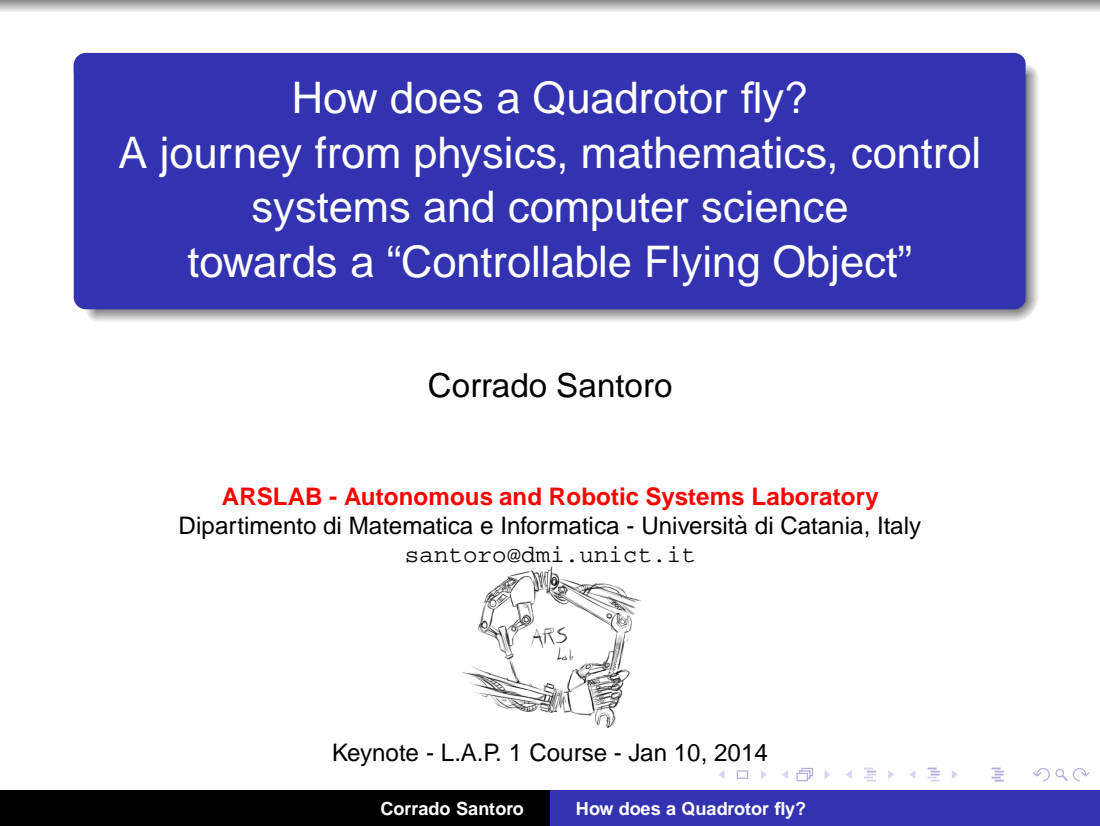
[picture p314: page 1]
Corrado Santoro; How does a Quadrotor fly?

systems and computer science
towards a “Controllable Flying Object”

ARSLAB - Autonomous and Robotic Systems Laboratory
Dipartimento di Matematica e Informatica - Universita di Catania, Italy `

santoro@dmi.unict.it

Keynote - L.A.P. 1 Course - Jan 10, 2014

## Overview

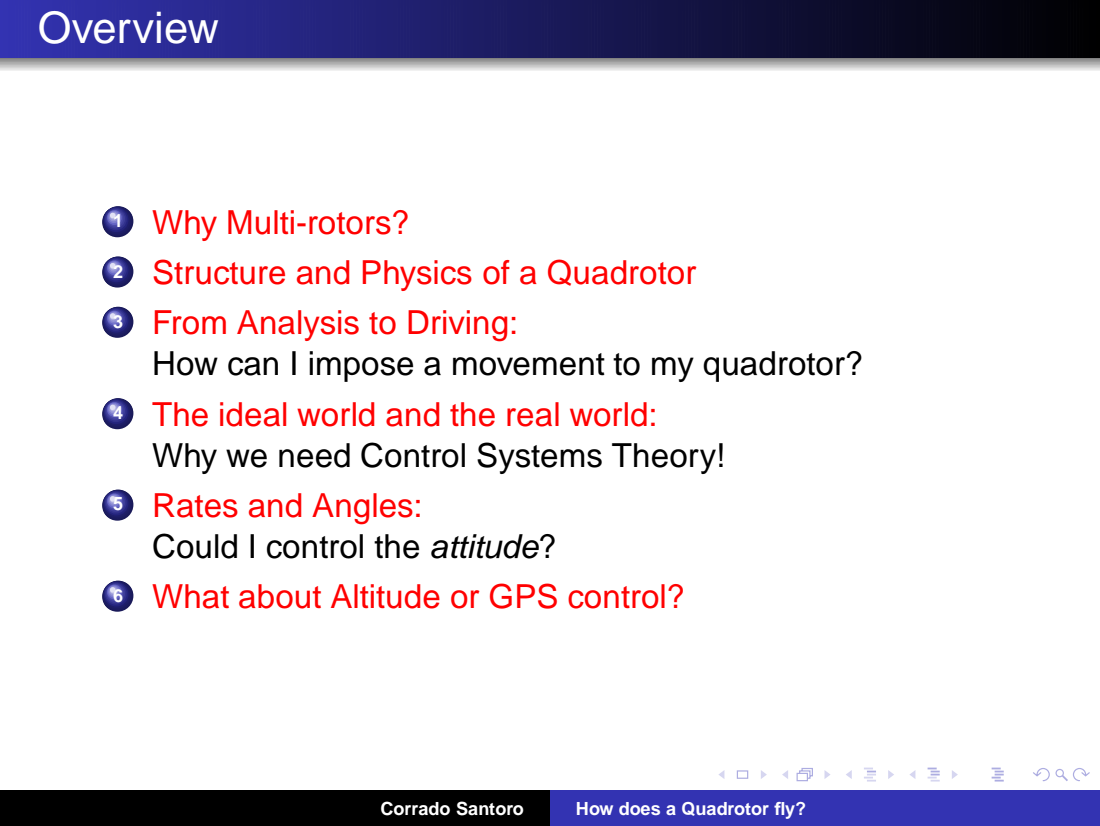
[picture p315: page 2]

1 Why Multi-rotors?
2 Structure and Physics of a Quadrotor
3 From Analysis to Driving:
How can I impose a movement to my quadrotor?
4 The ideal world and the real world:
Why we need Control Systems Theory!
5 Rates and Angles:
Could I control the attitude?
6 What about Altitude or GPS control?

## Part I

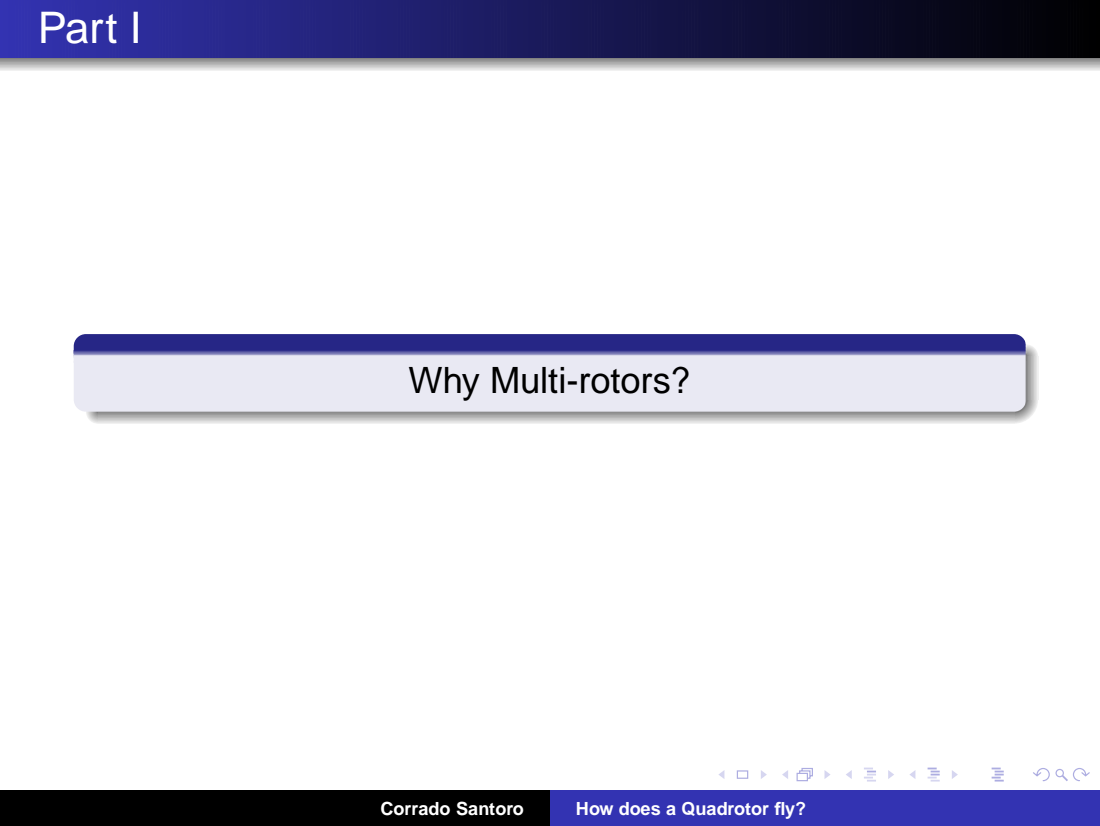
[picture p316: page 3]

Why Multi-rotors?

## Flying Machines

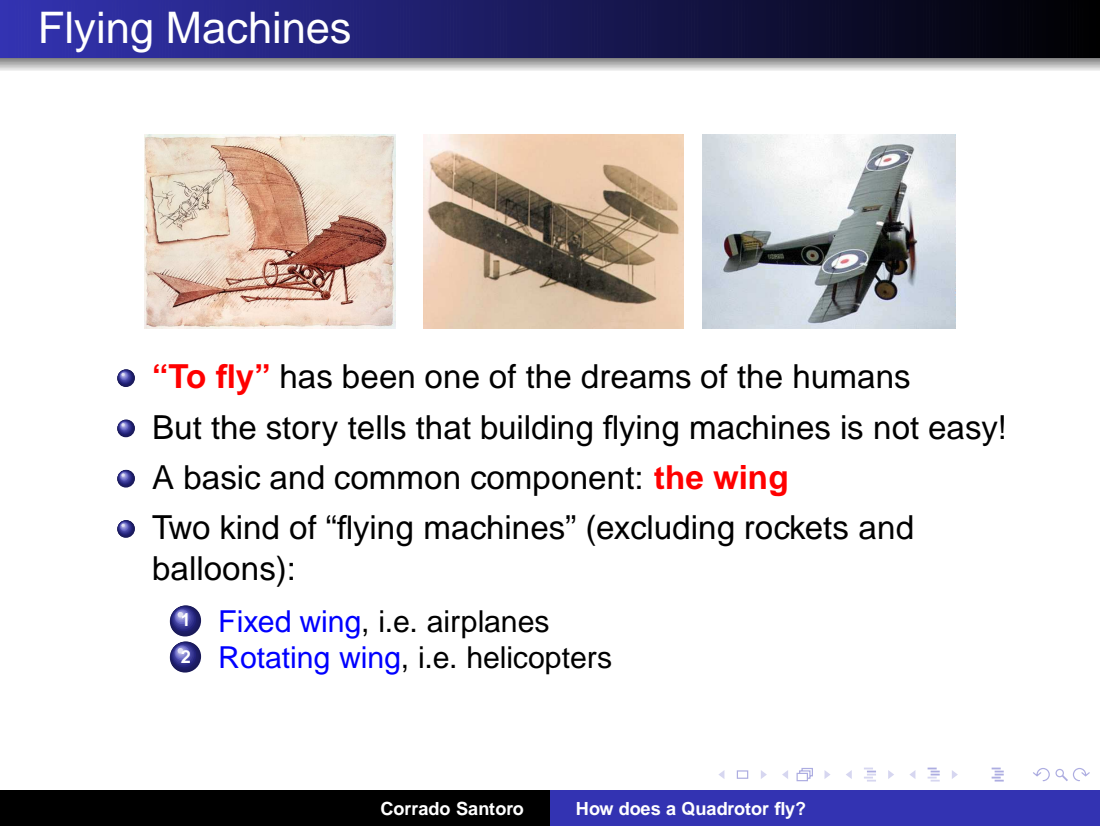
[picture p317: page 4]

“To fly” has been one of the dreams of the humans
But the story tells that building flying machines is not easy!
A basic and common component: the wing
Two kind of “flying machines” (excluding rockets and
balloons):
1 Fixed wing, i.e. airplanes
2 Rotating wing, i.e. helicopters

## Design and Implementation problems

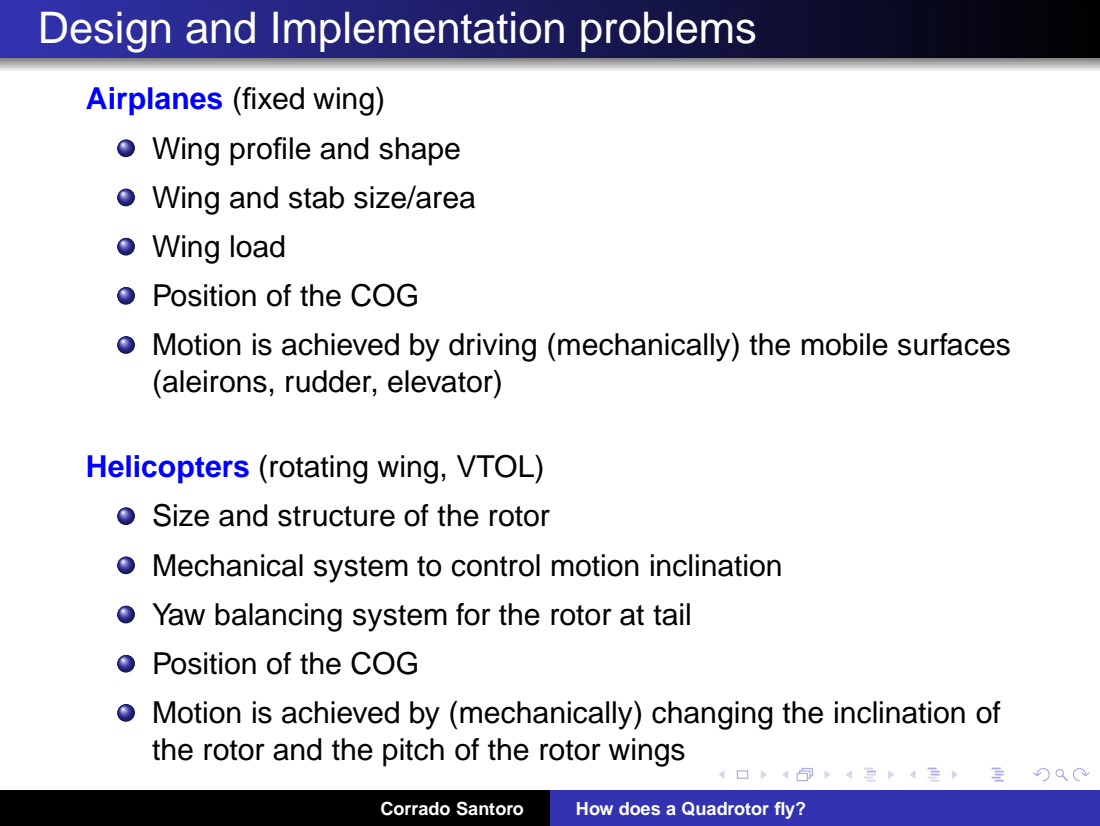
[picture p318: page 5]

Airplanes (fixed wing)
Wing profile and shape
Wing and stab size/area
Wing load
Position of the COG
Motion is achieved by driving (mechanically) the mobile surfaces
(aleirons, rudder, elevator)

Helicopters (rotating wing, VTOL)
Size and structure of the rotor
Mechanical system to control motion inclination
Yaw balancing system for the rotor at tail
Motion is achieved by (mechanically) changing the inclination of
the rotor and the pitch of the rotor wings

Multi-rotors ...

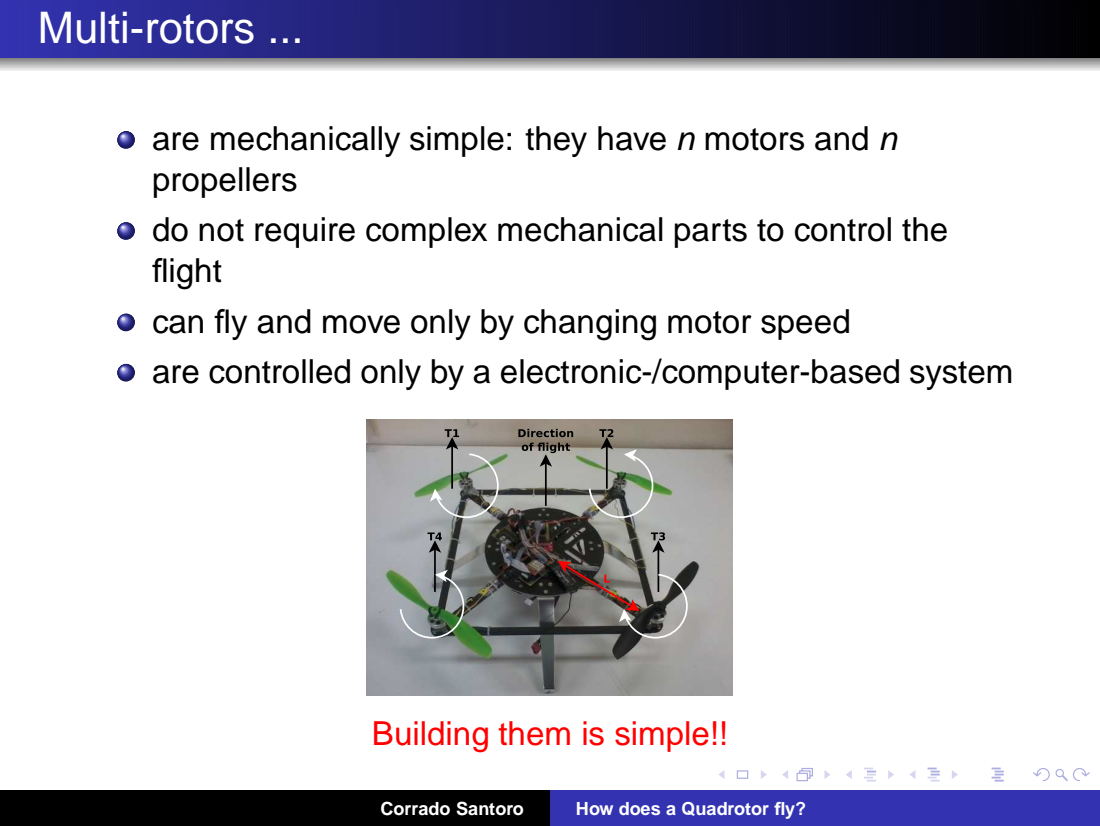
[picture p319: page 6]

are mechanically simple: they have n motors and n
propellers
do not require complex mechanical parts to control the
flight
can fly and move only by changing motor speed
are controlled only by a electronic-/computer-based system

Building them is simple!!

## Part II

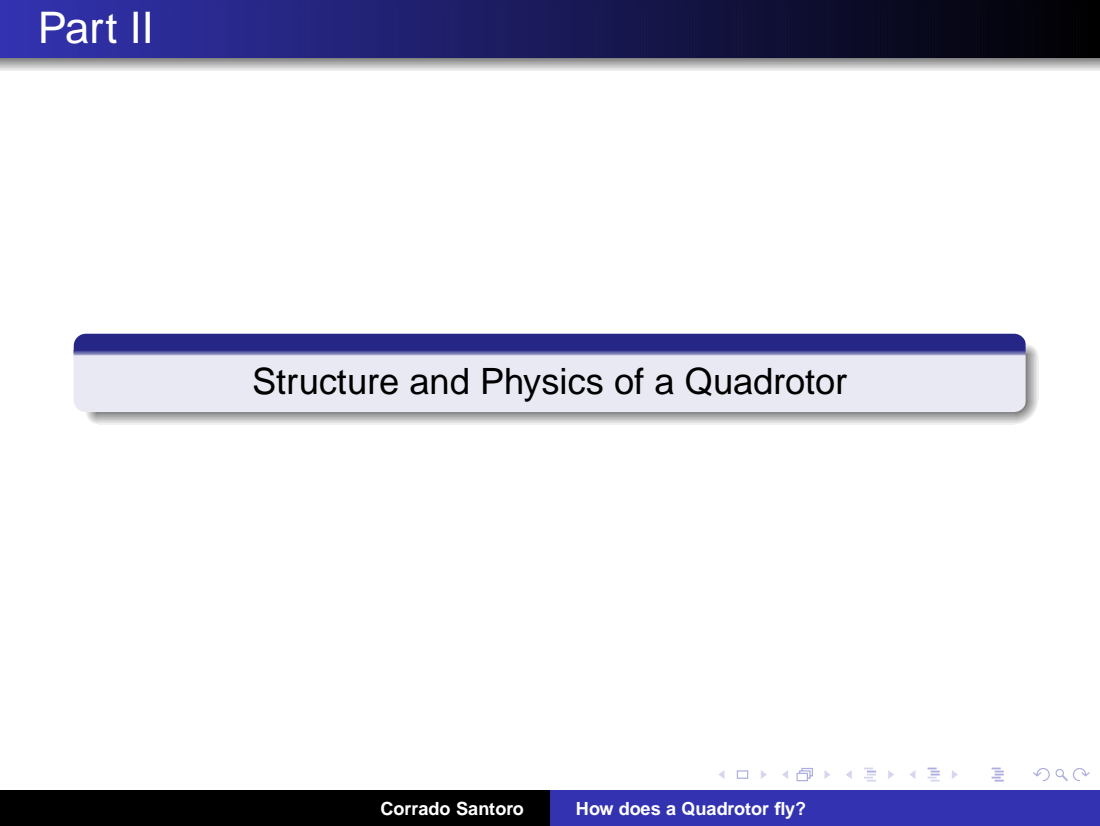
[picture p320: page 7]

Structure and Physics of a Quadrotor

## Structure of a Quadrotor (Mechanics)

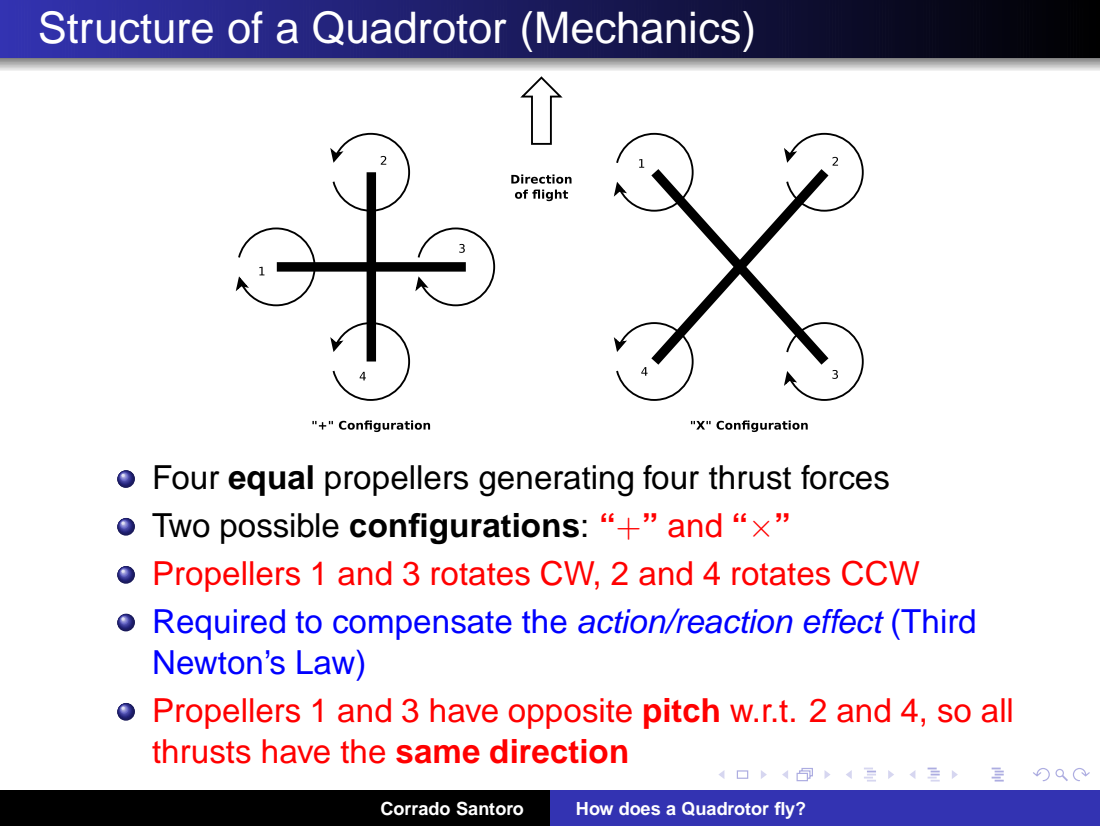
[picture p321: page 8]

Four equal propellers generating four thrust forces
Two possible configurations: “+” and “×”
Propellers 1 and 3 rotates CW, 2 and 4 rotates CCW
Required to compensate the action/reaction effect (Third
Newton’s Law)
Propellers 1 and 3 have opposite pitch w.r.t. 2 and 4, so all
thrusts have the same direction

## Structure of a Quadrotor (Electronics)

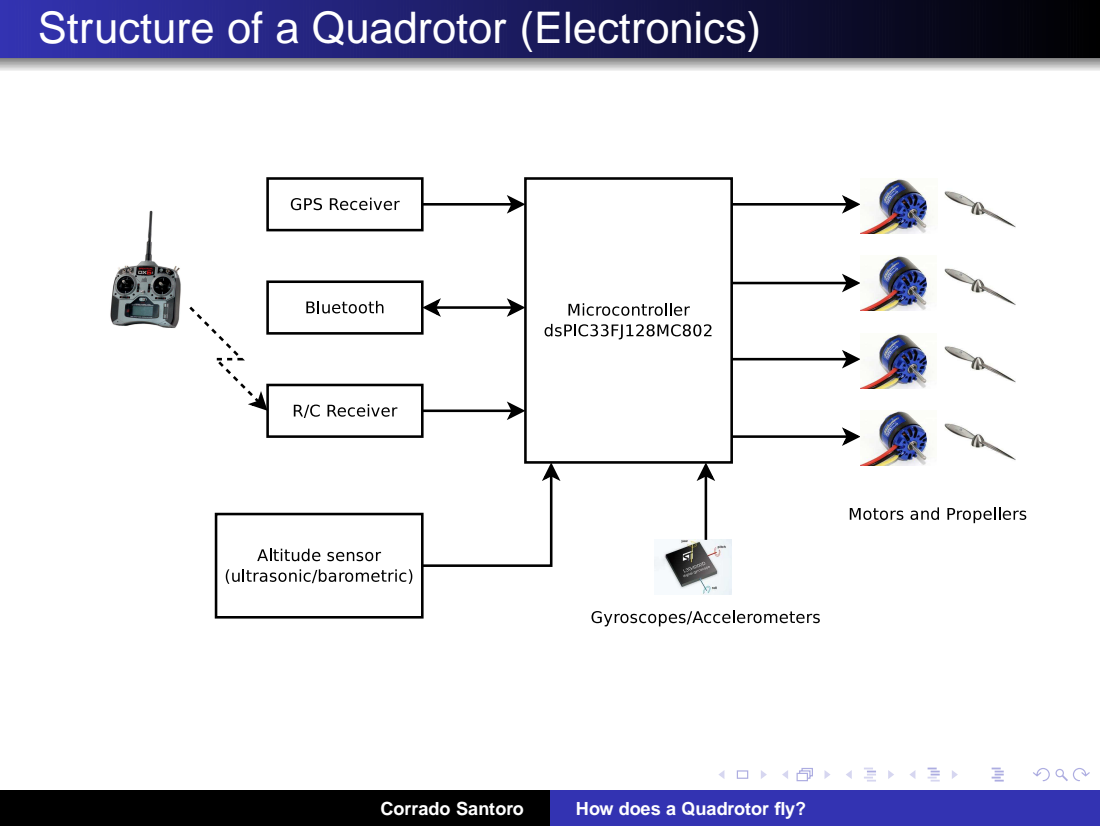
[picture p322: page 9]

## Forces and Rotation speeds

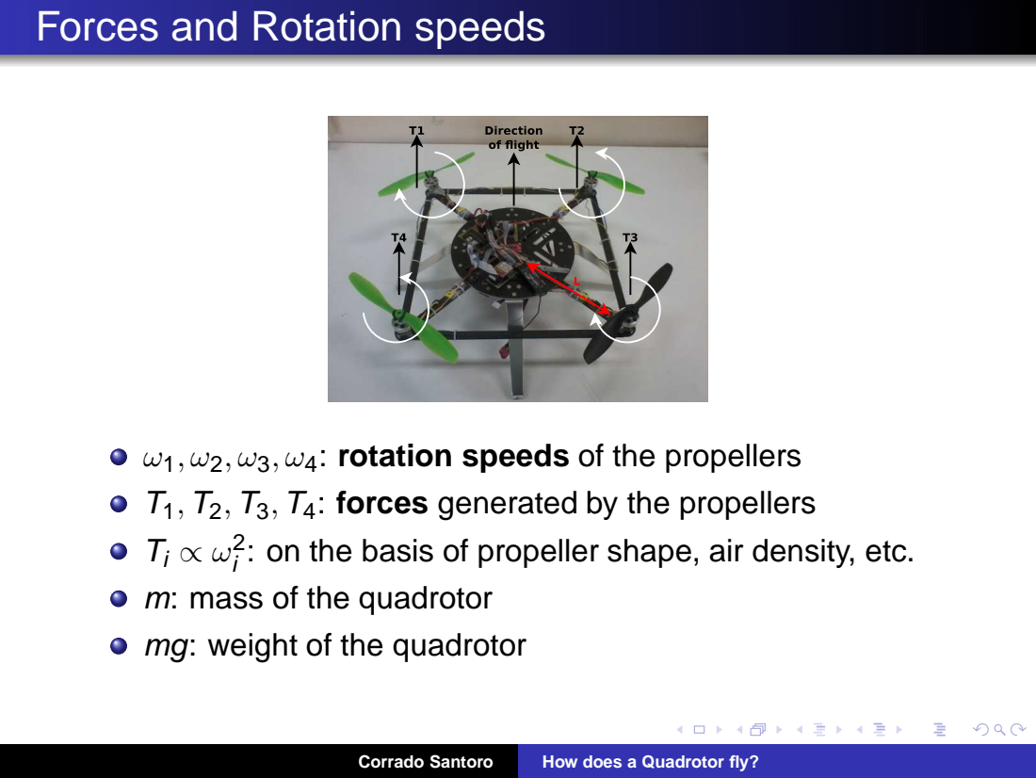
[picture p323: page 10]

ω1, ω2, ω3, ω4: rotation speeds of the propellers
T1, T2, T3, T4: forces generated by the propellers
: on the basis of propeller shape, air density, etc.
m: mass of the quadrotor
mg: weight of the quadrotor

## Moments

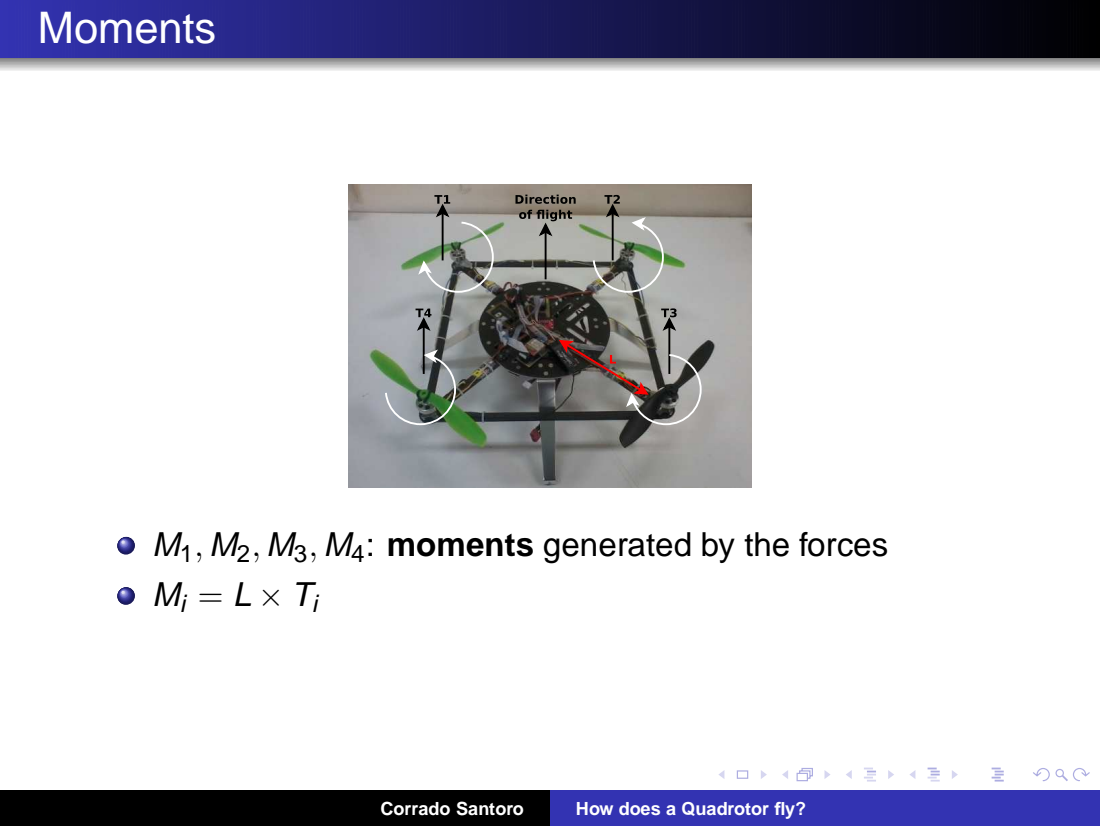
[picture p324: page 11]

M1, M2, M3, M4: moments generated by the forces

## Hovering Condition (Equilibrium)

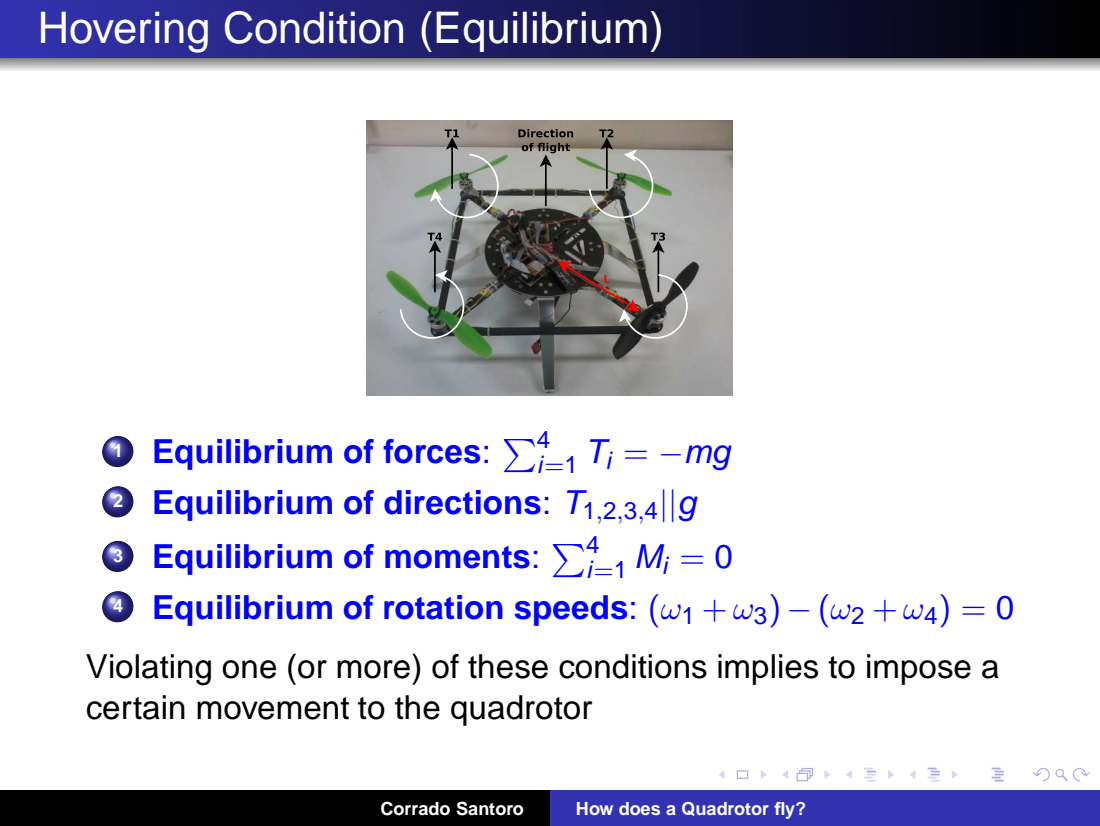
[picture p325: page 12]

1 Equilibrium of forces:
2 Equilibrium of directions: T1,2,3,4||g
3 Equilibrium of moments:
4 Equilibrium of rotation speeds: (ω1 + ω3) − (ω2 + ω4) = 0
Violating one (or more) of these conditions implies to impose a
certain movement to the quadrotor

## Reference Systems

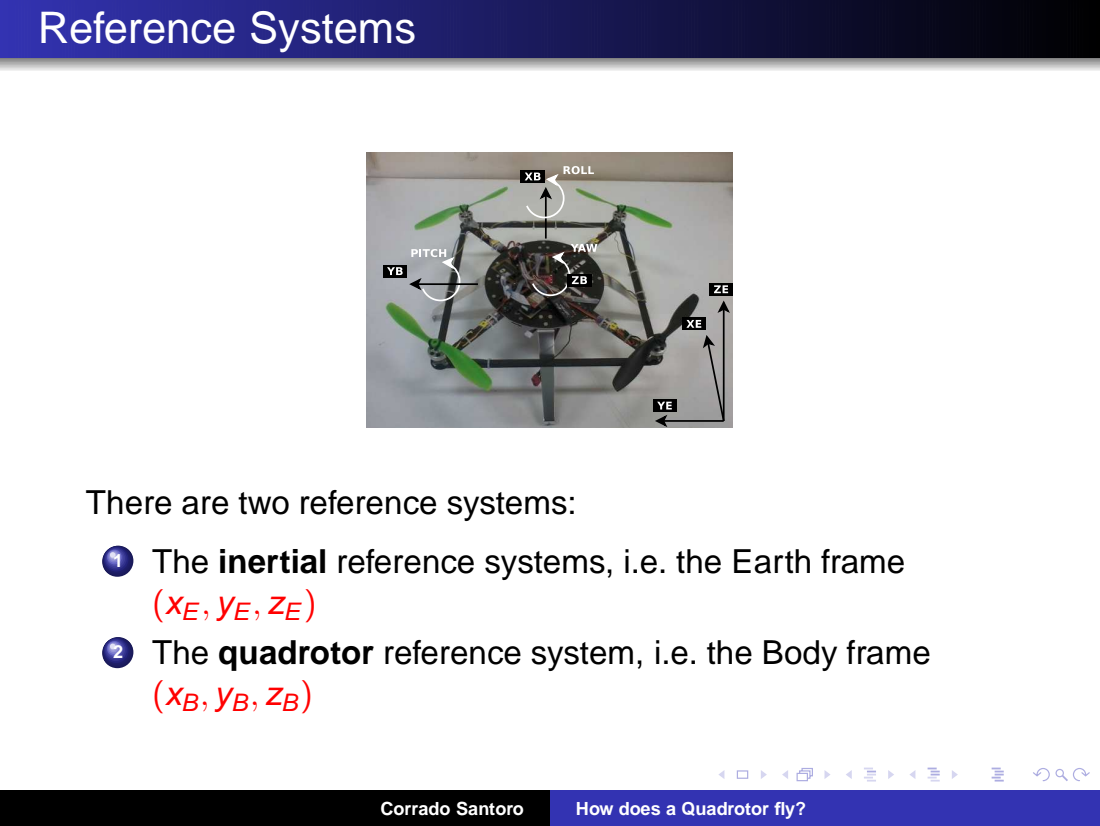
[picture p326: page 13]

There are two reference systems:
1 The inertial reference systems, i.e. the Earth frame
2 The quadrotor reference system, i.e. the Body frame

## Euler Angles

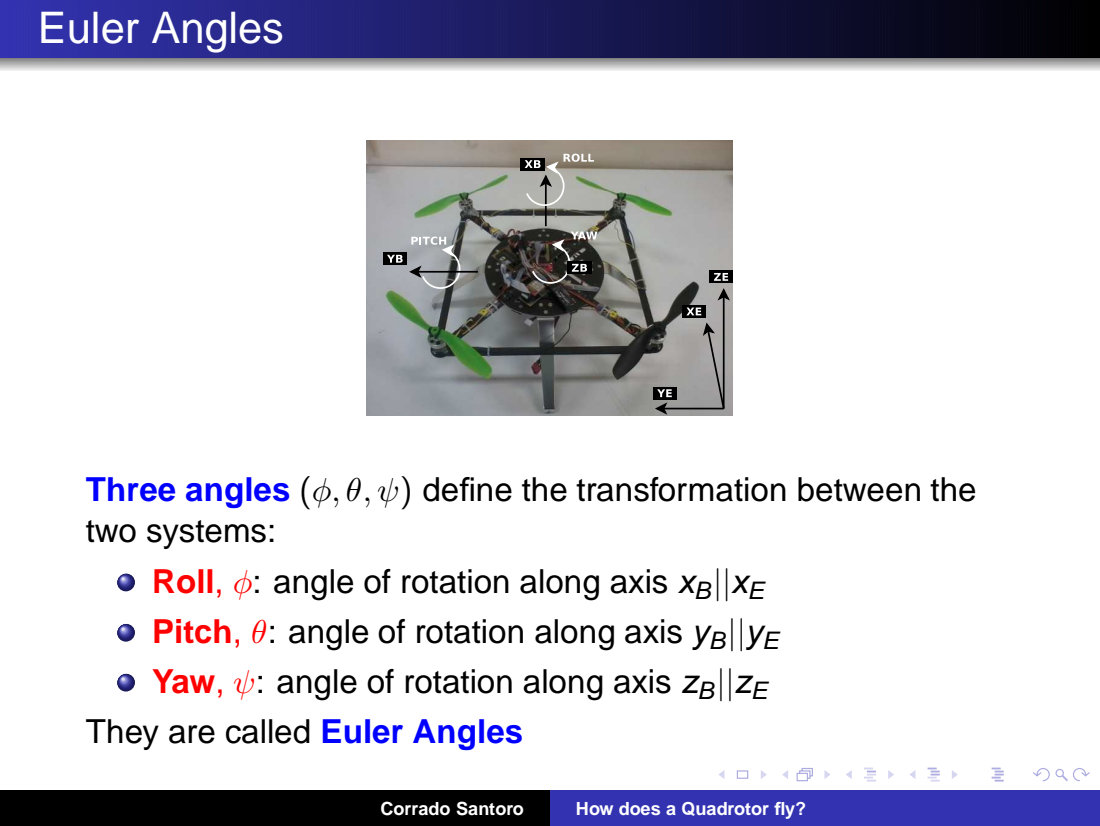
[picture p327: page 14]

Three angles (φ, θ, ψ) define the transformation between the
two systems:
Roll, φ: angle of rotation along axis xB||xE
Pitch, θ: angle of rotation along axis yB||yE
Yaw, ψ: angle of rotation along axis zB||zE
They are called Euler Angles

## Angular Speeds

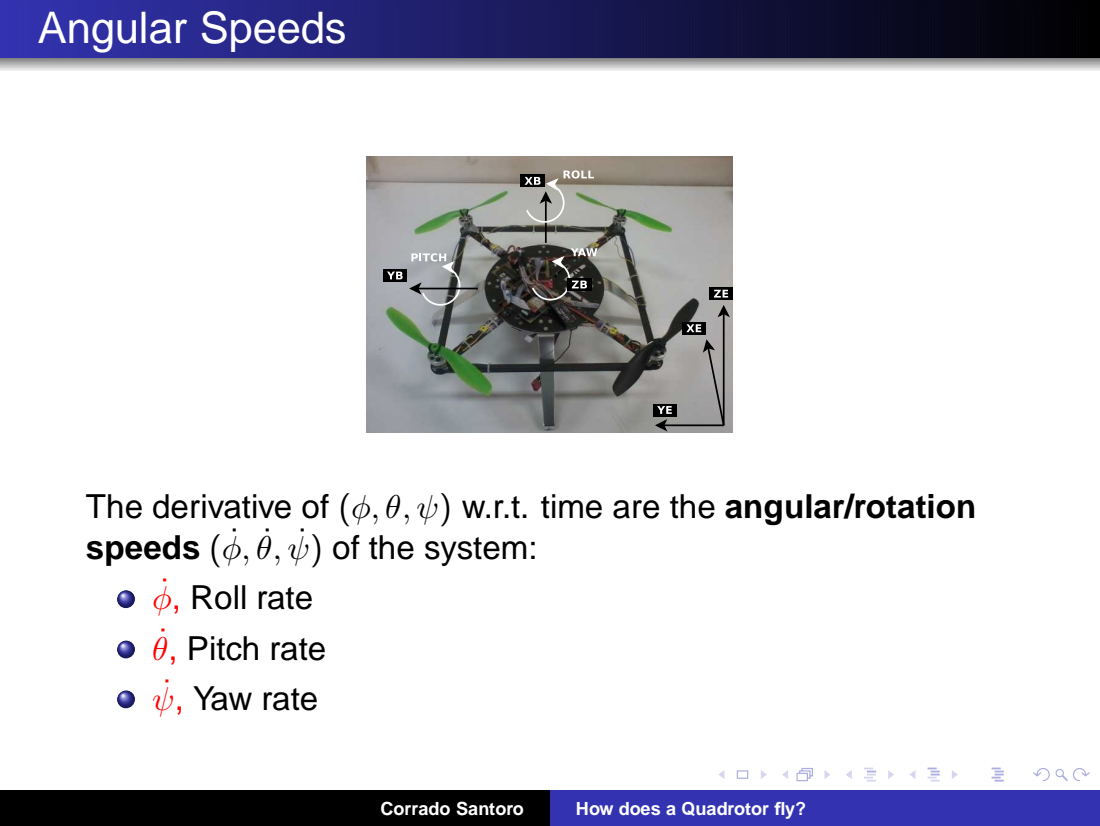
[picture p328: page 15]

The derivative of (φ, θ, ψ) w.r.t. time are the angular/rotation
speeds (φ,˙ ˙θ, ψ˙) of the system:
, Roll rate
˙θ, Pitch rate
, Yaw rate

## Part III

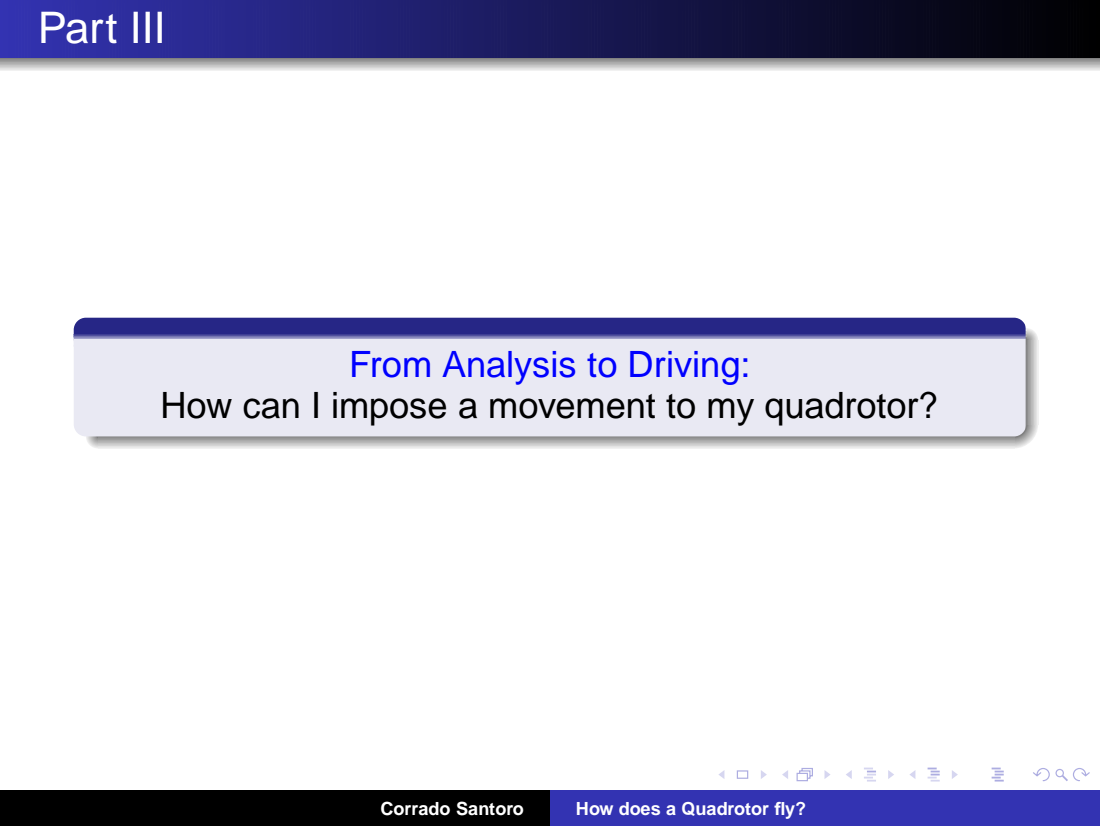
[picture p329: page 16]

From Analysis to Driving:

How can I impose a movement to my quadrotor?

## Hovering Condition (Equilibrium)

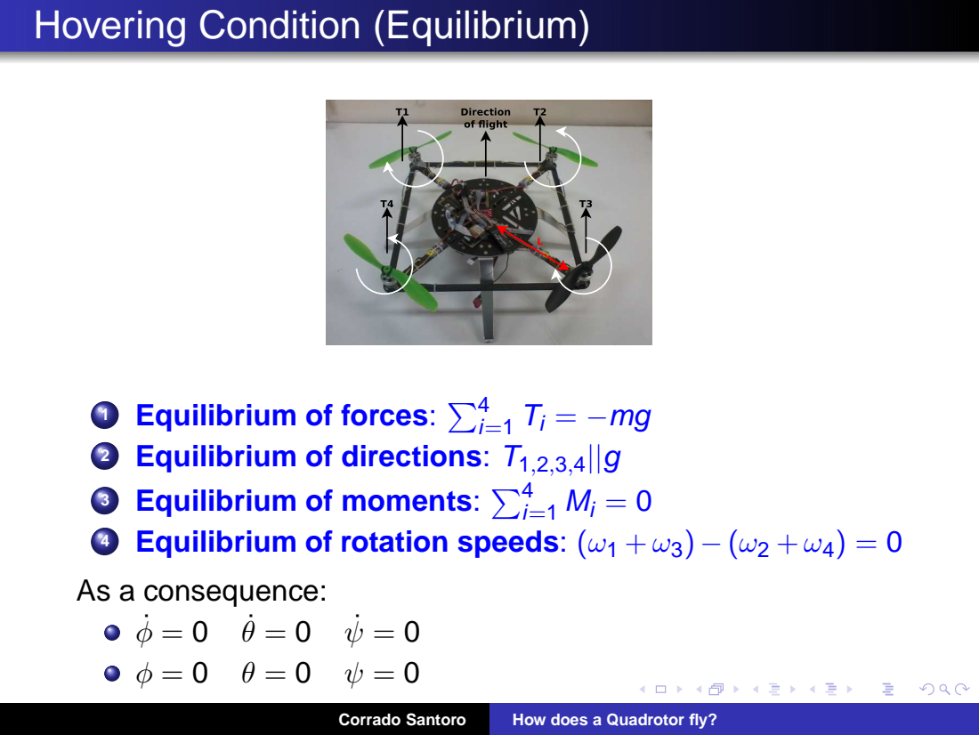
[picture p330: page 17]

1 Equilibrium of forces:
2 Equilibrium of directions: T1,2,3,4||g
3 Equilibrium of moments:
4 Equilibrium of rotation speeds: (ω1 + ω3) − (ω2 + ω4) = 0
As a consequence:

## Going Up and Down

P4

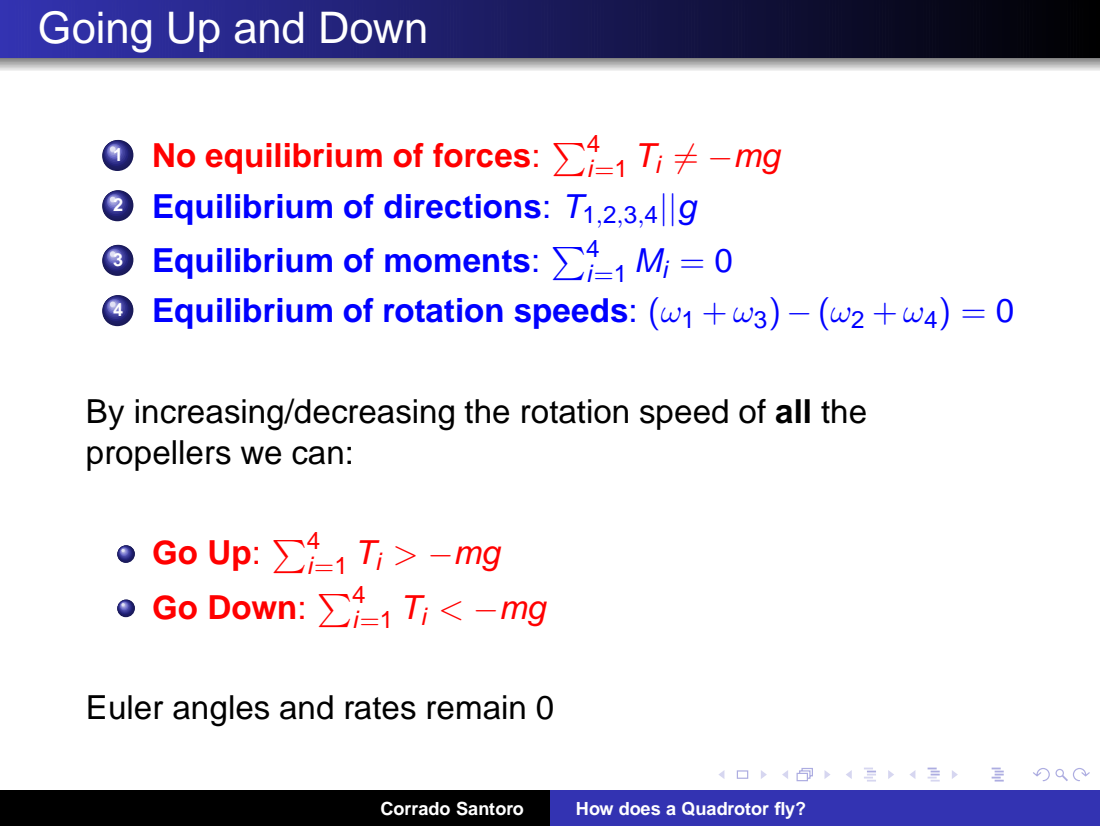
[picture p331: page 18]
Go Up: Go Down:

1 No equilibrium of forces:
2 Equilibrium of directions: T1,2,3,4||g
3 Equilibrium of moments:
4 Equilibrium of rotation speeds: (ω1 + ω3) − (ω2 + ω4) = 0

By increasing/decreasing the rotation speed of all the
propellers we can:

Euler angles and rates remain 0

## Yaw Rotation

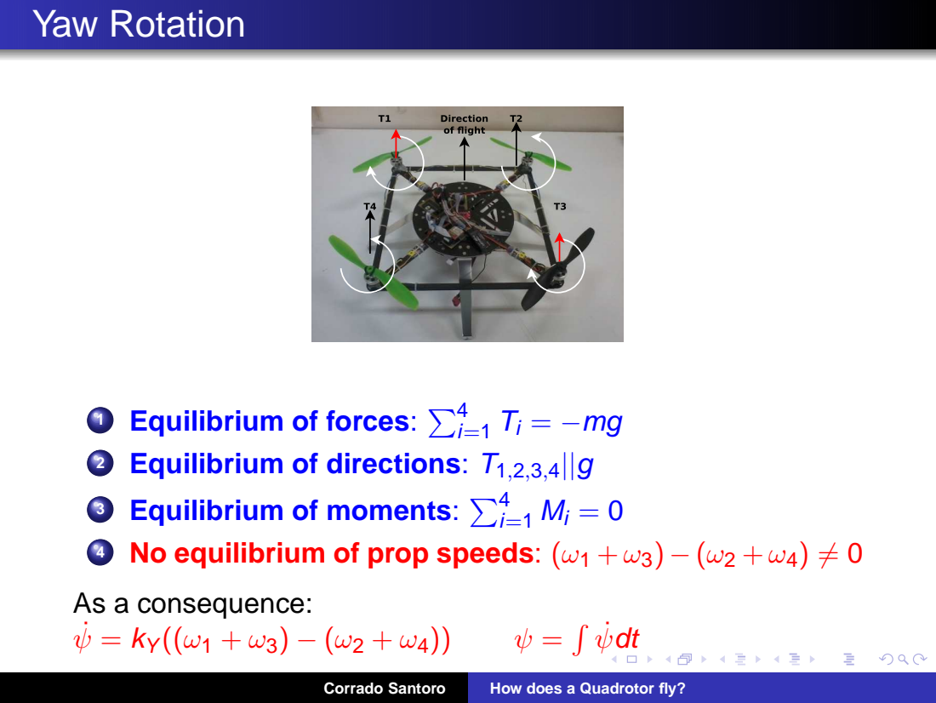
[picture p332: page 19]

1 Equilibrium of forces:
2 Equilibrium of directions: T1,2,3,4||g
3 Equilibrium of moments:
4 No equilibrium of prop speeds: (ω1 + ω3) − (ω2 + ω4) 6= 0
As a consequence:

## Roll Rotation

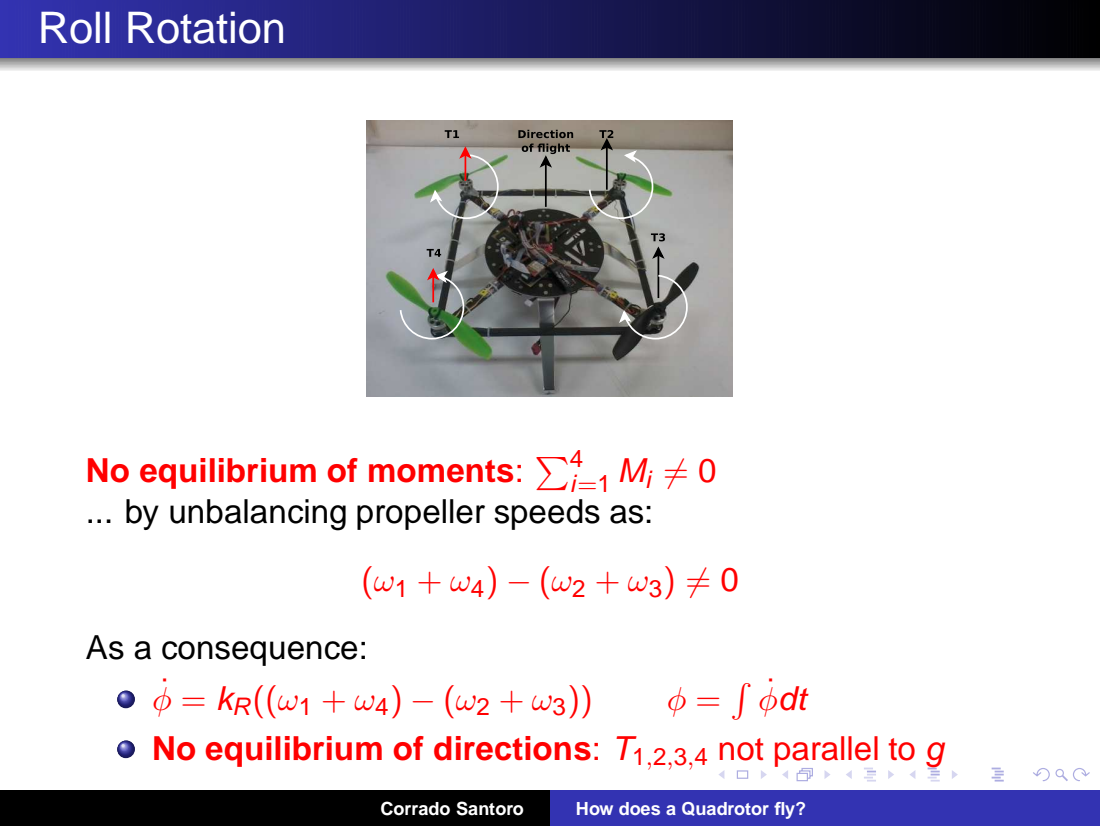
[picture p333: page 20]

No equilibrium of moments:
... by unbalancing propeller speeds as:

As a consequence:
No equilibrium of directions: T1,2,3,4 not parallel to g

## Roll Rotation and Translated Flight

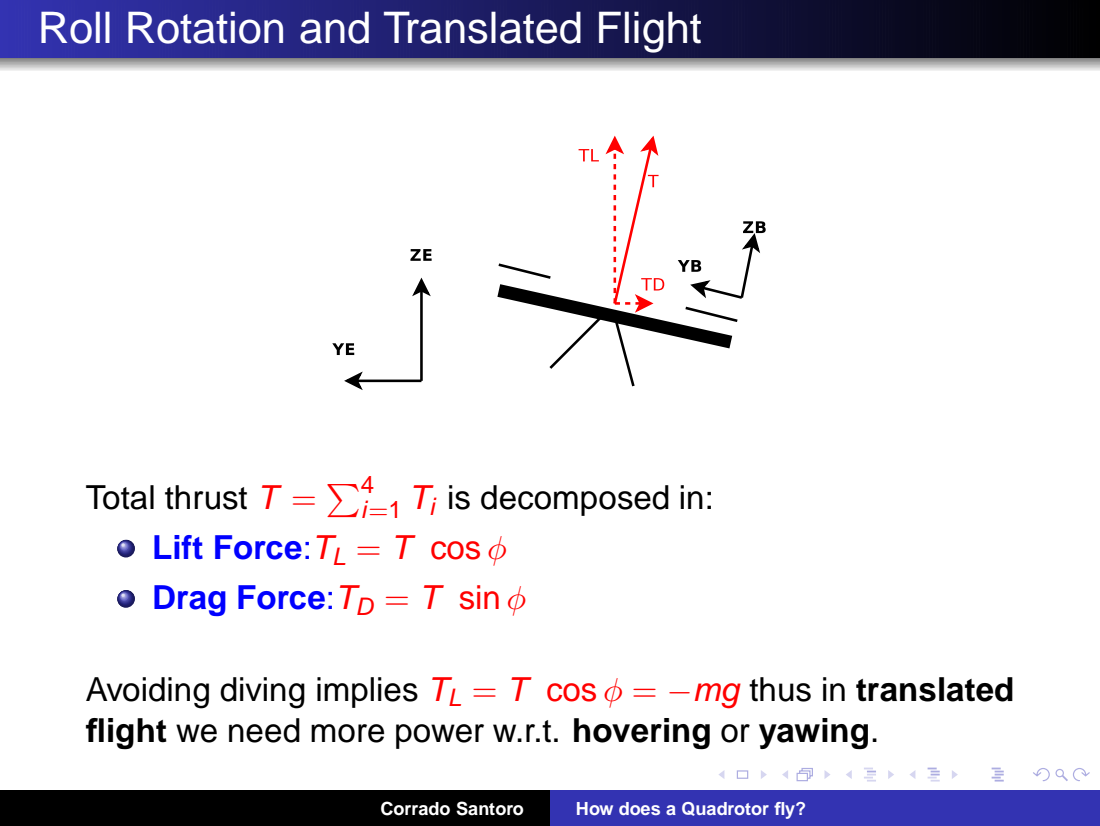
[picture p334: page 21]
is decomposed in:

Total thrust T =
Lift Force:TL = T cos φ
Drag Force:TD = T sin φ

Avoiding diving implies TL = T cos φ = −mg thus in translated
flight we need more power w.r.t. hovering or yawing.

## Pitch Rotation

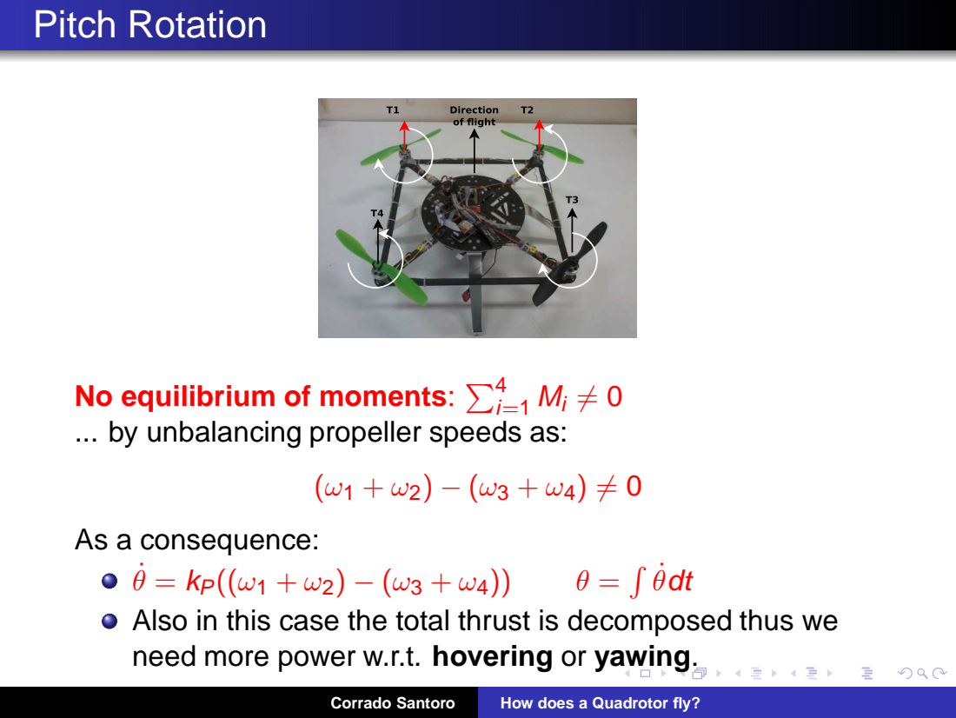
[picture p335: page 22]
˙θdt

No equilibrium of moments:
... by unbalancing propeller speeds as:

As a consequence:
Also in this case the total thrust is decomposed thus we
need more power w.r.t. hovering or yawing.

## Equations of Movement

We assume a common factor of proportionality k and F =

√
T
(we will see that such an assumption is not a problem!):

φ˙ = k((ω1 + ω4) − (ω2 + ω3)) = kω1 − kω2 − kω3 + kω4 ˙θ = k((ω1 + ω2) − (ω3 + ω4)) = kω1 + kω2 − kω3 − kω4 ψ˙ = k((ω1 + ω3) − (ω2 + ω4)) = kω1 − kω2 + kω3 − kω4
F = | k((ω1 + ω2 + ω3 + ω4)) | = kω1 + kω2 + kω3 + kω4

or, using matrices:

φ˙
˙θ
ψ˙
F
=

k −k −k k
k k −k −k
k −k k −k
k k | k | k

ω1
ω2
ω3
ω4

## Equations of Movement

φ˙
˙θ
ψ˙
F
=

k −k −k k
k k −k −k
k −k k −k
k k | k | k

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
This equation gives the angular velocities of the quadrotor, given the speed of the propellers.

But if we want to control the quadrotor we must understand how to set ωi
in order to impose a certain rotation rate of axis in the body frame.

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

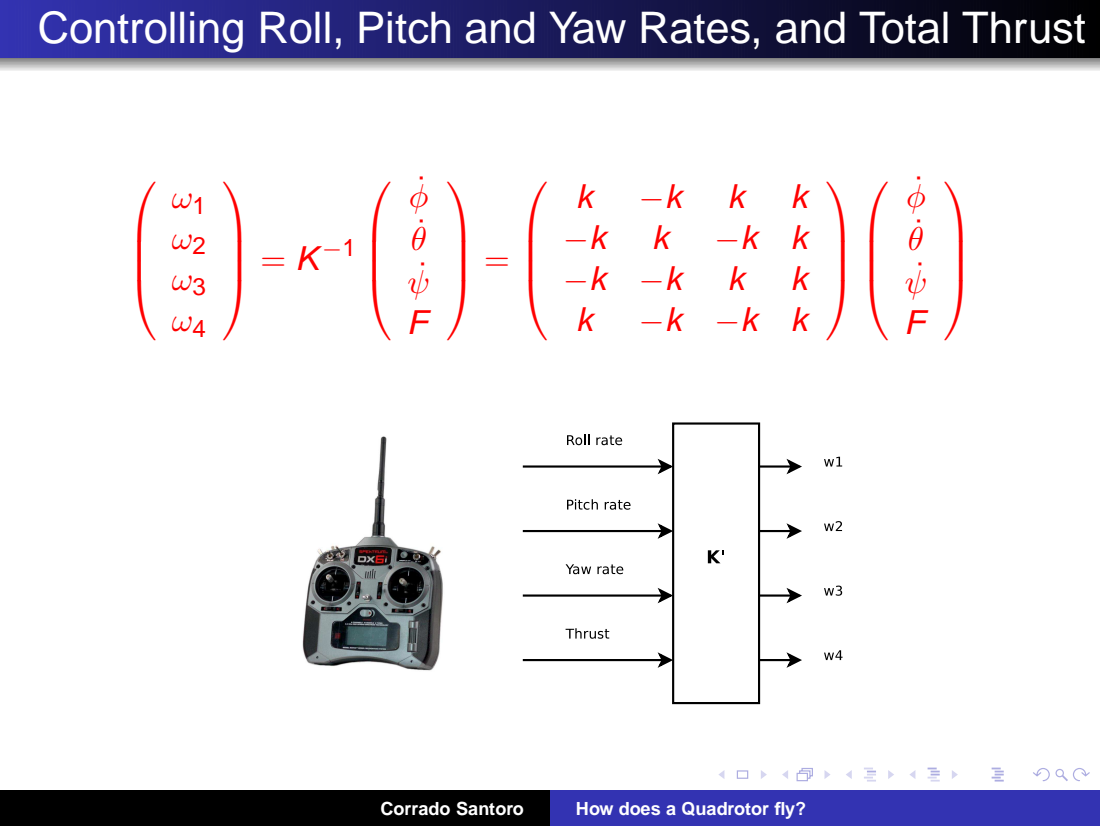
[picture p336: page 25]

## Part IV

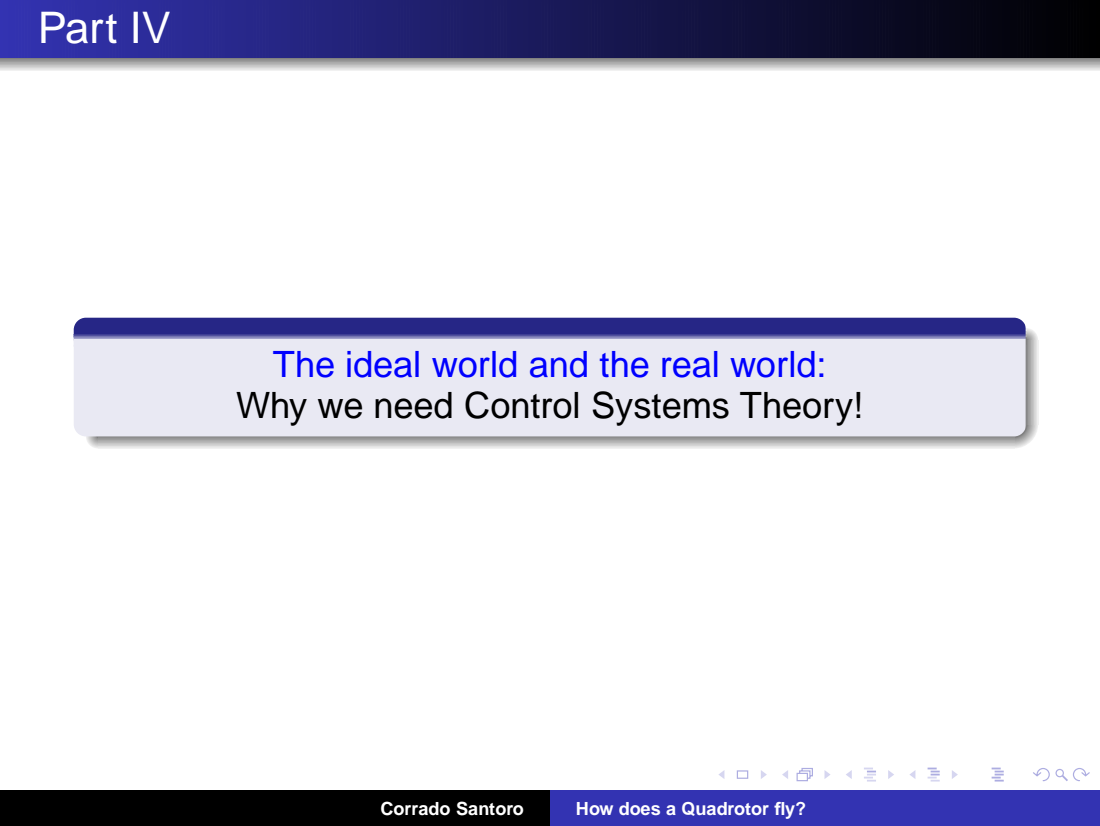
[picture p337: page 26]

The ideal world and the real world:
Why we need Control Systems Theory!

## Can we really set the rotation rate of propellers??

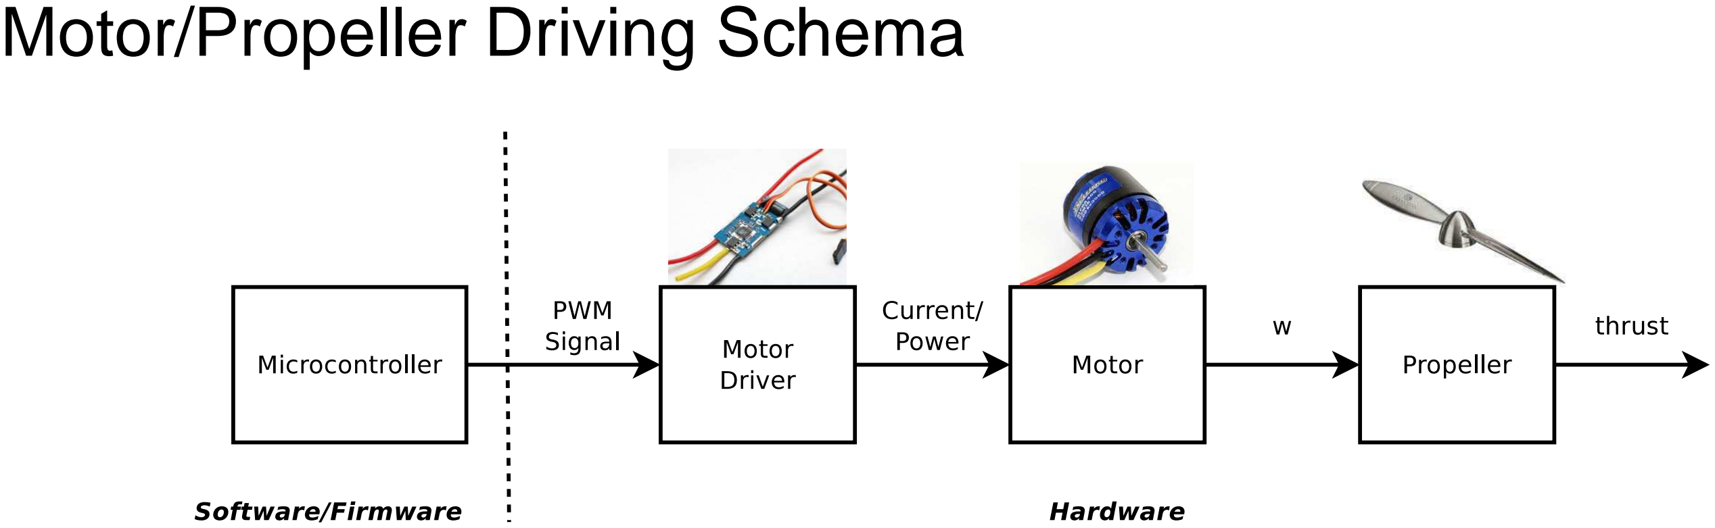
[picture p338: figure]
Motor/Propeller Driving Schema

Drivers, motors and propellers are chosen to be of the same type for the four arms.
Software (firmware) controls PWM, but ...

### 1 Are the drivers really all the same? 2 Are the motors really all the same? 3 Are the propellers really all the same? 4 Is the COG placed at the center of the quadrotor?

The answer is: In general, No!!

## Can we really set the rotation rate of propellers??

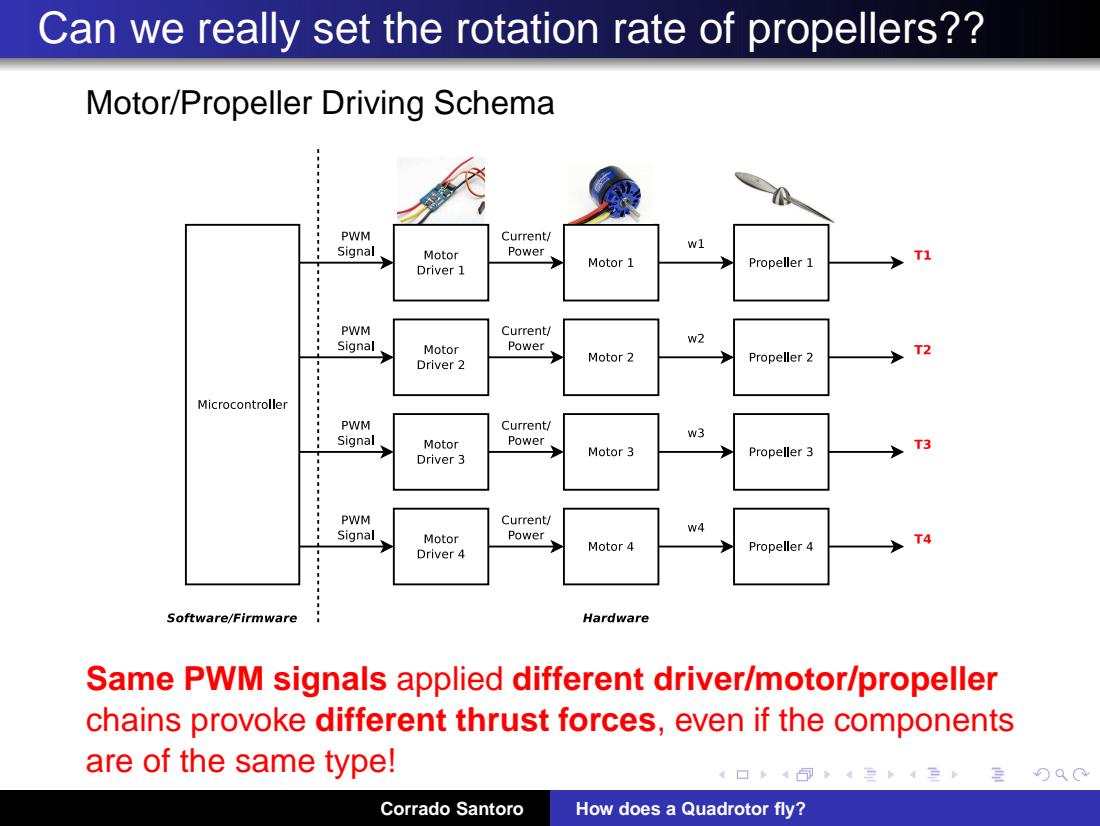
[picture p339: page 28]

Motor/Propeller Driving Schema

Same PWM signals applied different driver/motor/propeller
chains provoke different thrust forces, even if the components
are of the same type!

## The “Real world” effect

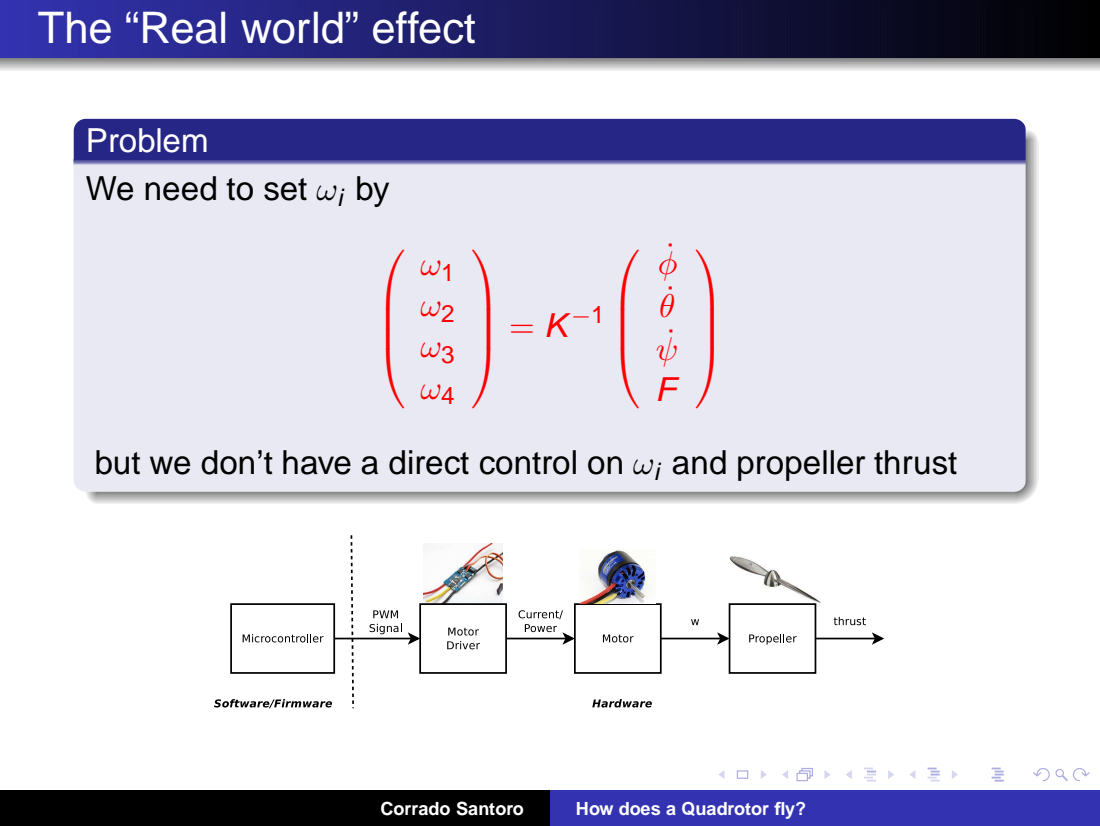
[picture p340: page 29]

Problem
We need to set ωi by

but we don’t have a direct control on ωi and propeller thrust

## The Mathematician/Physicists Solution

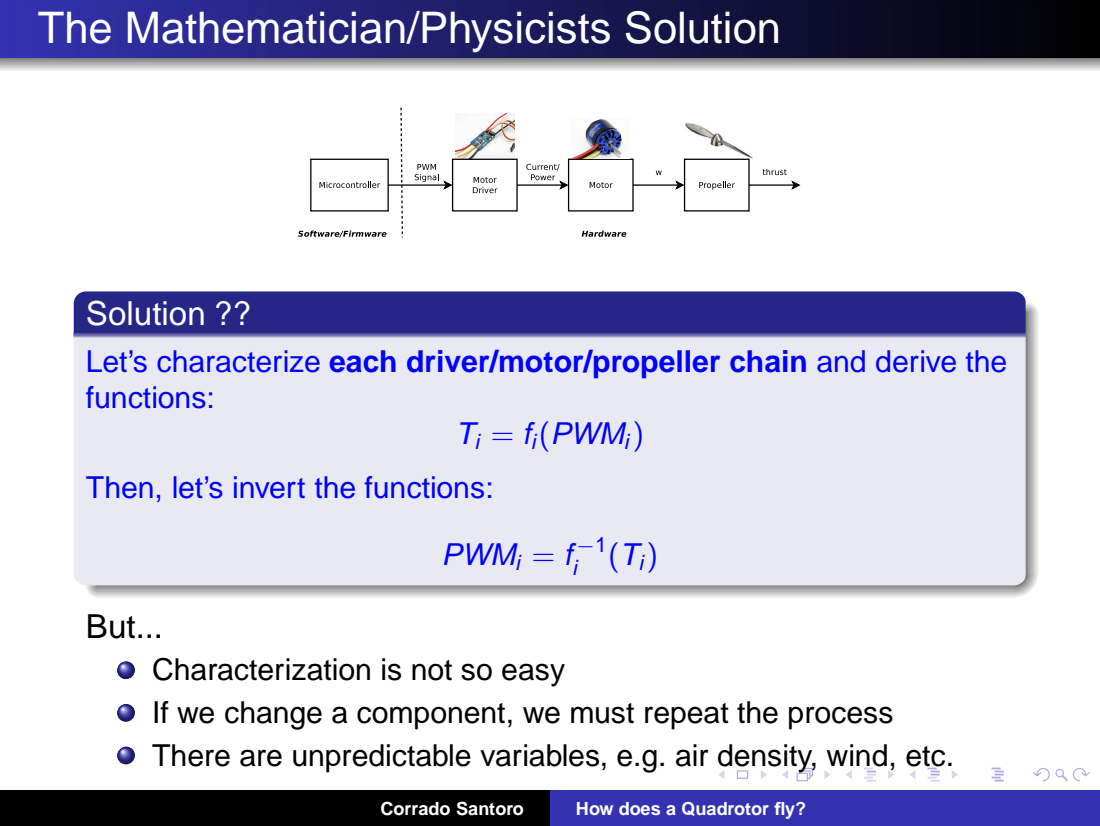
[picture p341: page 30]
PWMi = f

Solution ??
Let’s characterize each driver/motor/propeller chain and derive the
functions:

Ti = fi(PWMi)

Then, let’s invert the functions:

But...
Characterization is not so easy
If we change a component, we must repeat the process
There are unpredictable variables, e.g. air density, wind, etc.

## The Computer Scientist/Engineer Solution

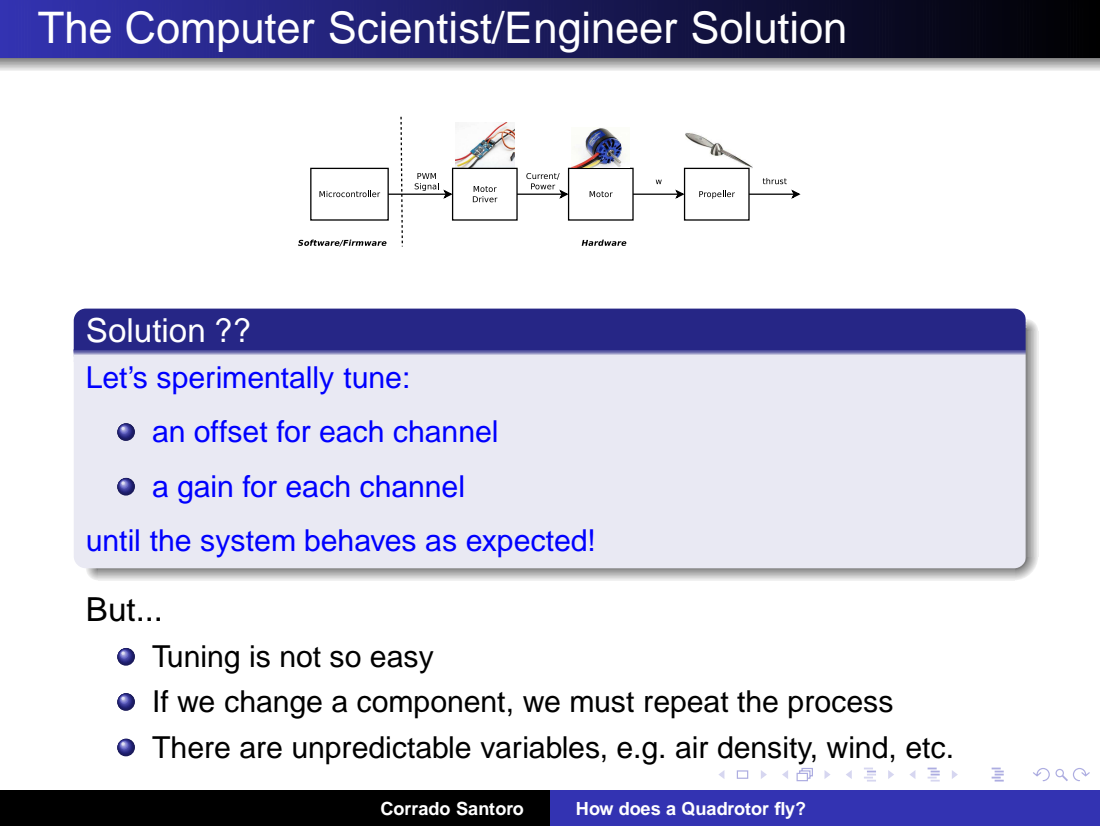
[picture p342: page 31]

Solution ??
Let’s sperimentally tune:
an offset for each channel
a gain for each channel
until the system behaves as expected!
But...
Tuning is not so easy
If we change a component, we must repeat the process
There are unpredictable variables, e.g. air density, wind, etc.

## The Control System Engineer Solution

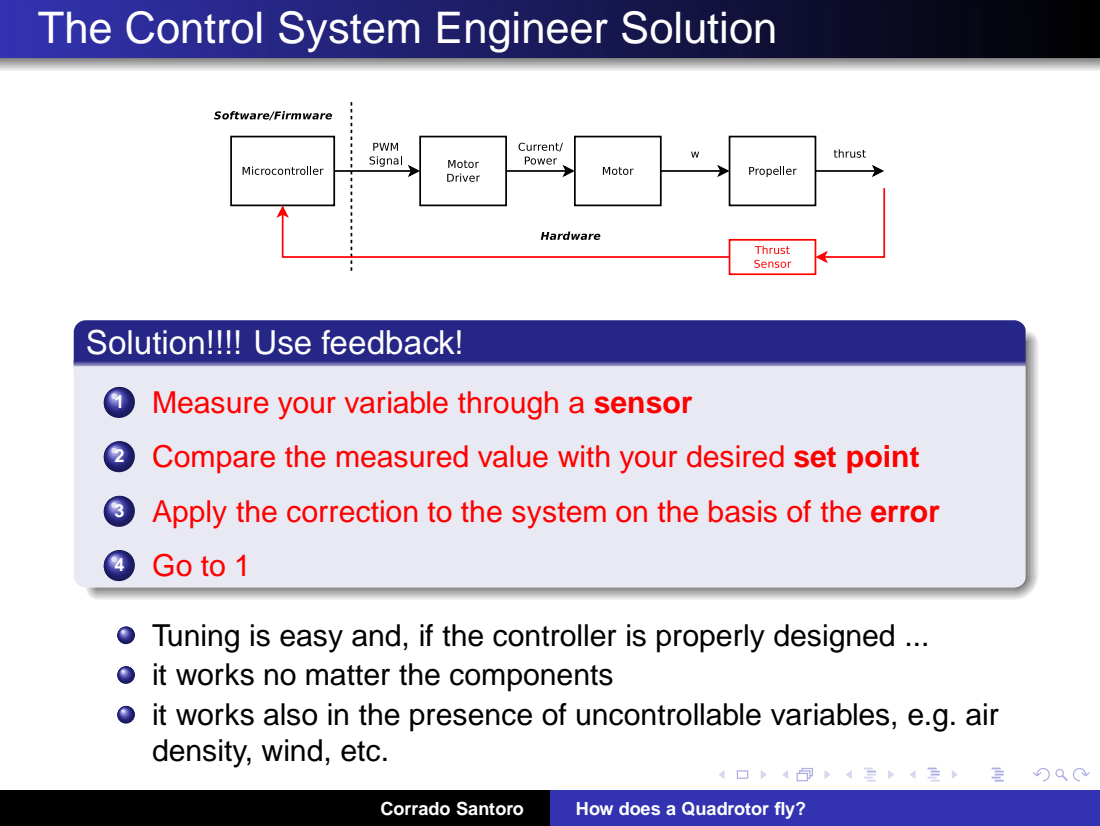
[picture p343: page 32]

Solution!!!! Use feedback!
1 Measure your variable through a sensor
2 Compare the measured value with your desired set point
3 Apply the correction to the system on the basis of the error

Tuning is easy and, if the controller is properly designed ...
it works no matter the components
it works also in the presence of uncontrollable variables, e.g. air
density, wind, etc.

## Our Scenario

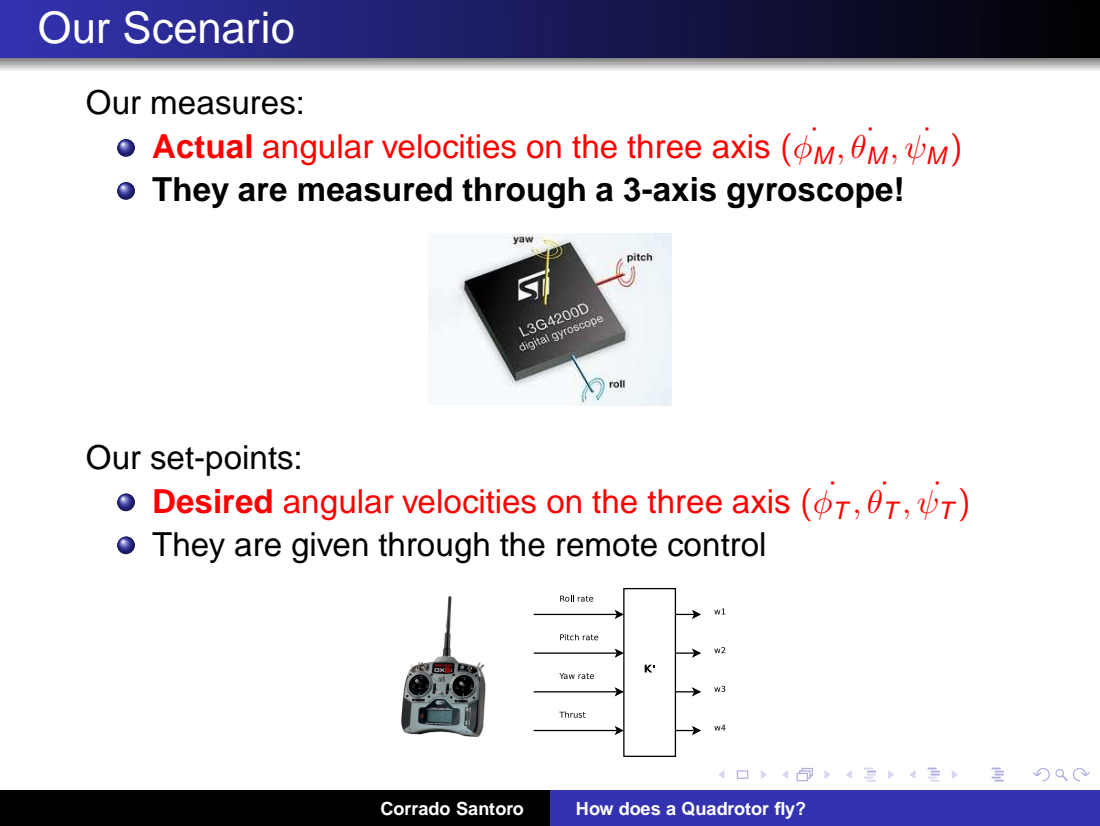
[picture p344: page 33]

Our measures:
Actual angular velocities on the three axis (φ˙M ,
They are measured through a 3-axis gyroscope!

Our set-points:
Desired angular velocities on the three axis (φ˙
They are given through the remote control

## Using Feedback to Control the Quadrotor

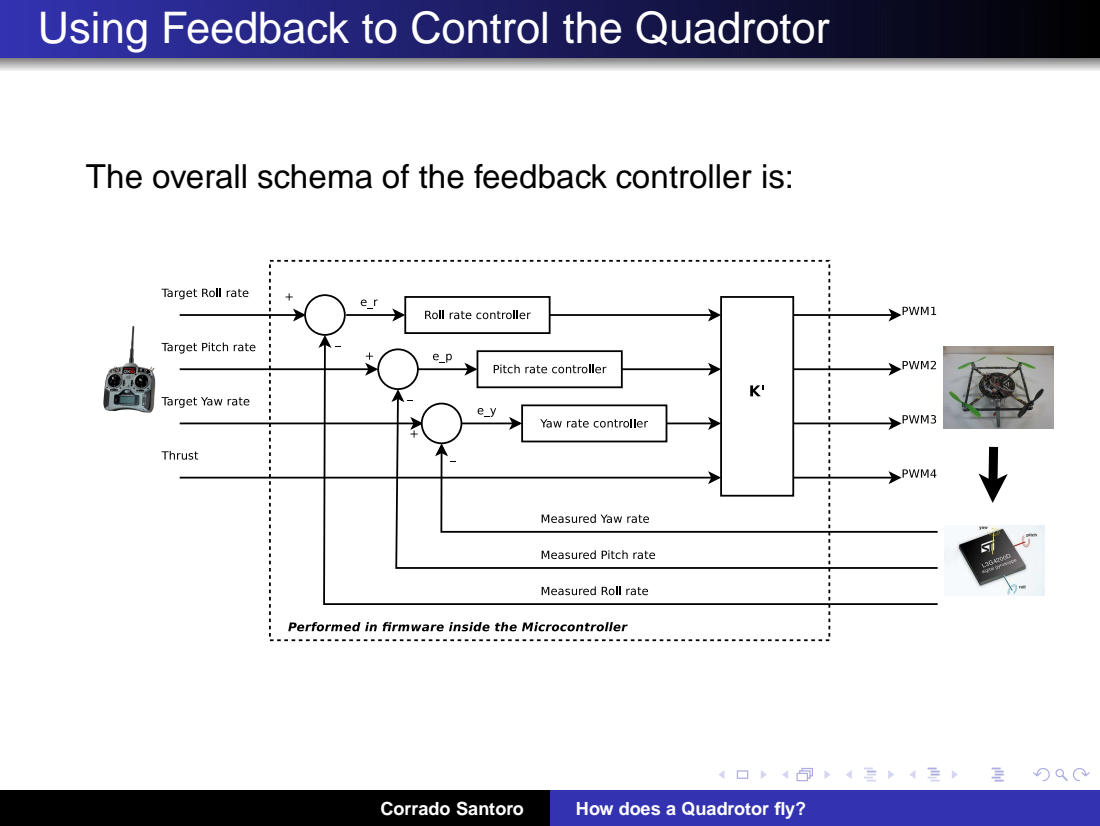
[picture p345: page 34]

The overall schema of the feedback controller is:

## Using Feedback to Control the Quadrotor

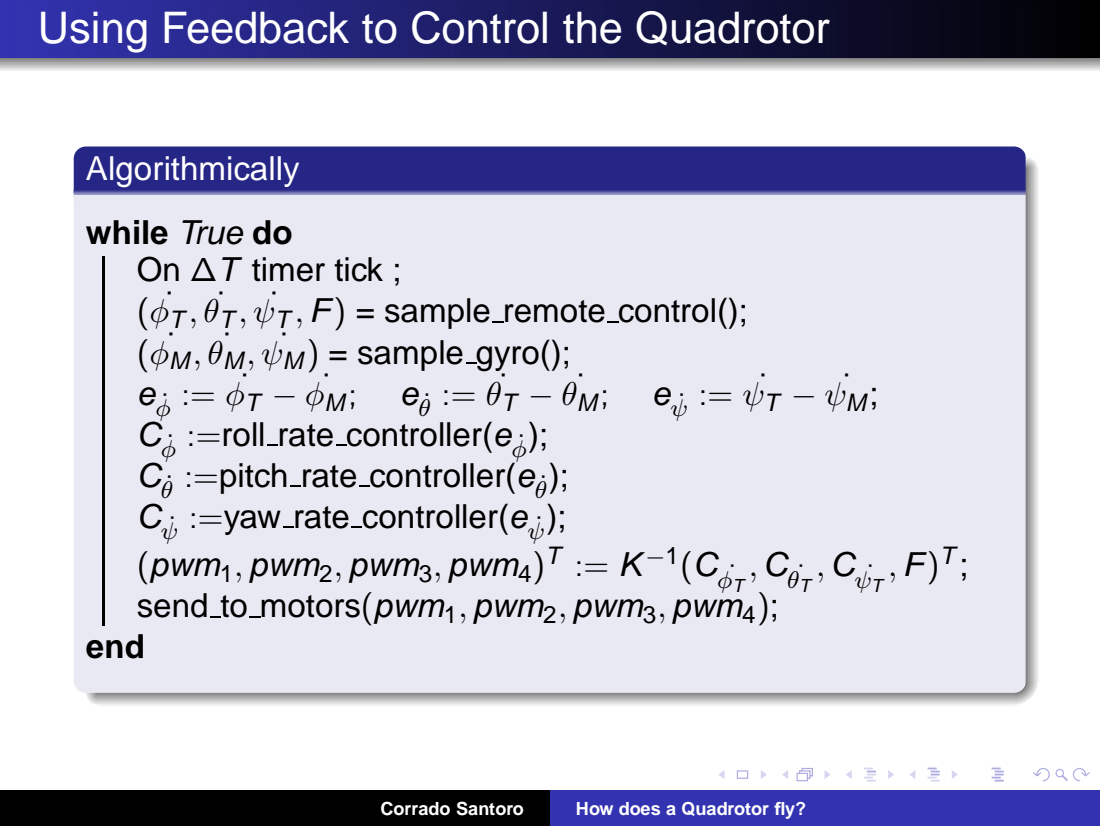
[picture p346: page 35]
Algorithmically; while True do On ∆T timer tick ; (φ˙ T , (φ˙M , eφ˙; :=roll rate controller(eφ˙);; :=pitch rate controller(e ˙θ; :=yaw rate controller(eψ˙); (pwm1, pwm2, pwm3, pwm4); send to motors(pwm1, pwm2, pwm3, pwm4); end

T , F) = sample remote control();
˙ θM , ψ˙M ) = sample gyro();

## Using Feedback to Control the Quadrotor

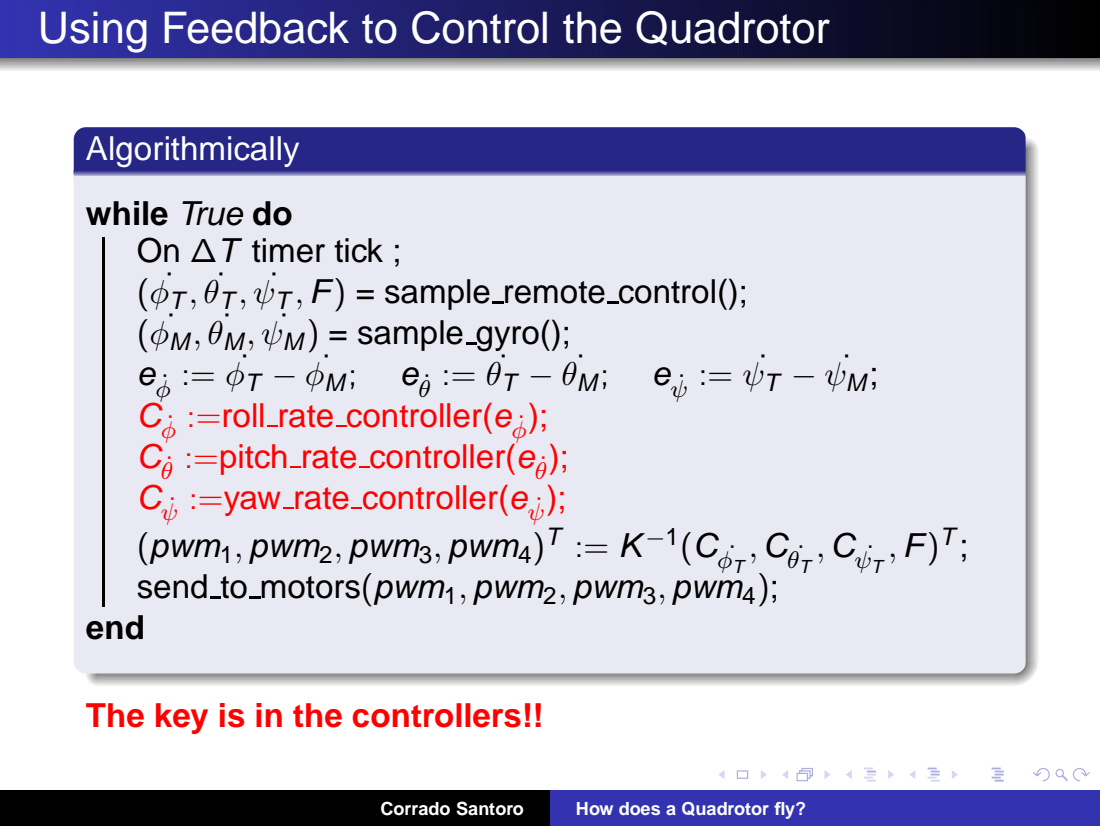
[picture p347: page 36]
Algorithmically; while True do On ∆T timer tick ; (φ˙ T , (φ˙M , eφ˙; :=pitch rate controller(eθ˙);; :=yaw rate controller(eψ˙); (pwm1, pwm2, pwm3, pwm4); send to motors(pwm1, pwm2, pwm3, pwm4); end

T , F) = sample remote control();
˙ θM , ψ˙M ) = sample gyro();
:=roll rate controller(eφ˙);

The key is in the controllers!!

## The P.I.D. Controller

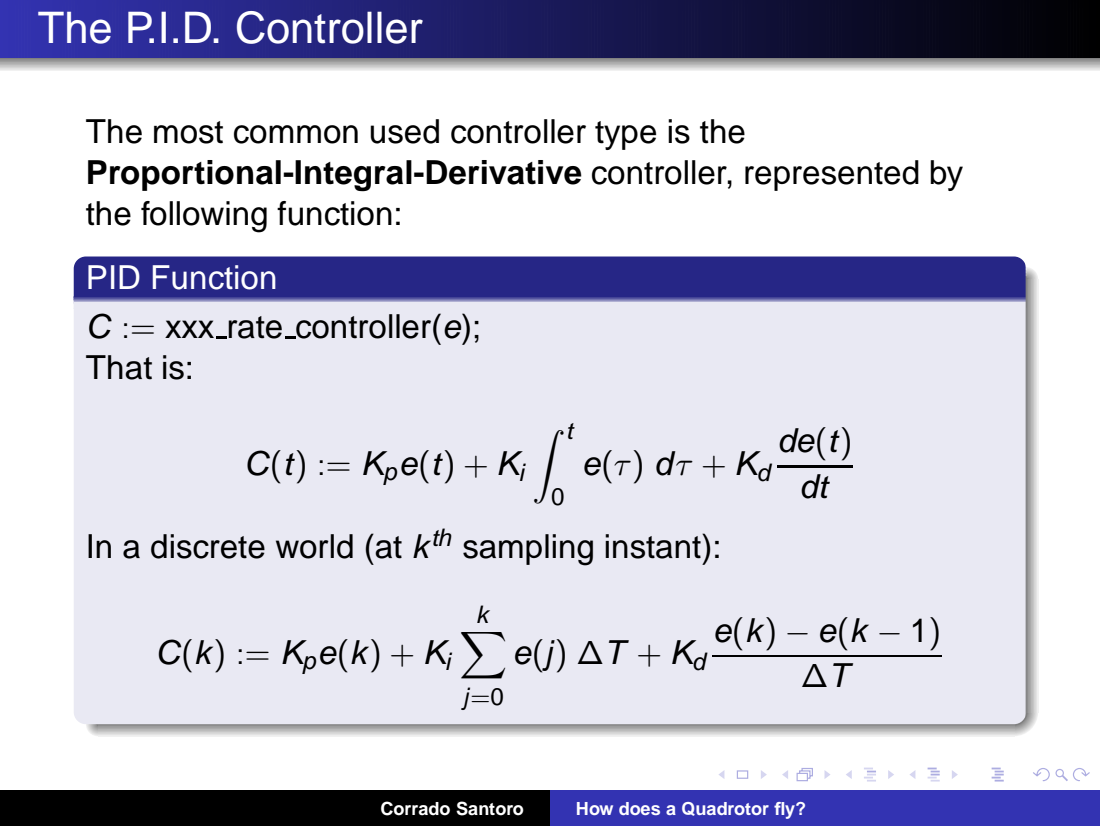
[picture p348: page 37]
C(t) := Kpe(t) + Ki; th sampling instant):; C(k) := Kpe(k) + Ki

The most common used controller type is the
Proportional-Integral-Derivative controller, represented by
the following function:
PID Function
C := xxx rate controller(e);
That is:

In a discrete world (at k

## The P.I.D. Controller

X

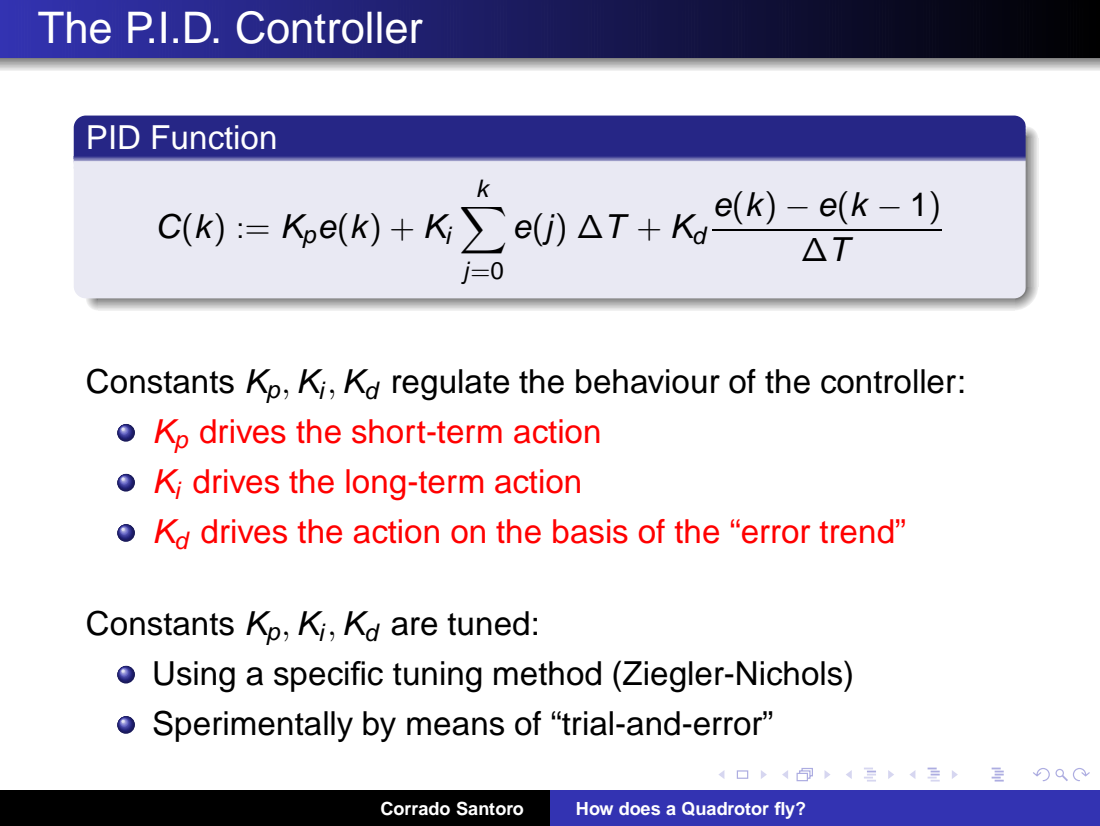
[picture p349: page 38]
PID Function; C(k) := Kpe(k) + Ki

Constants Kp,Ki
Kp drives the short-term action
Ki drives the long-term action
Kd drives the action on the basis of the “error trend”

,Kd regulate the behaviour of the controller:

Using a specific tuning method (Ziegler-Nichols)
Sperimentally by means of “trial-and-error”

,Kd are tuned:

## Part V

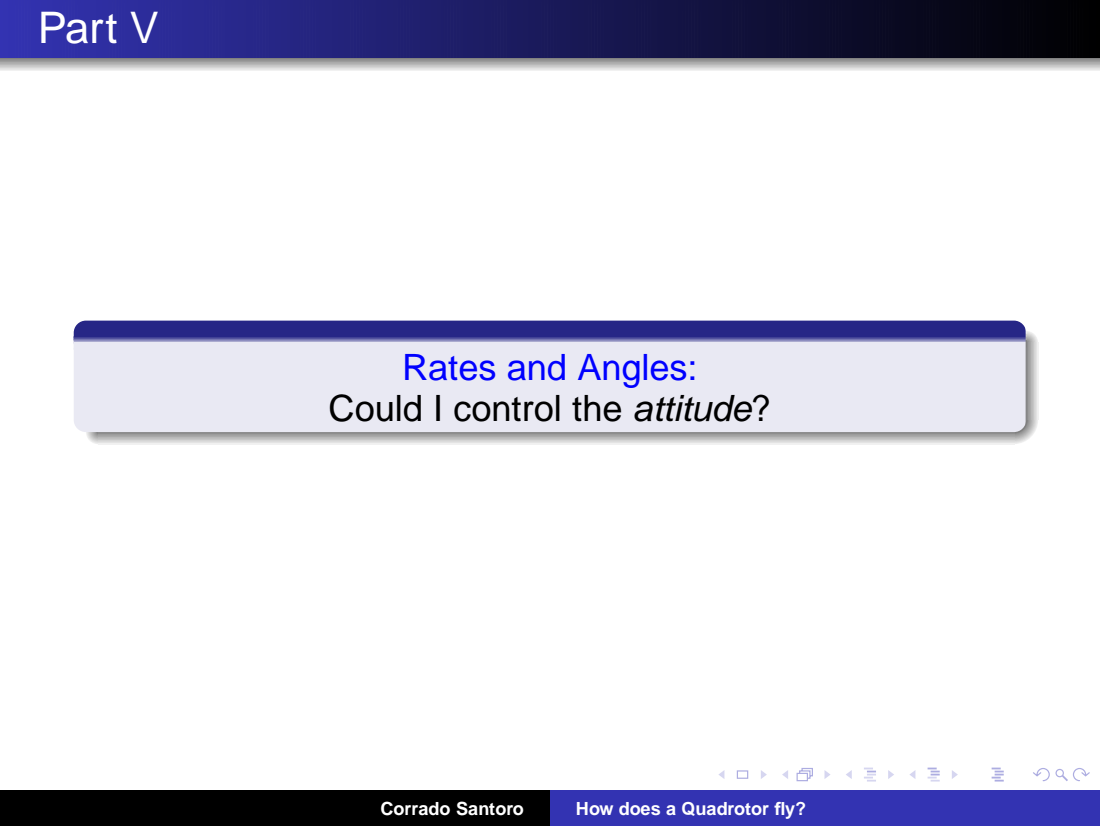
[picture p350: page 39]

Rates and Angles:
Could I control the attitude?

## Rates are not Angles

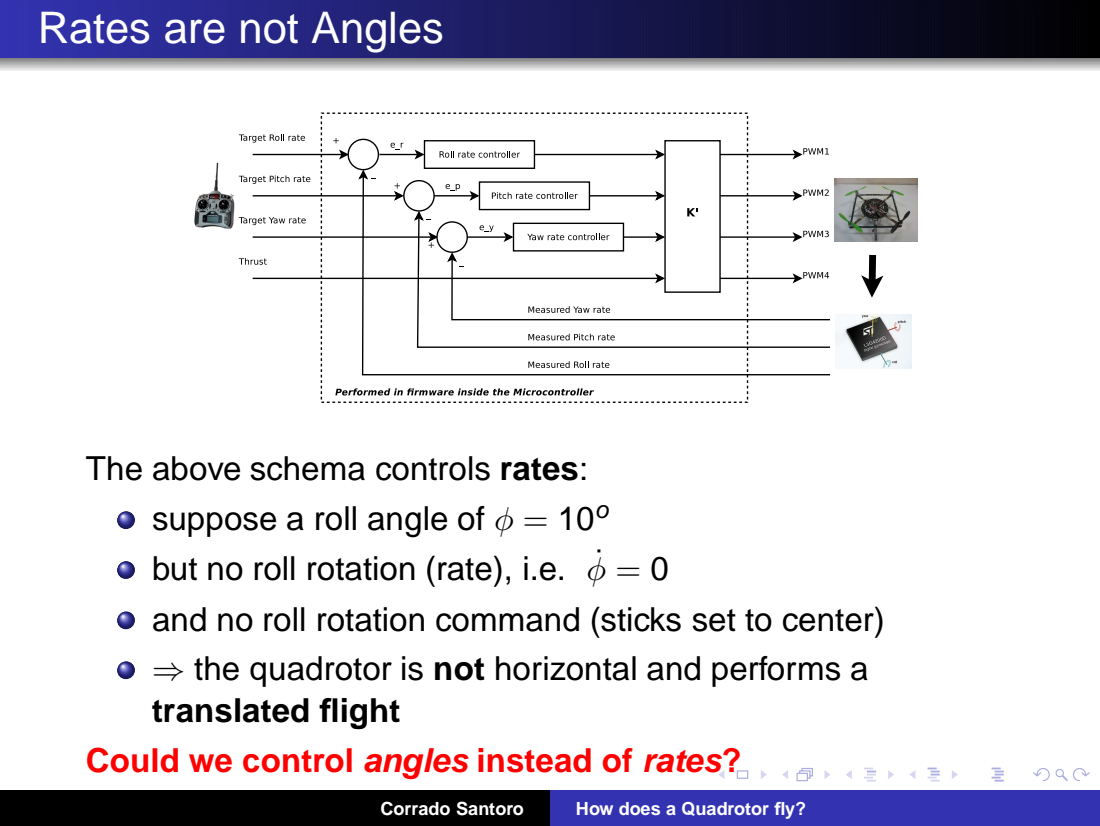
[picture p351: page 40]

The above schema controls rates:
suppose a roll angle of φ = 10o
but no roll rotation (rate), i.e. φ˙ = 0
and no roll rotation command (sticks set to center)
⇒ the quadrotor is not horizontal and performs a
translated flight
Could we control angles instead of rates?

## Measuring Angles (instead of Rates): Gyros

First we must measure euler angles (φ, θ, ψ)!
We could do this by using Gyroscopes, Accelerometers, Magnetometers, but...

Gyroscopes measure angular velocities which can be integrated in order to derive the angle α(t) = R t
0

α˙(τ )dτ , but:
Numeric integration is affected by approximation errors Gyroscopes are affected by an offset, i.e. they give non-zero value when the measure should be zero
Such an offset is not constant over time and depends on the temperature
The estimated angle is not reliable!

## Measuring Angles: Accelerometers

An accelerometer is a sensor measuring the acceleration over the three axis (ax , ay , az ).

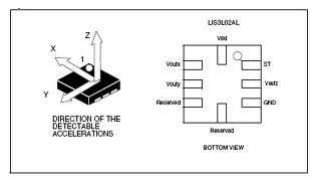
[picture p352: figure]
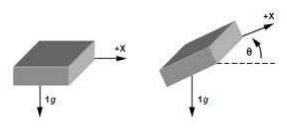
[picture p353: figure]

If the sensor is static sensed values are the projections of g vector in the sensor reference system
Two functions (using arctan) determines pitch and roll: φ = tan⁻¹ −ay

−az
θ = tan⁻¹

√ ax
a

2
y⁺a

2
z
But if the object is moving (e.g. shaking) other accelerations appear
The computed angles are not reliable!

## Measuring Angles: Two sensors, No reliability!

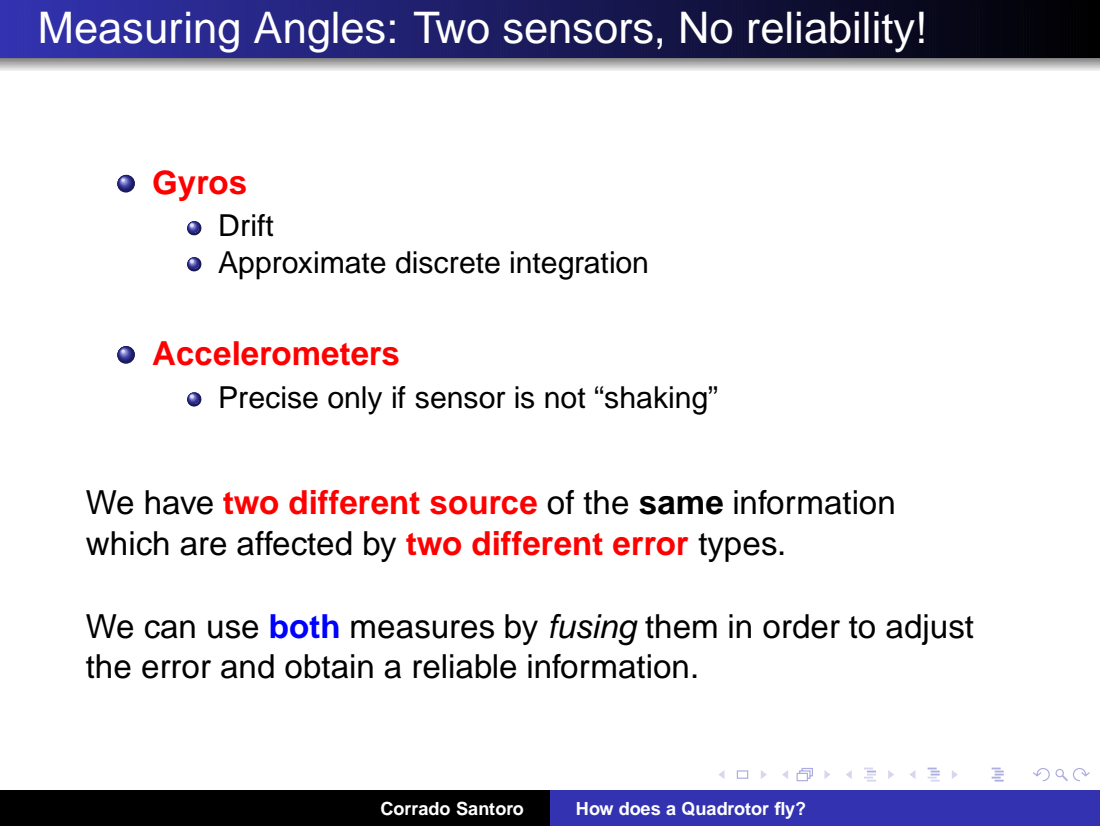
[picture p354: page 43]

Gyros
Drift
Approximate discrete integration

Accelerometers
Precise only if sensor is not “shaking”

We have two different source of the same information
which are affected by two different error types.

We can use both measures by fusing them in order to adjust
the error and obtain a reliable information.

## Sensor Fusion

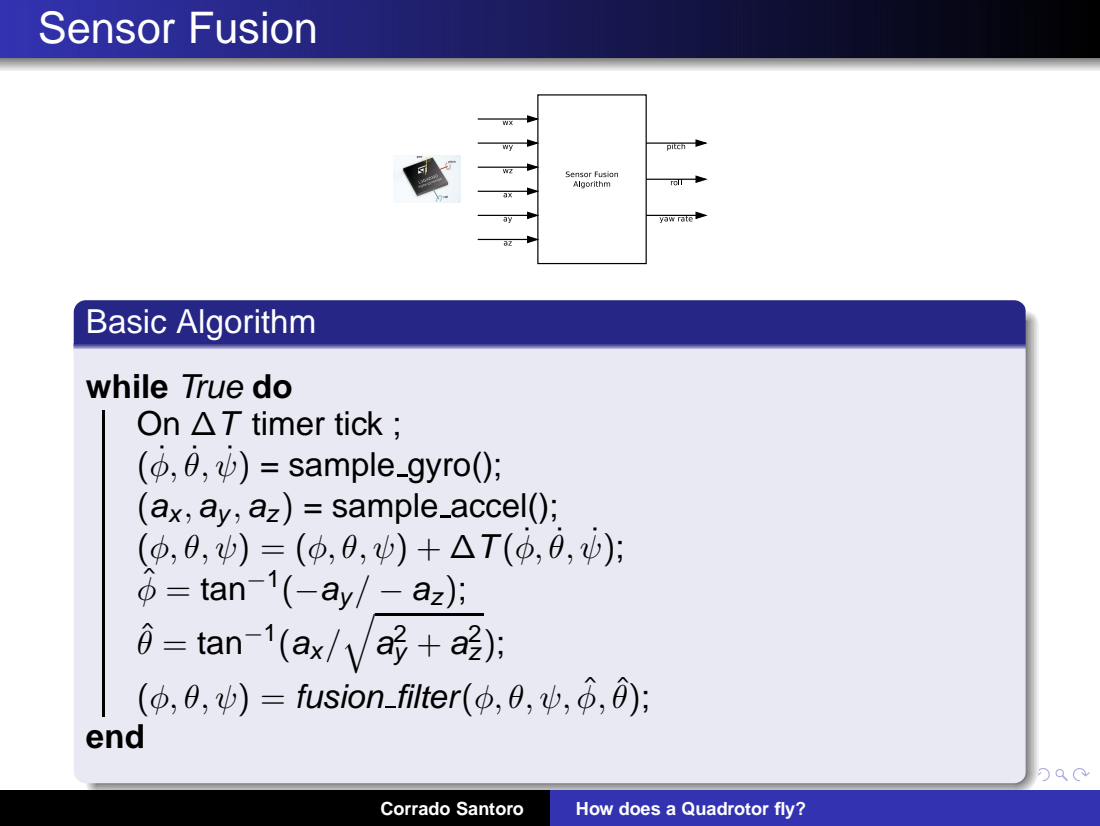
[picture p355: page 44]
Basic Algorithm; while True do On ∆T timer tick ; (φ,˙ ˙θ, ψ˙) = sample gyro(); (ax , ay , az ) = sample accel(); (φ, θ, ψ) = (φ, θ, ψ) + ∆T(φ,˙ ˙θ, ψ˙); φˆ = tan⁻¹

ˆθ = tan⁻¹
(φ, θ, ψ) = fusion filter(φ, θ, ψ, φ, ˆ θˆ);
end

## Sensor Fusion: Algorithms

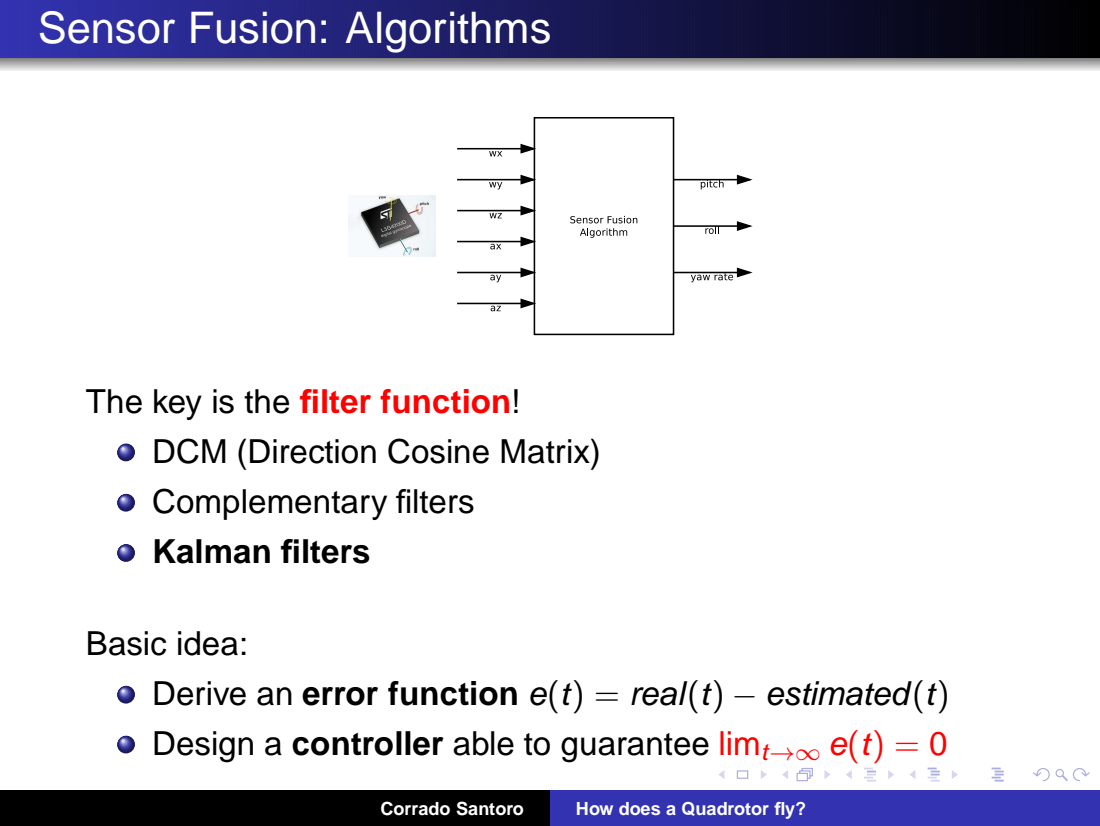
[picture p356: page 45]

The key is the filter function!
DCM (Direction Cosine Matrix)
Complementary filters
Kalman filters

Basic idea:
Derive an error function e(t) = real(t) − estimated(t)
Design a controller able to guarantee limt→∞ e(t) = 0

## Sensor Fusion: Algorithms

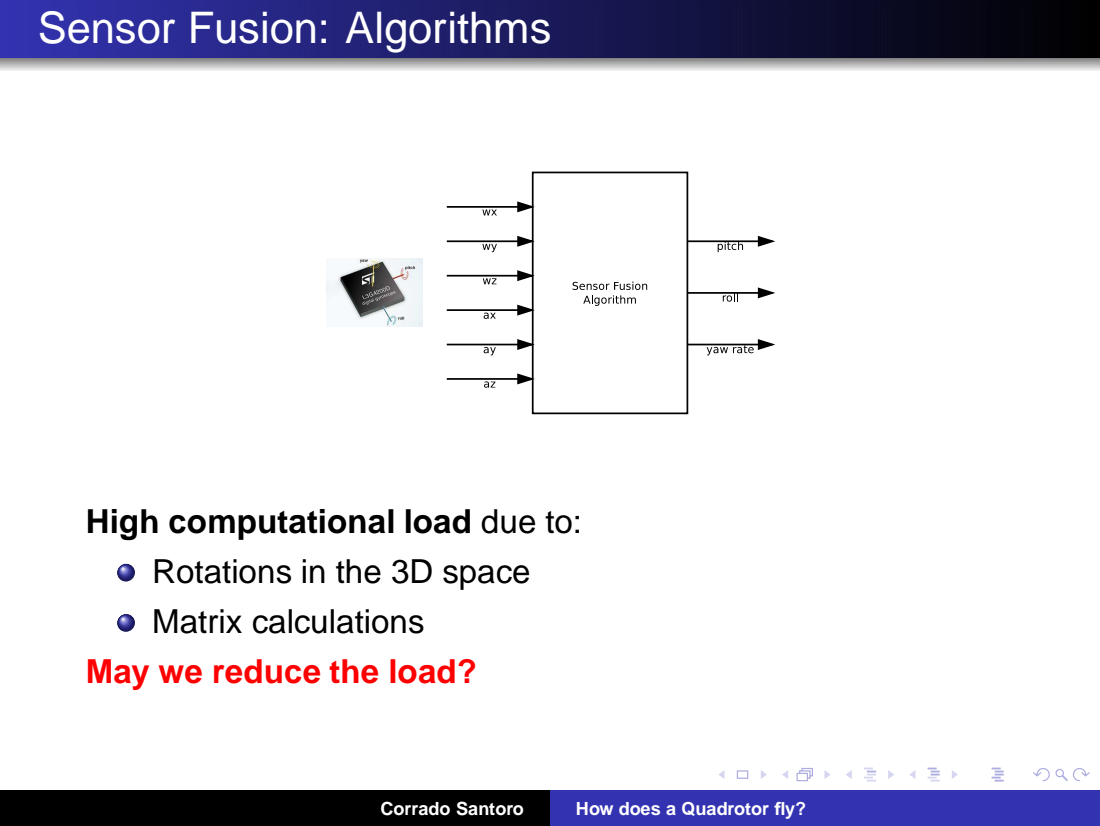
[picture p357: page 46]

High computational load due to:
Rotations in the 3D space
Matrix calculations
May we reduce the load?

## Representing Rotations in 3D

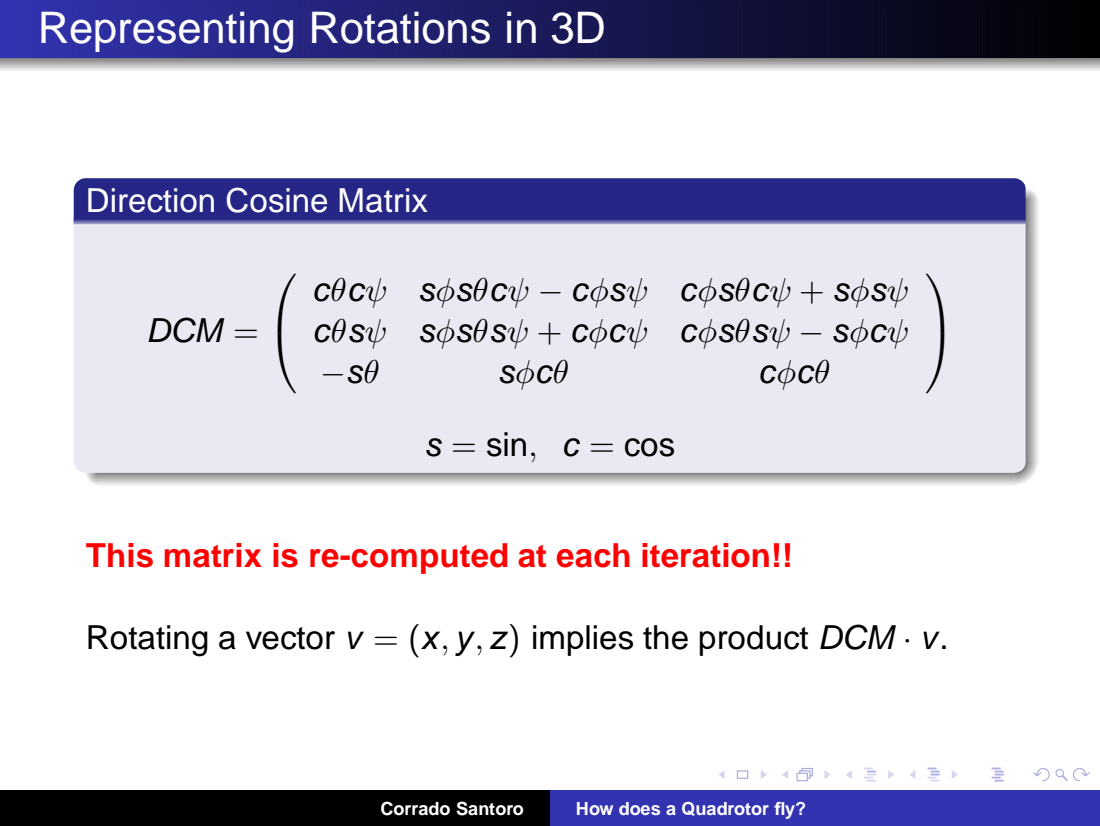
[picture p358: page 47]
DCM =; sφcθ; cφcθ

Direction Cosine Matrix
cθsψ sφsθsψ + cφcψ cφsθsψ − sφcψ
s = sin, c = cos

cθcψ sφsθcψ − cφsψ cφsθcψ + sφsψ

This matrix is re-computed at each iteration!!

Rotating a vector v = (x, y, z) implies the product DCM · v.

## Representing Rotations in 3D

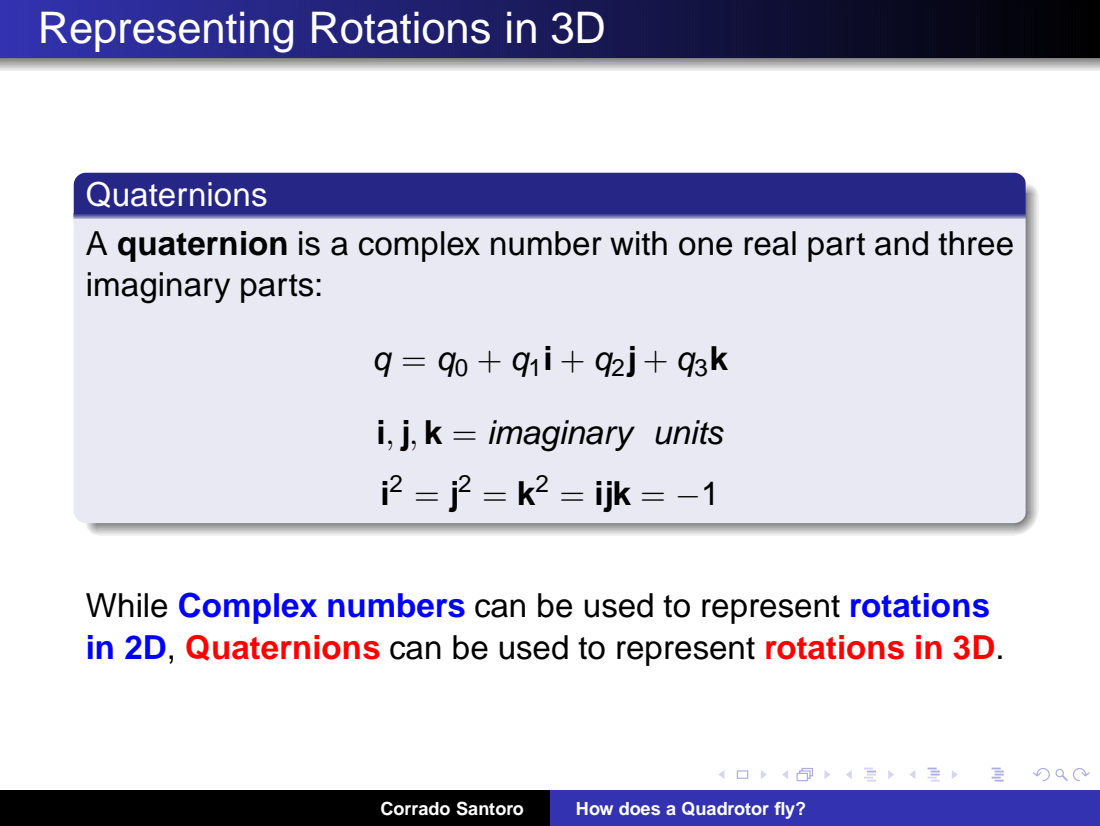
[picture p359: page 48]
i, j, k = imaginary units; 2 = ijk = −1

Quaternions
A quaternion is a complex number with one real part and three
imaginary parts:

While Complex numbers can be used to represent rotations
in 2D, Quaternions can be used to represent rotations in 3D.

## Rotations in 3D and Quaternions

Transformations from Euler angles to quaternion exist:

q → (φ, θ, ψ)

(φ, θ, ψ) → q

Rotating a vector v using a quaternion implies the product qvq∗ where q
∗

is the conjugate of q and v = {0, vx , vy , vz }. The overall fusion algorithm can be written using quaternion algebra, thus avoiding continuous sin, cos calculation.
Quaternions avoid gimbal lock!
The attitude can be easily obtained by using:

q → (φ, θ, ψ)

## So far so good: Controlling attitude

Attitude control is achieved using (once again) feedback controllers.
We set the Target (desired) Attitude (φT , θT , ψ˙
T ) from
remote controller.
Current quad attitude (φM , θM , ψ˙M ) is computed using sensor fusion.
The error signals (differences) are sent to PID controllers whose output are the target rates for rate controllers. The basic model is “cascading controllers”: attitude controllers which drives rate controllers.

## Let’s remind the schema of Rate Controllers

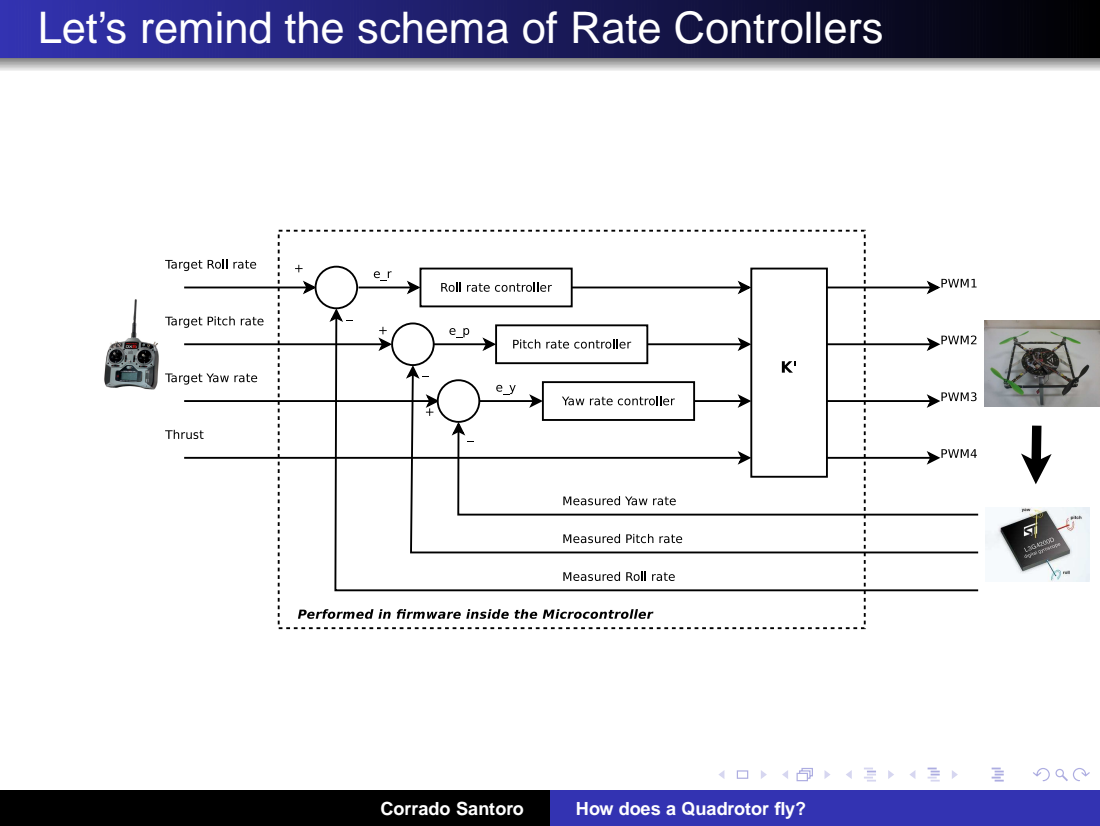
[picture p360: page 51]

## Complete Attitude Controller

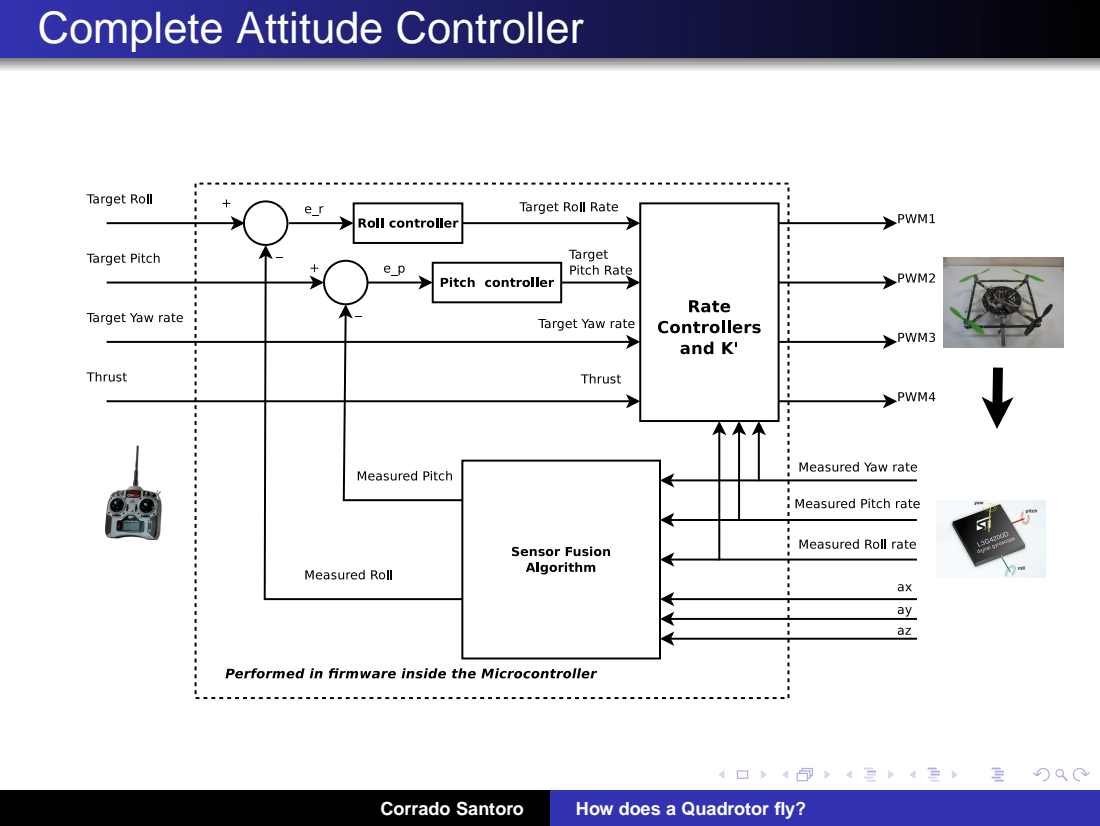
[picture p361: page 52]

## Control “loops”: Requirements

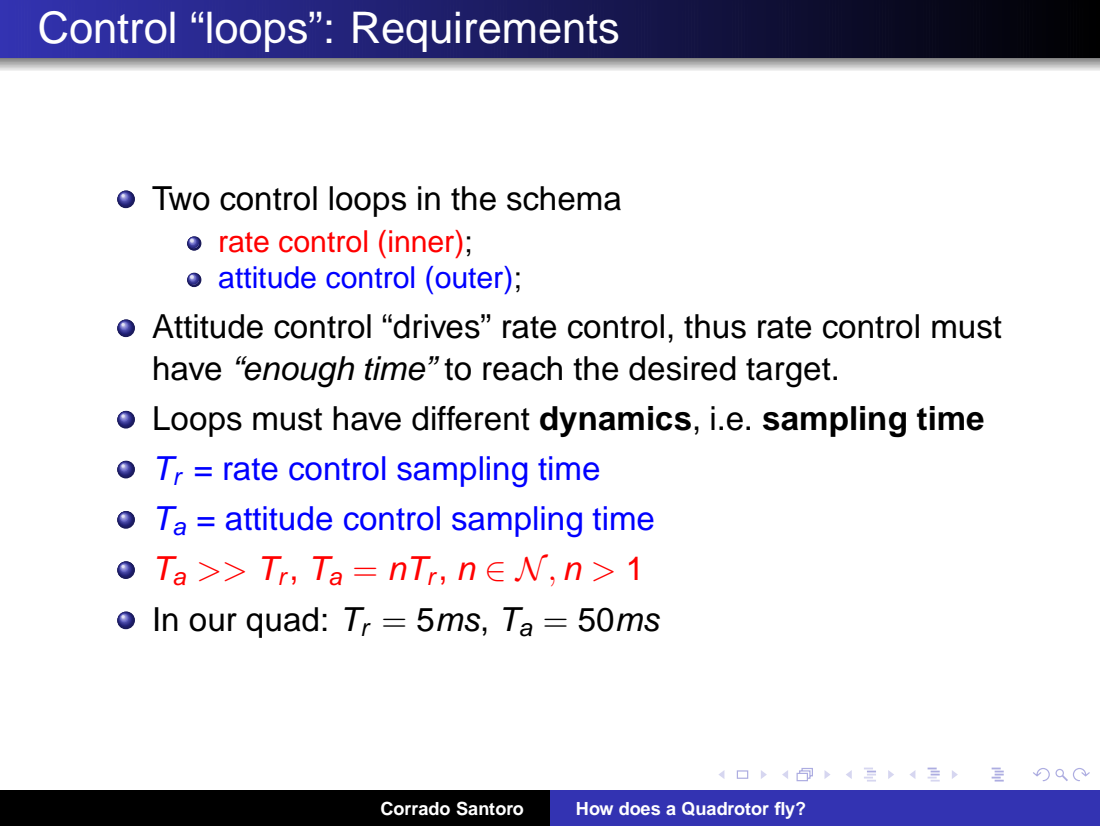
[picture p362: page 53]
, Ta = nTr

Two control loops in the schema
rate control (inner);
attitude control (outer);
Attitude control “drives” rate control, thus rate control must
have “enough time” to reach the desired target.
Loops must have different dynamics, i.e. sampling time
Tr = rate control sampling time
Ta = attitude control sampling time
In our quad: Tr = 5ms, Ta = 50ms

## Finally, the overall algorithm

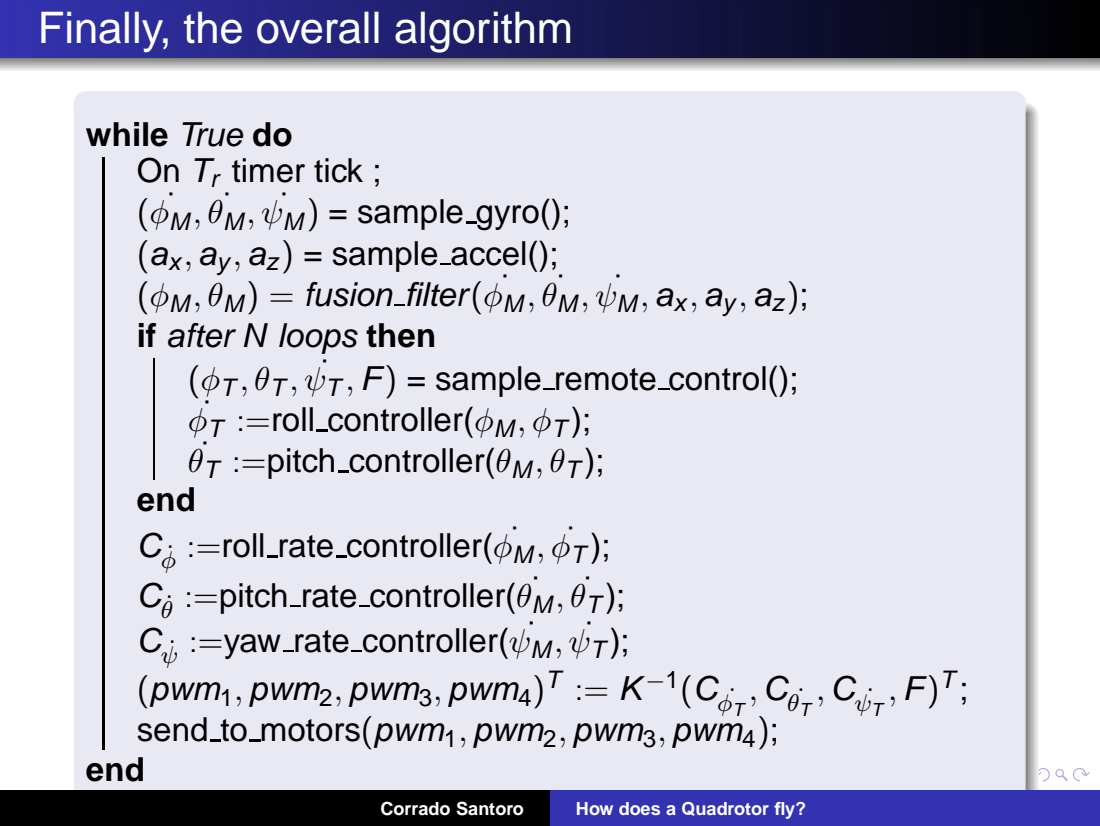
[picture p363: page 54]

while True do
timer tick ;
(ax , ay , az ) = sample accel();
(φM , θM ) = fusion filter(φ˙M ,
if after N loops then
T :=roll controller(φM , φT );
˙θT :=pitch controller(θM , θT );
end
:=roll rate controller(φ˙M , φ˙
:=pitch rate controller( ˙ θM ,
:=yaw rate controller(ψ˙M , ψ˙
(pwm1, pwm2, pwm3, pwm4)
send to motors(pwm1, pwm2, pwm3, pwm4);

˙ θM , ψ˙M ) = sample gyro();

T , F) = sample remote control();

## Part VI

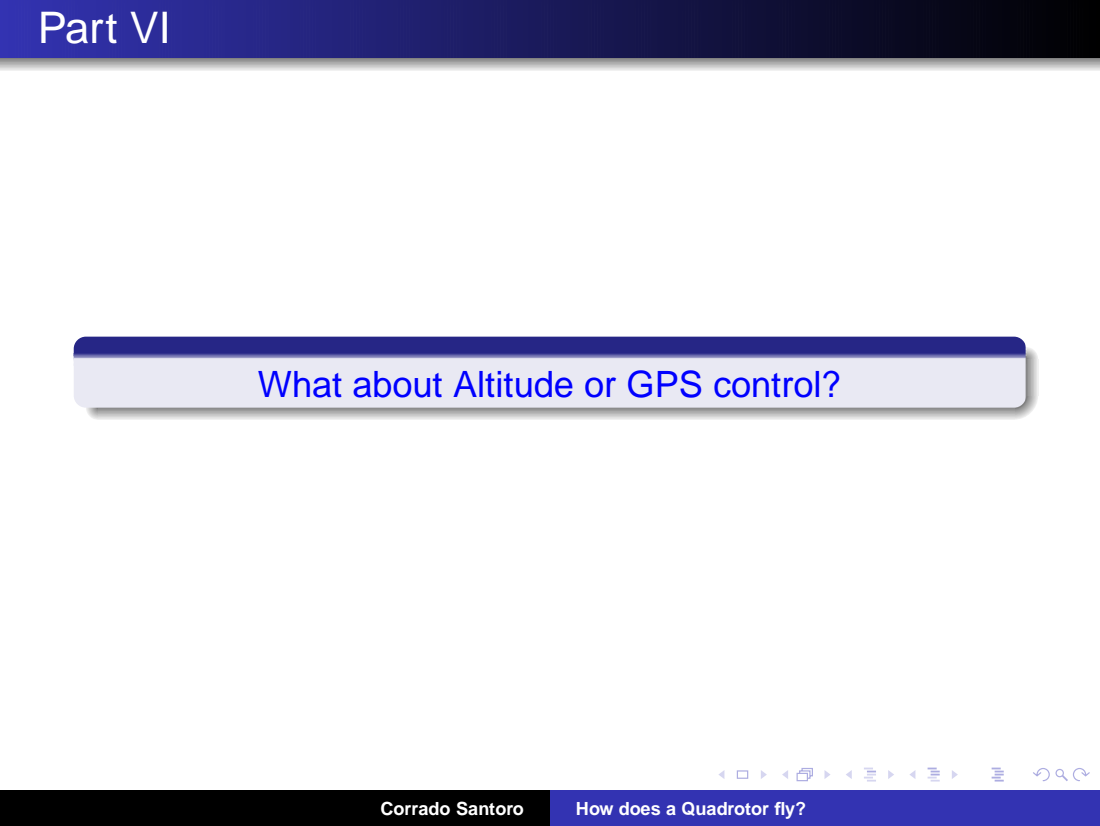
[picture p364: page 55]

What about Altitude or GPS control?

## Let’s repeat the schema!

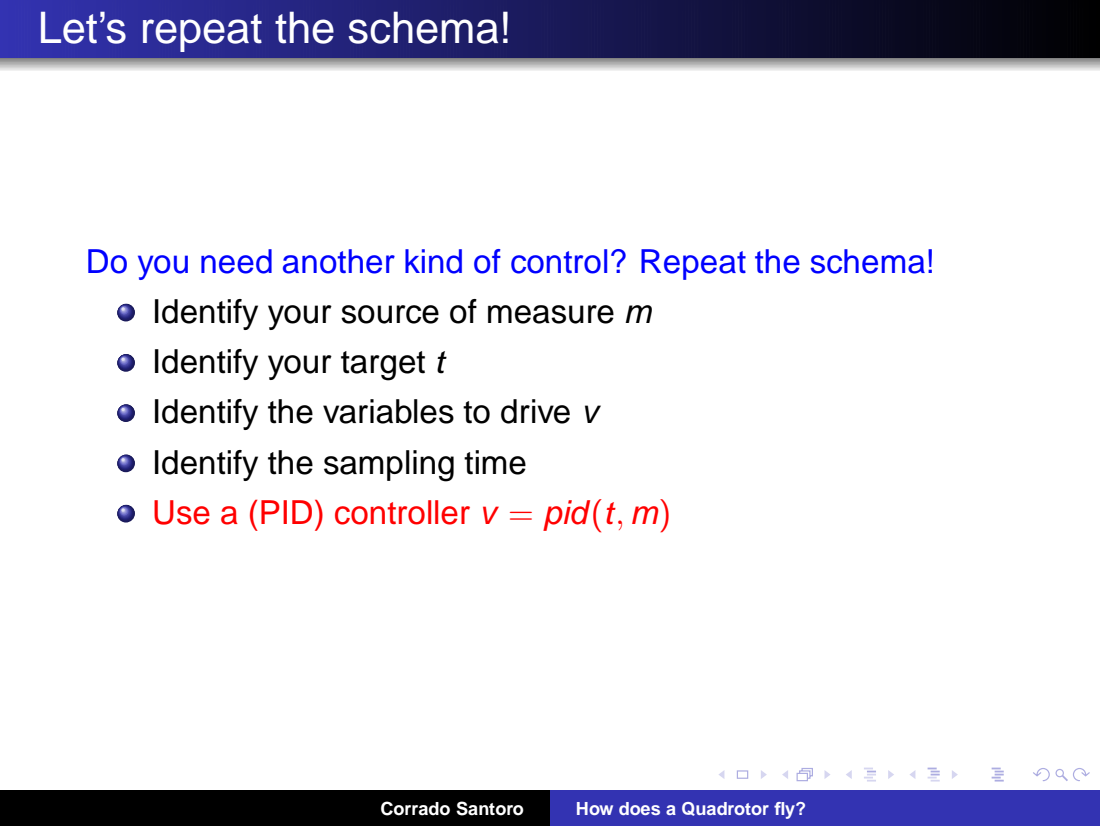
[picture p365: page 56]

Do you need another kind of control? Repeat the schema!
Identify your source of measure m
Identify your target t
Identify the variables to drive v
Identify the sampling time
Use a (PID) controller v = pid(t, m)

## Altitude Control

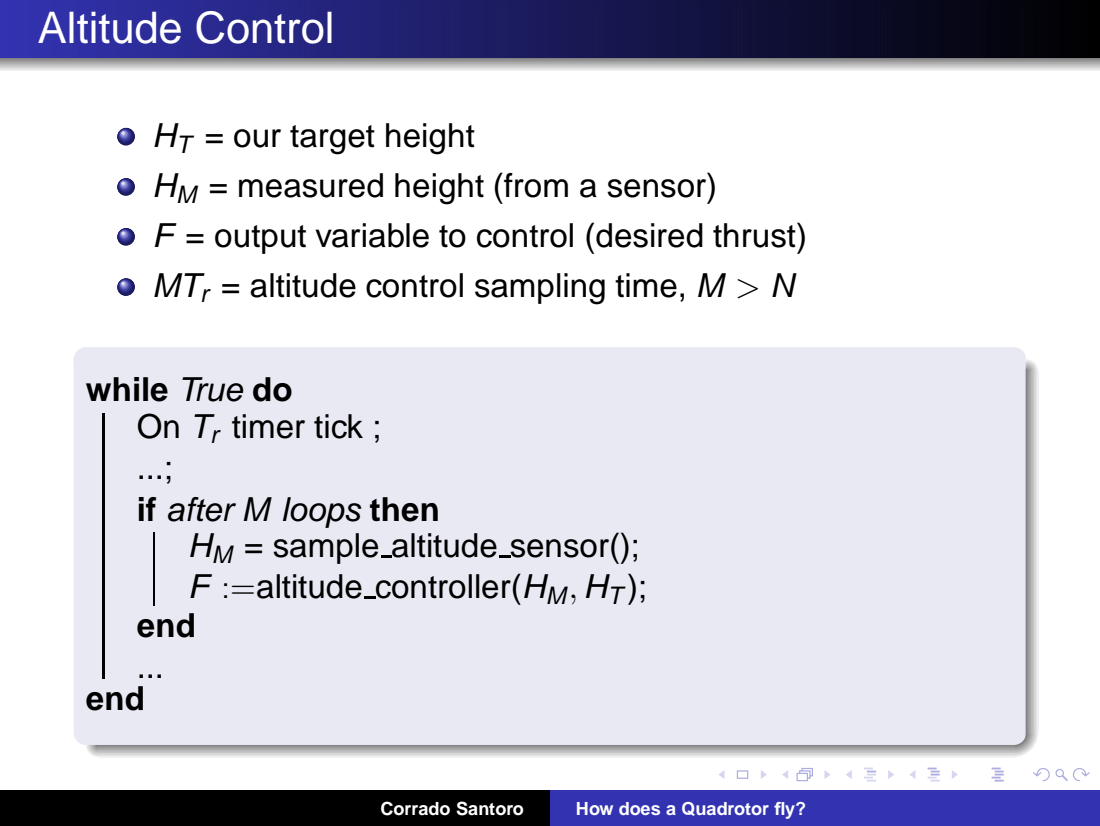
[picture p366: page 57]

HT = our target height
HM = measured height (from a sensor)
F = output variable to control (desired thrust)
MTr = altitude control sampling time, M > N

while True do
timer tick ;
if after M loops then
HM = sample altitude sensor();
F :=altitude controller(HM, HT );
end

## GPS Control

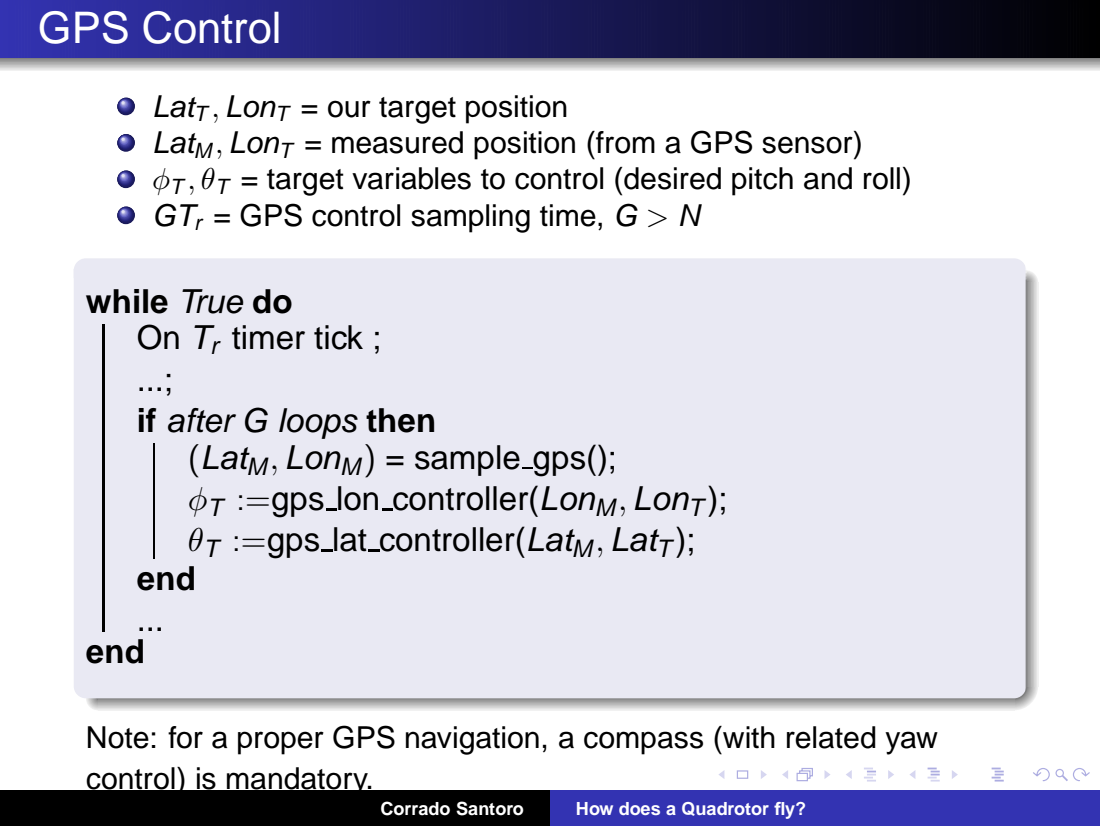
[picture p367: page 58]

LatT , LonT = our target position
LatM , LonT = measured position (from a GPS sensor)
φT , θT = target variables to control (desired pitch and roll)
GTr = GPS control sampling time, G > N

while True do
timer tick ;
if after G loops then
(LatM, LonM) = sample gps();
φT :=gps lon controller(LonM, LonT );
θT :=gps lat controller(LatM , LatT );
end

Note: for a proper GPS navigation, a compass (with related yaw
control) is mandatory.

## Vision-based Control

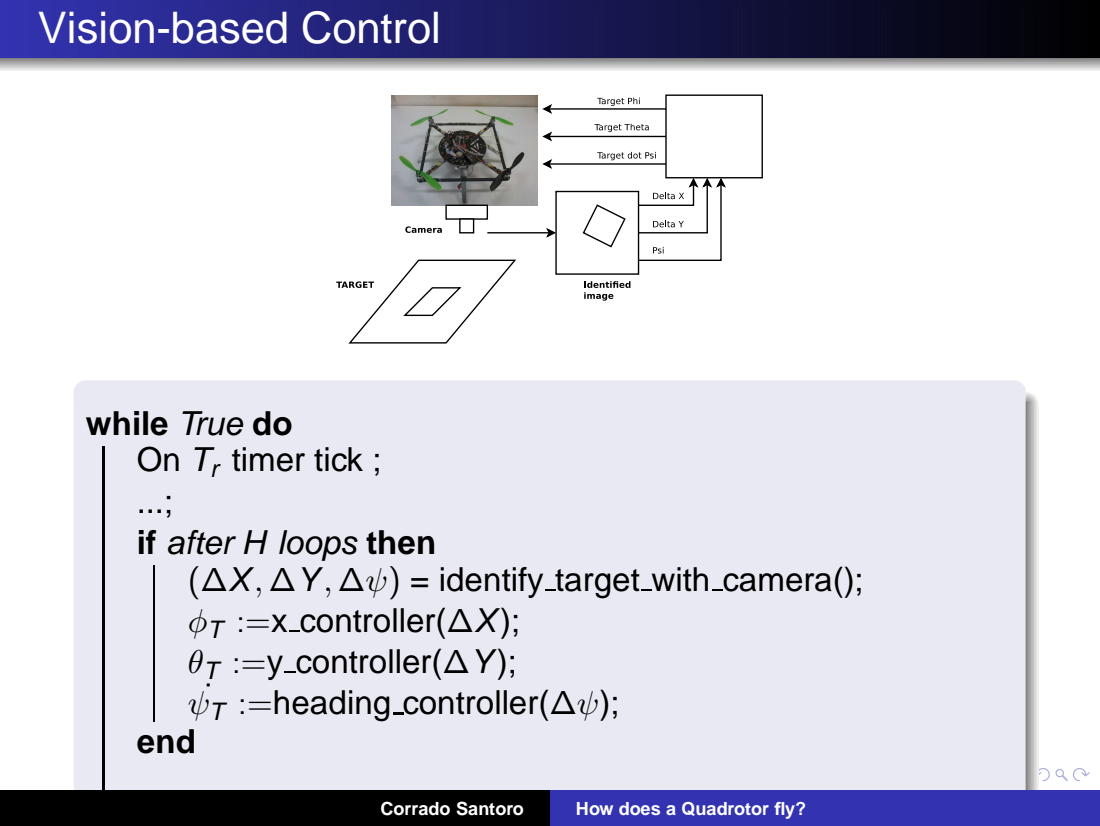
[picture p368: page 59]
end; Corrado Santoro; How does a Quadrotor fly?

while True do
timer tick ;
if after H loops then
(∆X, ∆Y, ∆ψ) = identify target with camera();
φT :=x controller(∆X);
θT :=y controller(∆Y);
T :=heading controller(∆ψ);
end

## Conclusions

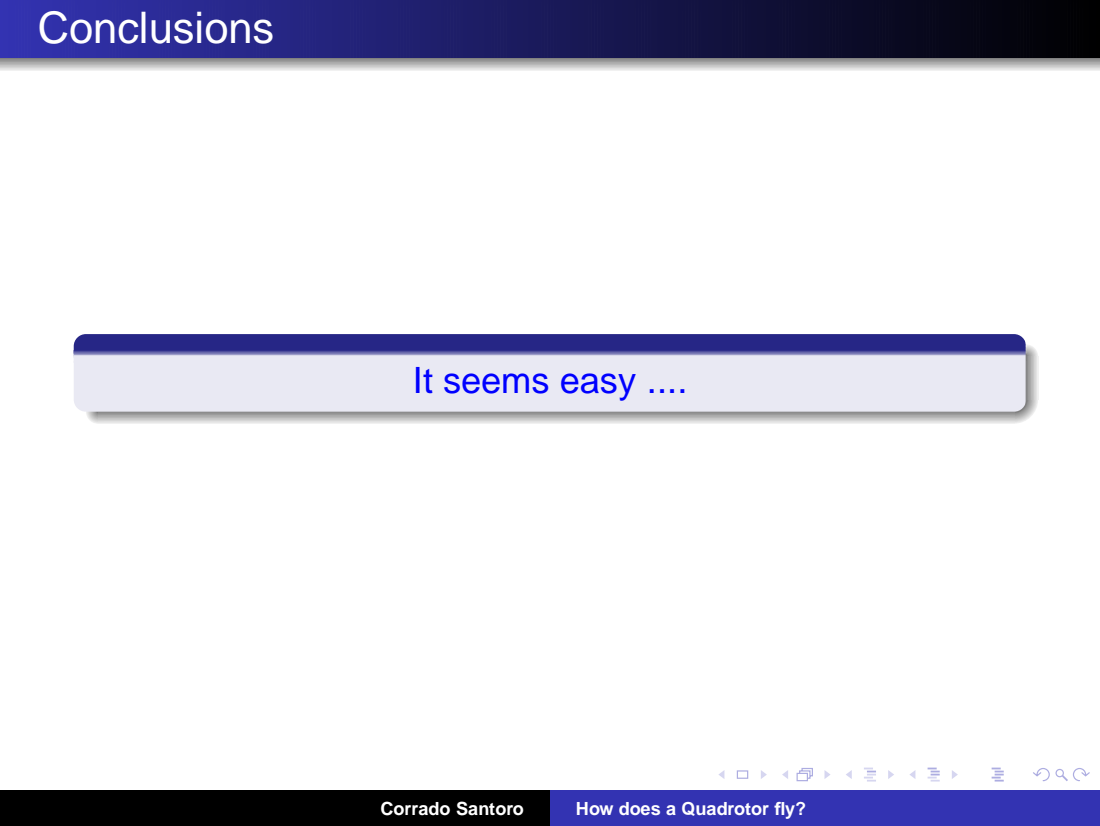
[picture p369: page 60]

It seems easy ....

## ... but, where is the trick?

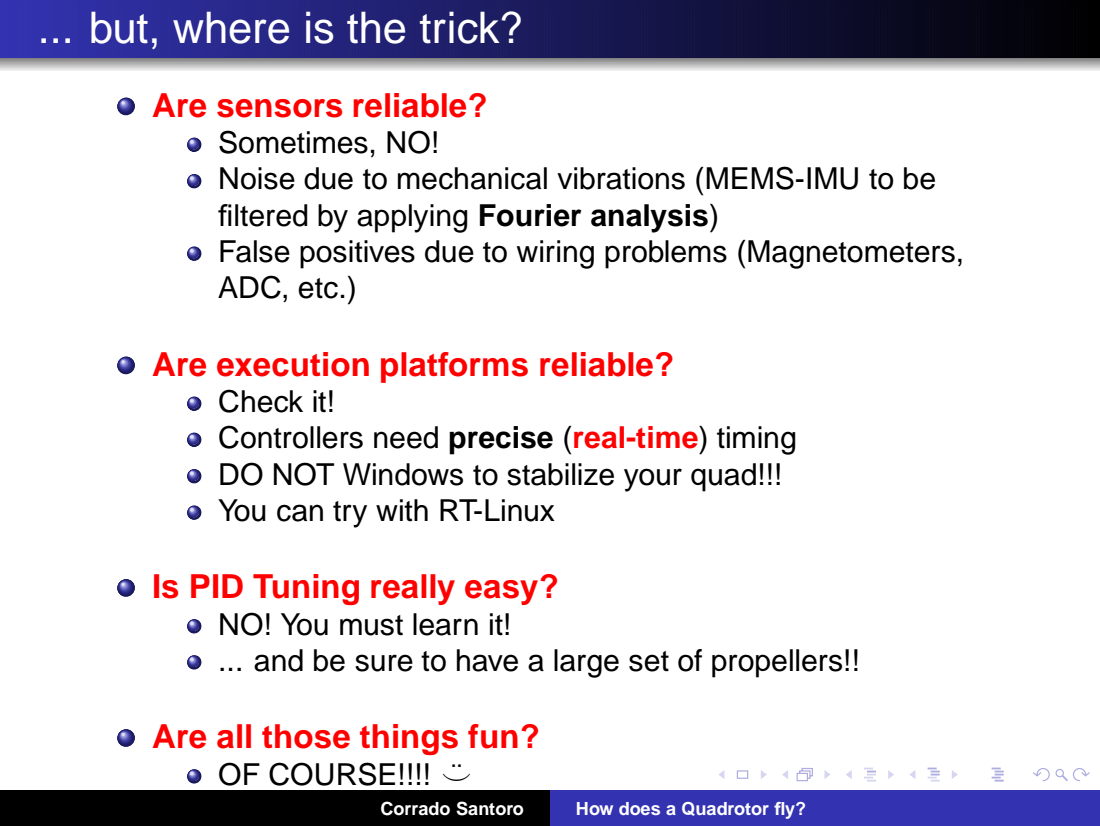
[picture p370: page 61]

Are sensors reliable?
Sometimes, NO!
Noise due to mechanical vibrations (MEMS-IMU to be
filtered by applying Fourier analysis)
False positives due to wiring problems (Magnetometers,
ADC, etc.)
Are execution platforms reliable?
Check it!
Controllers need precise (real-time) timing
DO NOT Windows to stabilize your quad!!!
You can try with RT-Linux
Is PID Tuning really easy?
NO! You must learn it!
... and be sure to have a large set of propellers!!
Are all those things fun?
OF COURSE!!!! ⌣¨

## Will Multi-rotors be the future of personal transportation systems?

Where do I park my multi-rotor??

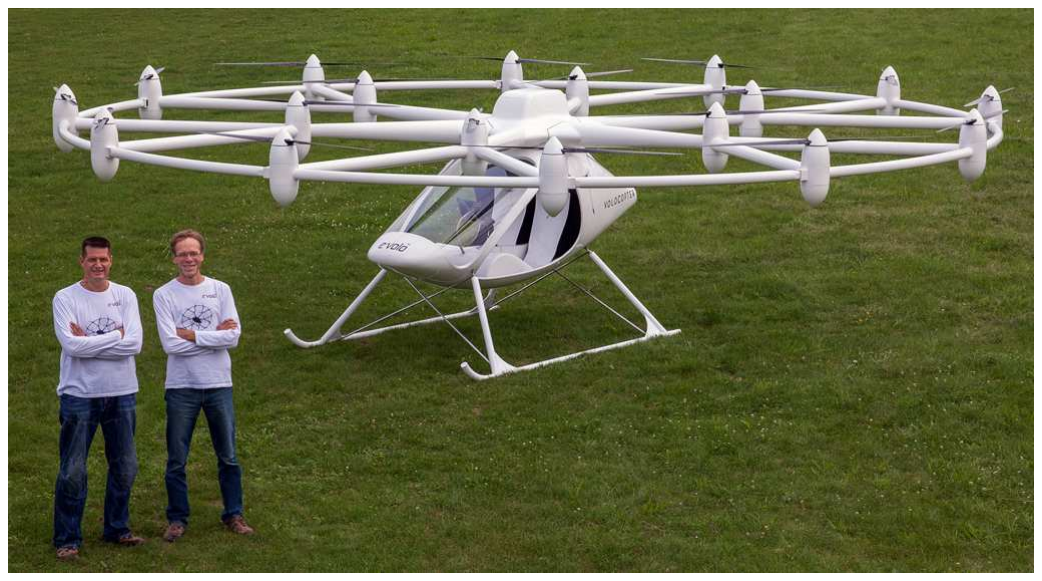
[picture p371: figure]

## Demonstration Flight

First prototype: PROBLEMS!!! DIY is fun but ...
The frame is not well balanced... but the control will do the job
Too many vibrations (many of them suppressed using Chebyshev filters)
Wrong choice of motors (specs report a thurst of 400gr each, but ...)

Wiring/Electronics problems
Current spikes reset the ultrasonic sensor
I2C sometimes locks (a watchdog intervenes and turn-off motors)

Firmware problems
Still working on the sensor fusion algorithm, since it is not satisfactory (we want more stability...)

## How does a Quadrotor fly? A journey from physics, mathematics, control

systems and computer science
towards a “Controllable Flying Object”

ARSLAB - Autonomous and Robotic Systems Laboratory
Dipartimento di Matematica e Informatica - Universita di Catania, Italy `

santoro@dmi.unict.it

Keynote - L.A.P. 1 Course - Jan 10, 2014
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
