YoshuaNava/TesisCuadricoptero/Circuitos/Circuito de Lógica, Sensores y Comunicación/CircuitoLC_Tesis/Prototipo3.pdf

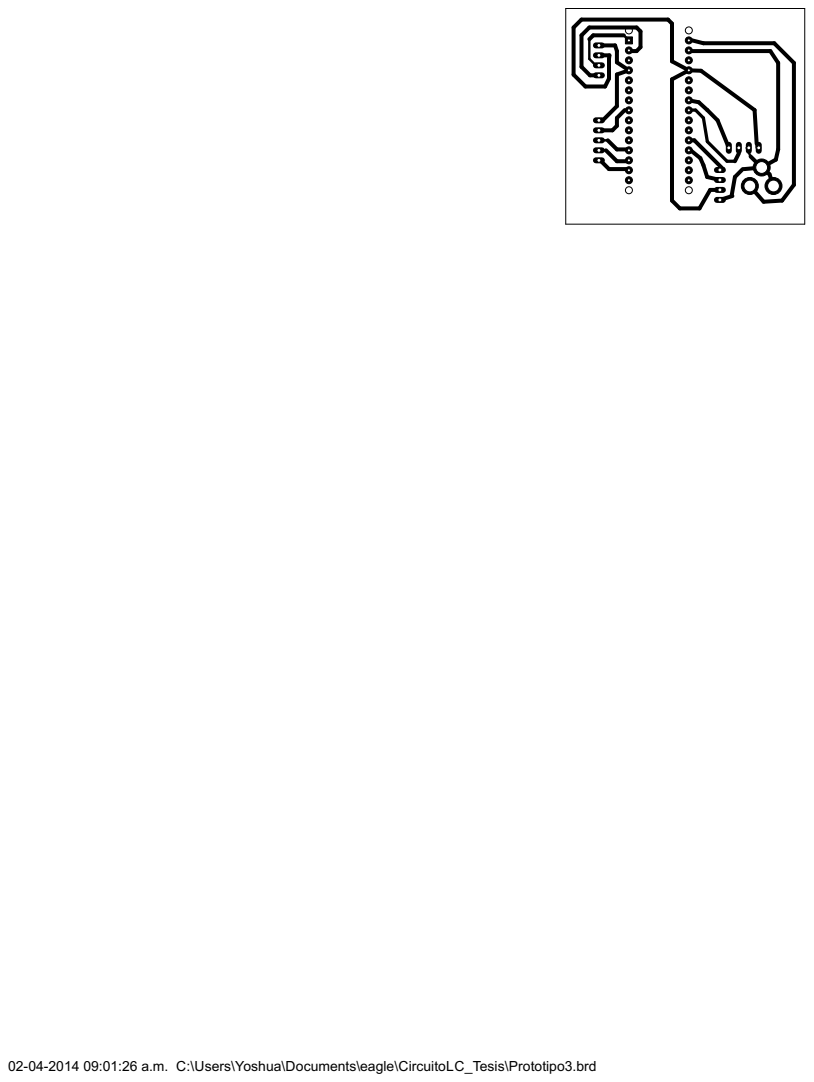
[picture p372: page 1]

02-04-2014 09:01:26 a.m. C:\Users\Yoshua\Documents\eagle\CircuitoLC_Tesis\Prototipo3.brd
