YoshuaNava/TesisCuadricoptero/(list of files, drawings)

Other design files:
Circuitos/SimulacionCircuitoControlMotores_2.ms13
Circuitos/SimulacionCircuitoControlMotores_3.ms13
