YoshuaNava/TesisCuadricoptero/Circuitos/Circuito de Motores y Alimentación/CircuitoMA_Tesis/Prototipo_3X.brd

## EAGLE design Circuitos/Circuito de Motores y Alimentación/CircuitoMA_Tesis/Prototipo_3X.brd (2014-09-10)

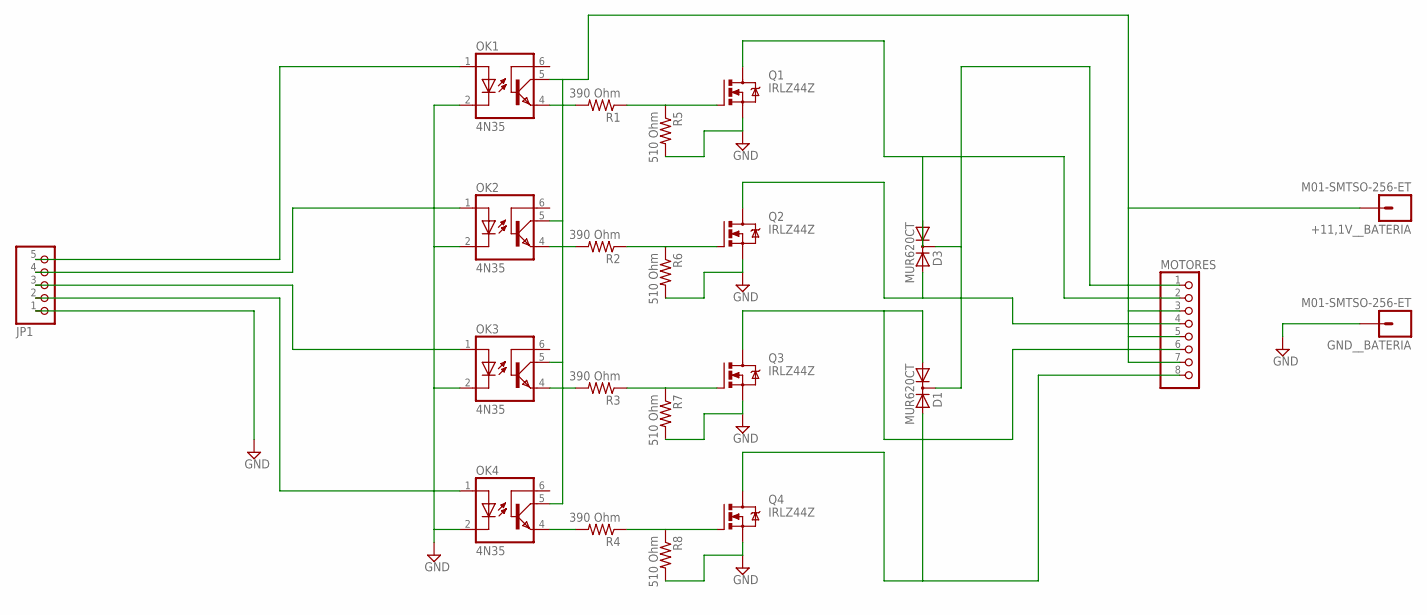
[picture p373: schematic Prototipo_3X.sch]

Parts:
+11,1V__BATERIA: M01-SMTSO-256-ET; SMTSO-256-ET
D1, D3: MUR620CT; TO220AB
GND__BATERIA: M01-SMTSO-256-ET; SMTSO-256-ET
JP1: PINHD-1X5/90; 1X05/90
MOTORES: PINHD-1X8/90; 1X08/90
OK1, OK2, OK3, OK4: 4N35; DIL06
Q1, Q2, Q3, Q4: IRLZ44Z; TO220BH
R1, R2, R3, R4: 390 Ohm; 0207/7
R5, R6, R7, R8: 510 Ohm; 0207/7

Connections:
GND: GND__BATERIA.P$1, JP1.1, OK1.2 (C), OK2.2 (C), OK3.2 (C), OK4.2 (C), Q1.S, Q2.S, Q3.S, Q4.S, R5.2, R6.2, R7.2, R8.2
unnamed: JP1.5, OK1.1 (A)
unnamed: JP1.4, OK2.1 (A)
unnamed: JP1.3, OK3.1 (A)
unnamed: JP1.2, OK4.1 (A)
unnamed: OK1.4 (EMI), R1.2
unnamed: Q1.G, R1.1, R5.1
unnamed: OK2.4 (EMI), R2.2
unnamed: OK3.4 (EMI), R3.2
unnamed: OK4.4 (EMI), R4.2
unnamed: Q4.G, R4.1, R8.1
unnamed: D3.A1, MOTORES.2, Q1.D
unnamed: Q3.G, R3.1, R7.1
unnamed: D3.A2, MOTORES.4, Q2.D
unnamed: D1.A1, MOTORES.6, Q3.D
unnamed: D1.A2, MOTORES.8, Q4.D
unnamed: Q2.G, R2.1, R6.1
unnamed: +11,1V__BATERIA.P$1, D1.C, D3.C, MOTORES.1, MOTORES.3, MOTORES.5, MOTORES.7, OK1.5 (COL), OK2.5 (COL), OK3.5 (COL), OK4.5 (COL)

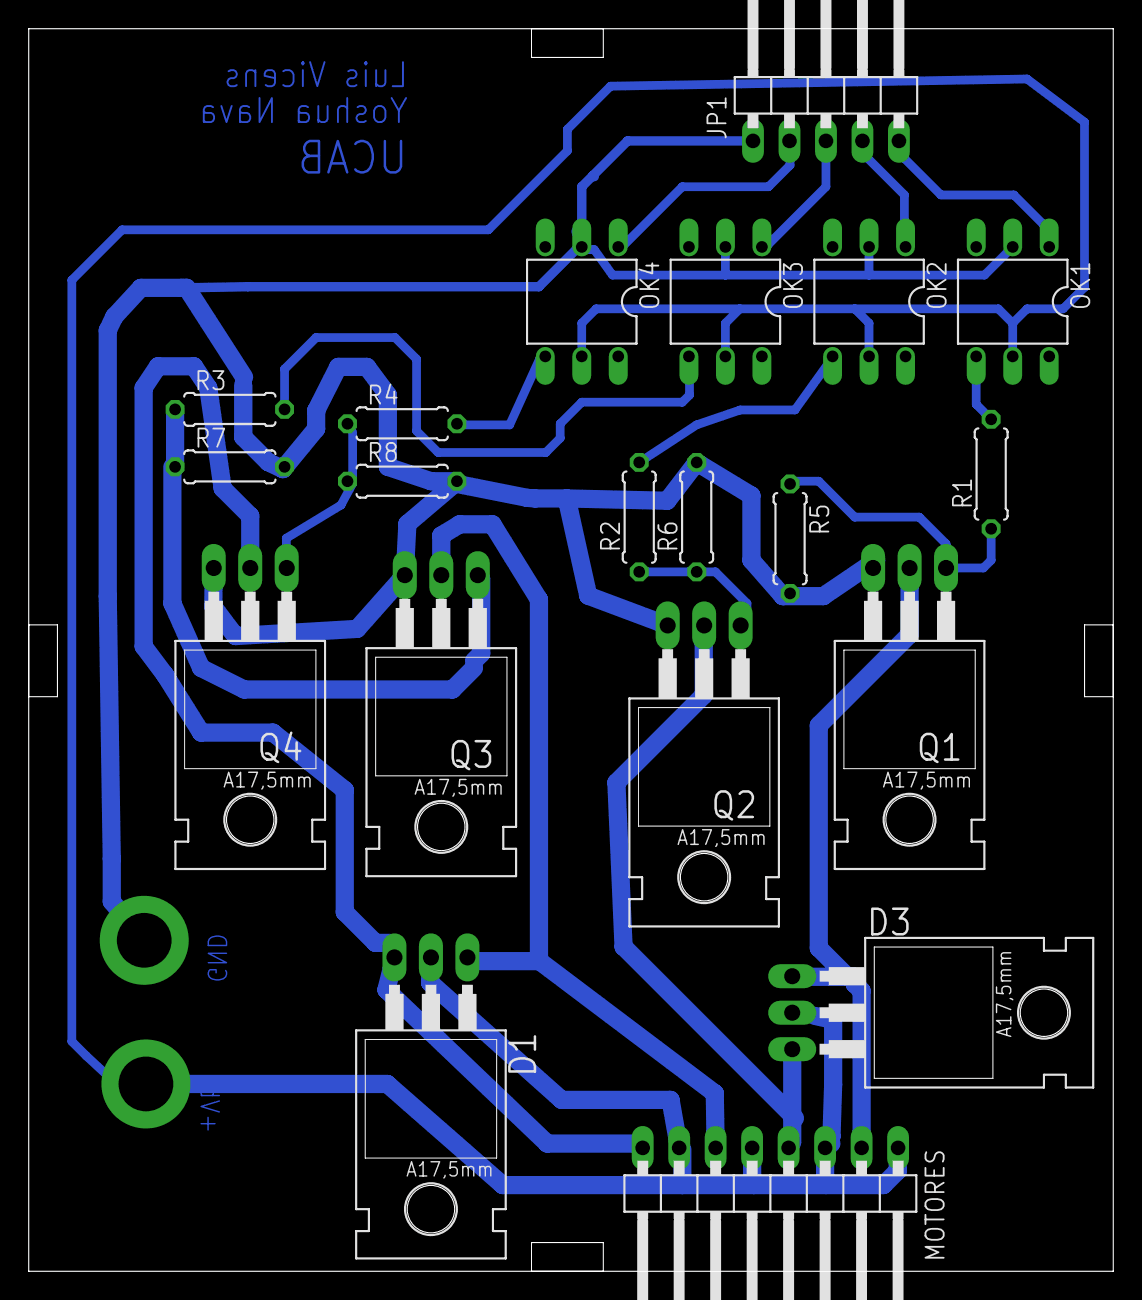
[picture p374: board Prototipo_3X.brd from above]

Board: 2 copper layers, 75.5 x 86.5 mm, 22 parts (0 on the bottom side), 18 nets.
