YoshuaNava/TesisCuadricoptero/Circuitos/Circuito de Lógica, Sensores y Comunicación/CircuitoLC_Tesis/Prototipo3.brd

## EAGLE design Circuitos/Circuito de Lógica, Sensores y Comunicación/CircuitoLC_Tesis/Prototipo3.brd (2014-08-08)

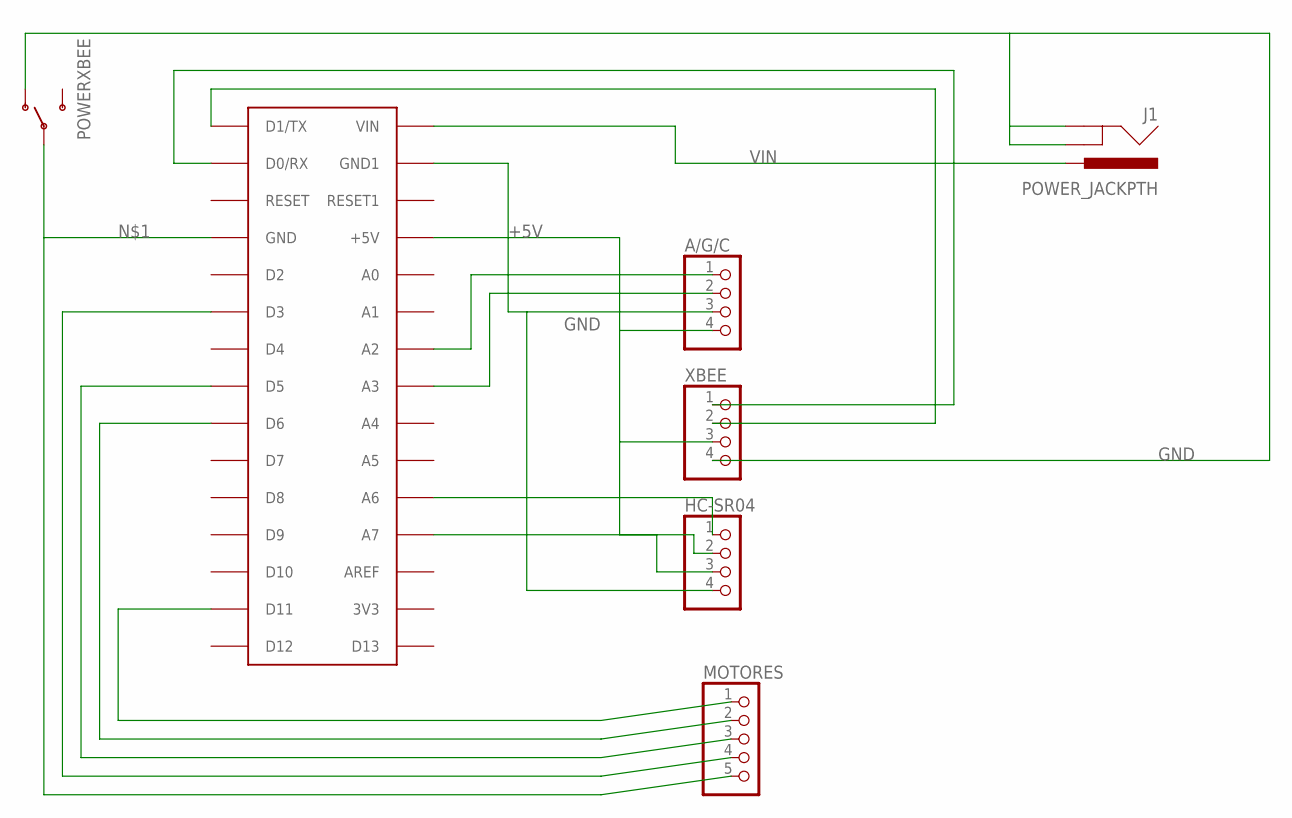
[picture p375: schematic Prototipo3.sch]

Parts:
A/G/C: PINHD-1X4/90; 1X04/90
HC-SR04: PINHD-1X4; 1X04
J1: POWER_JACKPTH; POWER_JACK_PTH
MOTORES: PINHD-1X5; 1X05
POWERXBEE: SWITCH-SPDTPTH; SWITCH-SPDT
U$1: ARDUINONANO; PDIP-32
XBEE: PINHD-1X4; 1X04

Connections:
+5V: A/G/C.4, HC-SR04.3, U$1.+5V, XBEE.3
GND: A/G/C.3, HC-SR04.4, J1.GND, J1.GNDBREAK, POWERXBEE.1 (O), U$1.GND1, XBEE.4
unnamed: MOTORES.5, POWERXBEE.2, U$1.GND
unnamed: MOTORES.4, U$1.D3
unnamed: MOTORES.3, U$1.D5
unnamed: MOTORES.2, U$1.D6
unnamed: MOTORES.1, U$1.D11
unnamed: HC-SR04.1, U$1.A6
unnamed: HC-SR04.2, U$1.A7
unnamed: A/G/C.1, U$1.A2
unnamed: A/G/C.2, U$1.A3
unnamed: U$1.D1/TX, XBEE.2
unnamed: U$1.D0/RX, XBEE.1
VIN: J1.PWR, U$1.VIN

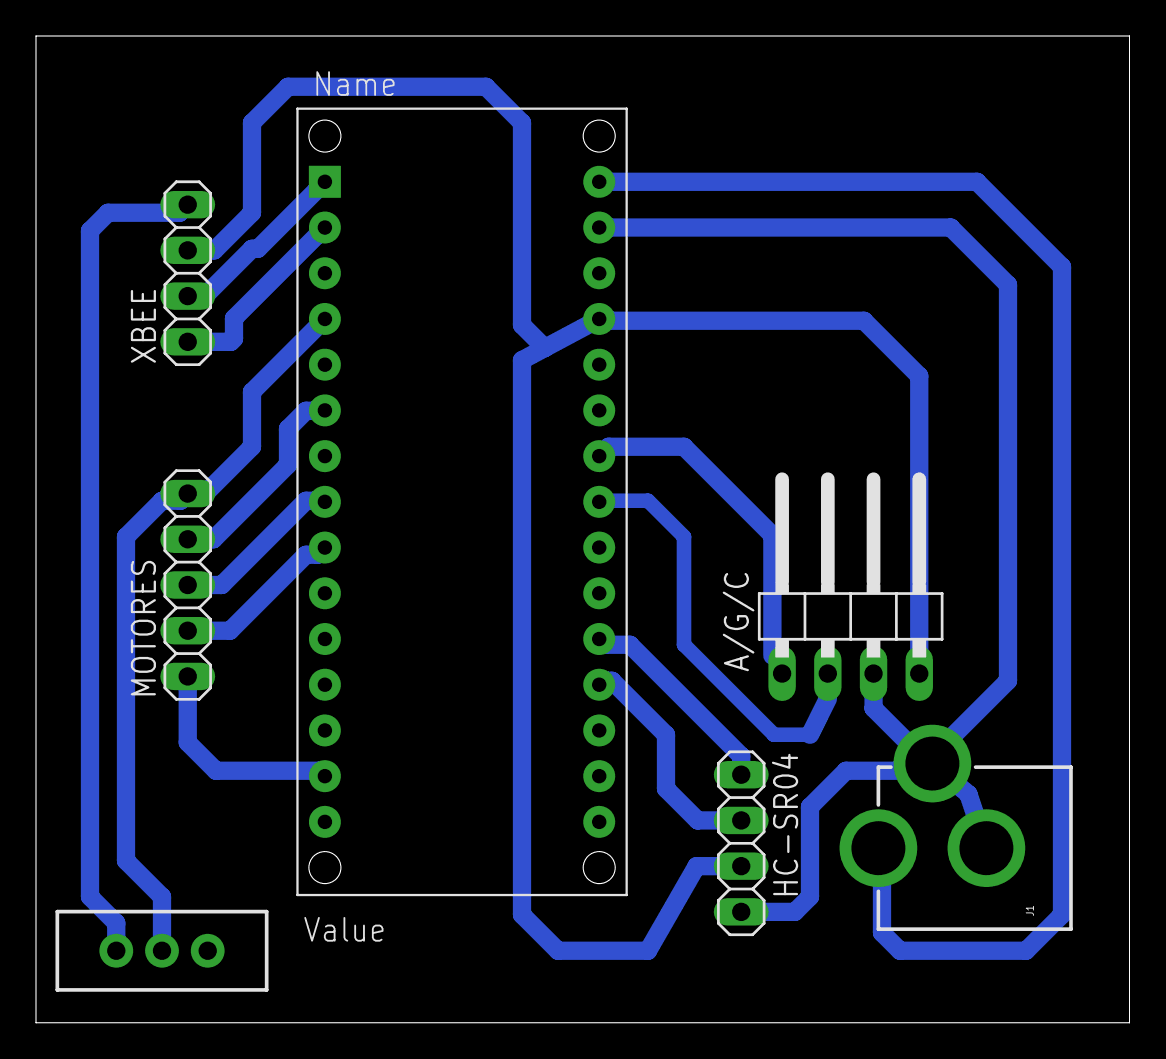
[picture p376: board Prototipo3.brd from above]

Board: 2 copper layers, 60.8 x 54.8 mm, 7 parts (0 on the bottom side), 14 nets.
