YoshuaNava/TesisCuadricoptero/Arduino/Librerías/L3G/examples/Serial/Serial.ino

#include <Wire.h>
#include <L3G.h>

L3G gyro;

void setup() {
  Serial.begin(38400);
  Wire.begin();

  if (!gyro.init())
  {
    Serial.println("Failed to autodetect gyro type!");
    while (1);
  }

  gyro.enableDefault();
}

void loop() {
  gyro.read();

  Serial.print("G ");
  Serial.print("X: ");
  Serial.print((int)gyro.g.x);
  Serial.print(" Y: ");
  Serial.print((int)gyro.g.y);
  Serial.print(" Z: ");
  Serial.println((int)gyro.g.z);

  //delay(100);
}
