YoshuaNava/TesisCuadricoptero/(commit log)

2014-05-02 Subiendo casi todo lo que llevamos
    Diagramas de circuitos, fotos, códigos de MATLAB y Arduino.
2014-05-02 Añadidos documentos y editado el README
2014-05-04 Actualizacion propuesta y referencias
    Modificacion de las referencias bibliograficas de la propuesta, y de la
    carpeta de referencias de la tesis
2014-05-06 Referencias
    Añadidos 2 documentos PDF que no estaban.
2014-05-06 Arduino
    Añadidas librerías y reorganizados los archivos
2014-05-06 Arreglado segun correciones de la tutora hasta final de descripcion de la adalina y se cito al trabajo de McCulloch y Pitts (falta agregarlo en la bibliografia al final)
2014-05-06 Documento Actualizado
    Falta:
    Hablar con la prof sobre limitacion resaltada.
    Hallar el ano y la publicacion de villar y jacob, descargar el documento
    y agregarlo a la bibliografia
    Revisar otros comentarios.
2014-05-06 Documento Actualizaco
    -Hablar con la profe sobre limitacion resaltada.
    -Hallar el ano de publicacion de villamizar y jacob (pagina 10)
    -Agregar la publicacion de villamizar y jacob a la bibliografia
    -Revisar otros comentarios.
    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
2014-05-06 Documento
    Redacción y algunos detalles.
    Esta es la versión que mandaré a la profe hoy 06-05-2014 para la primera
    correción del capítulo 1.
2014-05-06 Documento
    Detalles redacción. Enviado a la profesora.
2014-05-22 Documento
    Marco referencial de teoría de control
2014-05-27 Referencias
    2 referencias sobre IMU para el marco teorico
2014-05-27 Actualizacion marco teorico
    se anadieron los conceptos de IMU, acelerometro, giroscopio y
    magnetrometro para revision
2014-05-27 Referencias
    Referencia anadida:
    Desarrollo de un Sistema Integrado de Navegación
    Inercial: Interfície IMU + FPGA
2014-06-03 Referencias y diagramas de circuito
2014-06-03 Circuito
    Prototipo del segundo circuito de control de motores
2014-06-03 Tutorial de Eagle3d
2014-06-03 Documento y Circuitos
2014-06-04 Circuitos y Documento
2014-06-04 Documento
    Arreglo de detalle en la propuesta y se agregaron 2 antecedentes para
    usar ANN sobre los motores (uno de la posicion angular y otro de la
    velocidad) las notas es la referencia al link del documento
2014-06-14 CircuitoMA
    se pusieron mas gruesas las lineas de power hasta los transistores y se
    acomodo el lugar de switch de apagado y en cendido de los motores, lo
    subi como un documento a parte de manera de que si hay algun error no
    tengamos que hacer un roll back
2014-06-15 Documento
    Propuesta de cambio de objetivos en ZIP
2014-06-15 Circuito de motores y alimentación
    [Prototipo_2.brd, Prototipo_2.sch, Prototipo_2X.brd, Prototipo_2X.sch]
2014-06-15 Codigo
    Mejorado el código del filtro complementario
2014-06-15 Código
    Se estabiliza en los ejes de Pitch y Roll si se varía la distribución
    del peso del cuadricóptero.
2014-06-16 Circuito
    Circuito de motores y alimentación doble capa
    [Prototipo_2.brd, Prototipo_2.sch, Prototipo_2X.brd, Prototipo_2X.sch, Prototipo_2X_DobleCapa.brd, Prototipo_2X_DobleCapa.sch]
2014-06-17 codigo
    puesta a prueba con velocidad base 0 y codigo mejorado
2014-06-18 Código
    División entre PID de velocidad angular y PID de posición angular.
2014-06-19 Python y Arduino
2014-06-19 Arduino y Python
2014-06-19 Arduino y Python. Ya funciona la comunicacion serial con el control.
2014-06-19 Python y Arduino. CUADRICOPTERO ESTABILIZADO EN DOS EJES!!!!!!!!!!!!!!!!!!! :D :D :D
2014-06-19 Reorganización de archivos de Python y Arduino.
2014-06-20 Python y Arduino.
2014-06-20 Arduino. Configurado sensor de ultrasonido
2014-06-20 Arduino. Añadido procedimiento para PID de altura.
2014-06-20 Archivos removidos de MATLAB y Python
2014-06-22 Lista de cosas por hacer
2014-06-30 30/06/2014 12:20am
    Arduino
2014-07-05 05/07/2014 06:05pm
    Arduino, PWM.
2014-07-05 05/07/2014
    Removidos archivos viejos del código de Arduino.
2014-07-06 05/07/2014 09:24pm
    Código de Arduino rehecho completamente.
2014-07-06 05/07/2014 09:36pm
    Código del Arduino
2014-07-06 05/07/2014 10:21pm
    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
2014-07-06 05/07/2014 11:49pm
    Arreglado el problema de deriva del giroscopio en el eje Z, y la
    medición total del ángulo de Yaw.
2014-07-06 06/07/2014
    Eje de Yaw del cuadricóptero semi-estable. Hay drifting creciente.
2014-07-06 06/07/2014 12:21am
    Eliminado archivo viejo de Arduino
2014-07-06 05/07/2014 02:24pm
    * Arreglado el problema de zumbido inicial de los motores. Los puertos
    de PWM no empezaban en 0 lógico, o en su defecto, con un ciclo de
    trabajo de 0%.
    * Los códigos de comunicación ahora son representados por constantes.
    * Nuevo código de encendido: 'T'
2014-07-06 06/07/2014
    Arduino y Python.
2014-07-06 06/07/2014
    Interfaz de comandos
2014-07-07 07/07/2014 Calibración de los sistemas de control de vRoll, vPitch y vYaw.
2014-07-12 12/07/2014 00:02
    Calibración de los sistemas de control de velocidad y posición angular
2014-07-12 12/07/2014 01:23
    Nueva librería para el sensor de ultrasonido.
    Debemos hacer un nuevo circuito de lógica y comunicación, pues en el
    actual estamos utilizando los pines 9 y 10 para PWM, y eso interfiere
    con los temporizadores para realizar la medición de distancia por
    ultrasonido.
2014-08-05 Circuitos de lógica y control de motores
    [Prototipo3.brd, Prototipo3.sch, Prototipo_3X.brd, Prototipo_3X.sch]
2014-08-08 Interfaz en Qt, y código para manejarla.
2014-08-08 Interfaz en Qt, manejando eventos y timer de ejecución.
2014-08-08 Más de la interfaz en Qt.
2014-08-08 Interfaz en Qt con comentarios de TODO.
2014-08-08 Interfaz, y lista de cosas por hacer.
2014-08-11 Marco referencial
    Quité el filtro complementario, pues eso lo describiremos en el
    desarrollo del documento, justificando haberlo elegido en lugar de un
    filtro de Kalman simple.
2014-08-11 Lista de cosas por hacer (fechas y detalles)
2014-08-11 Prototipo 3 del Circuito de motores
2014-08-11 Modulos de comunicacion Arduino/Python
    Queda por arreglar codigo de comandos y en python verificar que no este
    escuchando para poder enviar un comando
    [envio_ligero.ino]
2014-08-11 Código para manejar el Joystick.
2014-08-11 Código del Joystick funcionando, y haciendo paso de mensajes a la interfaz.
2014-08-11 Lista de cosas por hacer actualizada.
2014-08-11 Actualizacion Modulos de comunicacion
    Actualizacion sobre el modulo de comunicacion de arduino y python
    funciona el envio de comandos en python y la recepcion en arduino
2014-08-11 Mejora modulo de comunicacion
    aun esta el problema desde python para recibir el ACK en el codigo de
    python
    [envio_ligero.ino]
2014-08-14 actalizacion modulos de comunicacion
    pruebas sobre modulos de comunicacion
2014-08-14 Comunicación de Python con validaciones. Ya recibe bien los ACK de Arduino.
2014-08-15 comunicacion de python y arduino
    modulos de comunicacion completados falta integracion con arduino
    (programa principal) y python (con la interfaz grafica)
2014-08-19 Documento
    Añadido el índice del desarrollo de la tesis
2014-08-19 Documento
    Agregados los archivos para resultados, y conclusiones.
    Arreglados unos detalles en la lista de temas del desarrollo.
2014-08-19 * Arduino: Ya se envia mensaje de estado a la PC. * Python: Ya hay un hilo escuchando el puerto serial, que se inicia con la ventana. El hilo en cuestion grafica con bastante retardo, y ademas, hay q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
2014-08-19 Lista de cosas por hacer.
2014-08-21 Documento
    Desarrollo.
    Estimación de ángulos.
    Falta la estimación de ángulos con el acelerómetro y la explicación del
    filtro complementario.
2014-08-21 Código para pruebas de motores.
2014-08-25 Circuito de control de motores
    [SimulacionCircuitoControlMotores_2.ms13, SimulacionCircuitoControlMotores_3.ms13]
2014-08-26 comunicacion desarrollo y codigo en arduino
    Comunicacion en arduino se arreglo el mensaje de envio de etado, falta
    arreglarlo en python, se comenzo con la descripcion de la comunicacion
    para el desarrollo
2014-09-01 Lista de cosas por hacer + calendario de fechas de entrega para acto febrero 2015.
2014-09-01 Diagramas de circuitos viejos.
2014-09-04 Documento
    marco referencial arreglado listo para enviar a revision
2014-09-05 Documento
    Circuito de control de motores
    [Datos de las pruebas del IRFZ44N y motores.xlsx]
2014-09-05 Circuitos y documento
    Circuito de control de motores.
    [Datos de las pruebas del IRFZ44N y motores.xlsx, Prototipo_3X.brd, Prototipo_3X.sch]
2014-09-06 Documento
    Módulo de lógica, sensores y comunicación
2014-09-06 Documento
    Detalle de organización del contenido en el desarrollo
2014-09-06 Documento
    Un poco del software, y descripción del sensor de altura utilizado.
2014-09-06 Documento
    Arreglado un detalle en el planteamiento del problema.
    Foto del sensor de altura.
2014-09-07 Circuito impreso
    Diseno del circuito impreso
2014-09-08 Circuito Impreso
    [Prototipo_3X.brd]
2014-09-09 Circuito
    Aumentado el grosor de algunas pistas.
    [Prototipo_3X.brd]
2014-09-09 Documento
    Detalles de presentación
2014-09-10 Desarrollo
    Documento de desarrollo actualizado
2014-09-11 Estación de control
    Borrando archivos viejos
2014-09-11 Arduino - Envio de mensajes de estado. PC - Recepción de mensajes de estado
2014-09-12 Interfaz de comunicación. Falta validar comandos negativos.
2014-09-12 Arduino. Borrada una función que no estábamos utilizando.
2014-09-12 Arduino y Python.
2014-09-13 Arduino, sin PID de velocidad angular en Pitch y Roll
2014-09-13 Arduino
    Reorganización del código.
2014-09-15 Filtro de Kalman de altura.
2014-09-15 Desarrollo actualizado
    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
2014-09-15 Arduino: Filtro de Kalman de altura.
2014-09-15 Arduino: Calibracion de sistemas de control de posicion angular, velocidad angular y altura.
2014-09-16 Documento
    Desarrollo - Estimación de altura
2014-09-17 Documento
    Sistemas de control
2014-09-17 Documento
    Sistemas de control - Modelo/Simulación/Controlabilidad
2014-09-17 Diagrama esquema de funcionamiento
    Esquema de funcionamiento general
2014-09-18 diagrama general de aplicacion y marco referencial
    se anadio filtro de kalman al marco reerencial
2014-09-18 excel datos de pruebas distancias
    [Datos de pruebas de Xbee a distancia.xlsx]
2014-09-18 Documento
    Correcciones en el desarrollo
2014-09-18 Software, comunicación y giroscopio
    [Datos de pruebas de Xbee a distancia.xlsx]
2014-09-19 Software y Arduino
2014-09-19 Calibración Arduino.
2014-09-19 Calibración-Arduino.
2014-09-19 Arduino-Calibración. Software.
2014-09-19 Calibración en Arduino.
2014-09-19 Arduino-Calibración. Software-Ángulo máximo de comandos.
2014-09-19 Sistema de control de altura.
2014-09-19 Incremento de altura.
2014-09-20 Software: Paquetes y mensajes de ROS.
2014-09-21 Software: Nodo para el joystick Logitech Rumblepad II.
    [scale_mmx.obj]
2014-09-21 Software listo!!! (El núcleo, capaz luego haya que hacer validaciones)
2014-09-21 Fotos y video en la carpeta principal. Tenemos demasiadas vibraciones al encender los motores .-.
2014-09-21 Arduino: Filtro pasa-bajos de velocidad angular.
2014-09-21 Arduino: Corección en la implementación del filtro pasa-bajos.
2014-09-21 Imagen de prueba del nuevo filtro pasa-bajos.
2014-09-22 Desarrollo
    Mejorada:
    Plataforma de pruebas
    Comunicacion
    Falta hacer:
    SW de telemetria y comandos
    [Datos de pruebas de Xbee a distancia.xlsx]
2014-09-22 Arduino: Calibración del cuadricóptero.
2014-09-22 Arduino: Calibración.
2014-09-22 Arduino: Configuración del giroscopio.
2014-09-27 Offset del giroscopio
    se agrego un offset a las medidas YPR para el giroscopio y las grafias
    del antes y despues
2014-09-27 Filtro de Buterworth para velocidad YPR y acomodado offset
2014-09-27 butterworth + offset
    mejora codigo offset y filtro de butterworth para velocidades YPR
2014-10-02 Documento
    Planteamiento del problema. Typo en el alcance.
    Desarrollo. Estimación de ángulo.
2014-10-06 Software: Paquete para exportar mensaje de estado del cuadricóptero a formato CSV.
2014-10-06 Software: Exportador de mensajes de estado a formato CSV.
2014-10-06 Software: Pruebas del nuevo paquete para exportar mensajes de estado a formato CSV. Arduino: Nuevo mensaje de encendido. Preparación de condiciones para pruebas (Constantes de PID = 0)
2014-10-06 Software: Organizacion del repositorio. Untrack de carpetas build y devel.
2014-10-06 Software: Bug en el paquete para leer datos del joystick.
2014-10-06 Linea de debugueo en el software.
2014-10-06 Pruebas de vibraciones en la IMU.
    [estado_120.csv, estado_160.csv, estado_180.csv, estado_200.csv, estado_220.csv, estado_240.csv, estado_b.csv, estado_f.csv]
2014-10-06 Análisis de respuesta en frecuencia de la IMU
2014-10-07 Pruebas de caracterización de la IMU.
    [estado_apagado_movimiento.csv, estado_apagado_reposo.csv]
2014-10-07 Scripts para analizar datos de la IMU en frecuencia.
2014-10-07 Pruebas de respuesta en frecuencia de la IMU.
    [estado_200_movimientosBruscos.csv, estado_200_movimientosLentos.csv, estado_200_sensorFuera_1.csv, estado_200_sensorFuera_2.csv]
2014-10-07 Scripts para realizar análisis de frecuencia.
2014-10-07 Scripts para realizar análisis en frecuencia de la IMU.
2014-10-07 Scripts para realizar pruebas de análisis en frecuencia de la IMU.
2014-10-09 graficas hechas aun falta centrar y poner limites
    se comentaron las lineas del AnalisisFReciencia para que el programa de
    graficas se encargara de hacer las graficas, recibe un vector de
    archivos [archivo1;archivo2] y la frecuencia
2014-10-11 Documentación y reorganización del repositorio
    [estado_120.csv, estado_160.csv, estado_180.csv, estado_200.csv, estado_200_AG_movimientosBruscos.csv, estado_200_acelerometro_giroscopio.csv, estado_200_comparacion_filtroGiroscopio_movimientos_apagado.csv, estado_200_comparacion_filtroGiroscopio_movimientos_poca_bateria.csv]
2014-10-11 Arduino
    Reorganización.
    Borrada la variable de ganancia del acelerómetro. Eso lo utiliza Shane
    Colton para no tener que aplicar las fórmulas de trigonometría.
    "Linealiza" la salida del acelerómetro.
2014-10-13 Script para realizar analisis en frecuencia de la IMU y visualizar los resultados.
2014-10-13 cambio del programa principal de arduino a_angulo
2014-10-13 archivos de CSV para vibraciones
    [PosicionAngularAcelerometroMovimientoPWM0.csv, PosicionAngularAcelerometroReposoPWM0.csv, PosicionAngularAcelerometroReposoPWM200.csv]
2014-10-13 Scripts para pruebas en frecuencia de la IMU.
2014-10-15 Arduino: Manejo de frecuencias de muestreo del acelerómetro y giroscopio.
    [BaseIMU_200_mE_reposo_fA20.csv, BaseIMU_200_mE_reposo_fAG10h.csv, BaseIMU_200_mE_reposo_fAG10pb.csv]
2014-10-15 Pruebas de respuesta en frecuencia de la IMU. Filtros no funcionan bien.
    [BaseIMU_200_mE_reposo-1.csv, BaseIMU_200_mE_reposo-2.csv, BaseIMU_200_mE_reposo-3.csv, BaseIMU_200_mE_reposo_fAG10l.csv, BaseIMU_200_mE_reposo_fAG10l_FM200.csv, BaseIMU_200_mE_reposo_fAG10pb.csv]
2014-10-16 Arduino y analisis de respuesta en frecuencia.
    [AccOffset_reposo_mOff_S2g.csv, AccOffset_reposo_mOn_S2g.csv, AccOffset_reposo_mOn_S2g_fM50.csv, Acc_reposo_mOff_S2g.csv, Acc_reposo_mOff_S4g.csv, BaseIMU_200_mE_reposo-1.csv, BaseIMU_200_mE_reposo-2.csv, BaseIMU_200_mE_reposo-3.csv]
2014-10-16 Arduino: Filtro pasa-bajos de 10Hz.
    [AccOffset_reposo_mOff.csv, AccOffset_reposo_mOn.csv, AccOffset_reposo_mOn_S2g.csv, AccOffset_reposo_mOn_S2g_fM50.csv, AccOffset_reposo_mOn_lp10.csv, Acc_reposo_mOff_S2g.csv, Acc_reposo_mOff_S4g.csv]
2014-10-16 Arduino: Filtro de Kalman del acelerometro en Z.
2014-10-16 Pruebas de respuesta en frecuencia del acelerómetro, con filtro pasa bajos, filtro de Kalman, y sin nada.
    [AccOffset_reposo_mOn_KF.csv, AccOffset_reposo_mOn_lp10_KF.csv]
2014-10-17 Nuevas pruebas de respuesta en frecuencia de la IMU, con amortiguación. Arduino: Filtros pasa bajos de 8Hz en el giroscopio y el acelerómetro. Manejo de frecuencia de muestreo rígido para mantener la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
    [AccOffset_reposo_mOn_KF_dampening.csv, AccOffset_reposo_mOn_KF_dampening_lp10.csv, Angulo_reposo_mOn_Kcomp96.csv, Angulo_reposo_mOn_Kcomp99.csv, errorKF-AccOffset_movimiento_mOn_KF_dampening.csv, errorKF-AccOffset_reposo_mOn_KF_dampening.csv]
2014-10-17 Comparación de modelo físico de otros trabajos con el DraganflyeV
    [ComparacionModelosFisicosDraganflyerV_Referencias.xlsx]
2014-10-17 Pruebas de respuesta en frecuencia de la estimación de ángulos y posición angular.
    [Angulo_movimiento_mOn_Kcomp99-1.csv, Angulo_movimiento_mOn_Kcomp99-2.csv, Angulo_reposoMano_mOn_Kcomp99.csv, Angulo_reposo_mOn_Kcomp99.csv, LowBatt_Angulo_reposo_mOn_Kcomp96.csv, LowBatt_Angulo_reposo_mOn_Kcomp99.csv]
2014-10-17 Arduino: Código para pruebas de calibración.
    [Angulo_reposo_mOn_Kcomp99-1.csv, Angulo_reposo_mOn_Kcomp99-2.csv, Angulo_reposo_mOn_Kcomp99-3.csv]
2014-10-17 Arduino: Código para pruebas.
2014-10-17 Arduino: Código para análisis de respuesta en frecuencia de la IMU, y código para pruebas de calibración y vuelo del cuadricóptero.
2014-10-17 Calibración de PID de velocidad de Roll.
2014-10-17 ROS: Error en el nodo del joystick.
    [run.py]
2014-10-17 Arduino: Comandos de velocidad en lugar de ángulo.
2014-10-17 Arduino: Calibración de PID de velocidad angular.
2014-10-18 Arduino: Control PID de velocidad angular solamente.
2014-10-18 Arduino: Control PID de velocidad solamente.
2014-10-18 ROS: Formato del comando de altura, y máximo valor del comando de ángulo. Arduino: Arreglos en el código.
    [CuadricopteroUCAB_VelocidadAngular.ino, handler_serial.py, run.py]
2014-10-18 Modelo físico
    [ComparacionModelosFisicosDraganflyerV_Referencias.xlsx]
2014-10-18 Comparativa de modelos físicos. Eliminados archivos viejos del repositorio.
    [ComparacionModelosFisicosDraganflyerV_Referencias.xlsx]
2014-10-18 Modelo físico.
    [ComparacionModelosFisicosDraganflyerV_Referencias.xlsx]
2014-10-19 Simulación de PID de velocidad angular.
2014-10-19 Simulaciones de controladores de posición angular, velocidad angular, posición en Z y velocidad en Z.
2014-10-19 Archivos corregidos
    aun falta terminar de corregir desarrollo poner tenxto entre las
    imagenes y numerar las funciones matematicas
2014-10-19 Desarrollo
    Desarrollo arreglos hecho por la tutora
2014-10-20 Documento - Sistemas de control - Modelo dinámico.
    [ComparacionModelosFisicosDraganflyerV_Referencias.xlsx]
2014-10-20 Documento - Desarrollo:Sistemas de Control - Resultados. Diagramas.
2014-10-20 Simulación de los sistemas de control. Documento - Desarrollo: Sistemas de control.
    [ComparacionModelosFisicosDraganflyerV_Referencias.xlsx]
2014-10-20 Documento - Desarrollo: Sistemas de control.
2014-10-21 Diagrama de botones de joystick
    anadido diagrama a imagenes y en el desarrollo
2014-10-22 Desarrollor filtrado y respuesta en frecuencia IMU
2014-10-22 Software: Implementacion de nuevo mensaje para telemetria total.
2014-10-22 Software y Arduino: Implementación del nuevo mensaje para telemetría.
2014-10-22 Software: Nuevo nodo para exportar datos de telemetria total.
2014-10-22 Borradas pruebas viejas de la IMU.
    [AccOffset_reposo_mOff.csv, AccOffset_reposo_mOn.csv, AccOffset_reposo_mOn_KF.csv, AccOffset_reposo_mOn_KF_dampening.csv, AccOffset_reposo_mOn_KF_dampening_lp10.csv, AccOffset_reposo_mOn_lp10.csv, AccOffset_reposo_mOn_lp10_KF.csv, Angulo_movimiento_mOn_Kcomp99-1.csv]
2014-10-23 Arduino: Calibración de los sistemas de control.
2014-10-23 Arduino y ROS.
2014-10-24 Cuadro de mensajes de telemetria
    [Cuadro mensajes de telemetria.xlsx]
2014-10-24 Pruebas de rendimiento del PID de velocidad.
    [PID_velocidad_2410.csv]
2014-10-25 actualizado
    muestra 2 figuras separadas on los graficos de roll pitch y ya...
    revisar titulo de la segunda figura
2014-10-26 lista de graficas que faltan en el documento
2014-10-28 Modelo físico: Análisis de diagrama de fase (con errores)
2014-10-28 Análisis en fase de la dinámica del sistema.
2014-10-28 Lista de gráficas y pruebas por hacer.
2014-10-28 Pruebas PID velocidad angular.
    [PID_velocidad_2410.csv, PID_velocidad_2810-2.csv, PID_velocidad_2810.csv, TT_ME_EjePitch.csv, TT_ME_EjeRoll.csv, TT_ME_PID_vPitchRoll.csv, TT_ME_PitchRoll.csv, TT_ReposoTotal.csv]
2014-10-28 Arduino: Filtros.
    [TT_AnguloLPFs.csv, TT_AnguloPuro.csv]
2014-10-28 Pruebas con los sensores.
    [TT_AnguloKFacc.csv, TT_AnguloLPFs10Hz.csv, TT_AnguloLPFs30Hz.csv, TT_mApagados_AnguloKFacc.csv]
2014-11-01 Arreglando error en los scripts de análisis de respuesta en frecuencia.
2014-11-01 Scripts de análisis de respuesta en frecuencia.
2014-11-02 Arduino y MATLAB.
2014-11-03 Aplicación de filtro de media móvil al acelerómetro. Envío serial a 115200 baudios por segundo.
2014-11-03 Estimación de posición angular aparentemente estable :O.
    [TT_AccMM_20Ventanas.csv, TT_AccMM_40Ventanas-2.csv, TT_AccMM_40Ventanas.csv, TT_AccMM_40Ventanas_GyroMM_2Ventanas.csv, TT_AccMM_40Ventanas_mApagados.csv]
2014-11-03 Estimación de posición angular aparentemente estable O_O
2014-11-03 Arduino: Bug recibiendo comandos de posición angular.
2014-11-05 Arduino: Arquitectura mixta de control.
2014-11-05 Bug en el software.
2014-11-05 Arduino: Calibración posición angular.
2014-11-06 Arduino: Limpieza del código.
2014-11-06 ROS: Logitech_gamepad_ii - Control exponencial. MATLAB: Simulación de PID.
2014-11-07 Modelo y Arduino.
2014-11-07 Arduino: Calibración de PID de velocidad angular. Ahora se utilizan velocidades angulares filtradas en Pitch y Roll.
2014-11-11 matriz de inercia, basado en la referencia montada
    se agrego la inercia de la cabina
2014-11-18 matriz de tensores de inercia, arreglado
2014-11-18 Simulaciones con tensor de inercia correcto
2014-11-20 Arreglo para telemetria total.
    [CuadricopteroUCAB_VelocidadAngular.ino, run.py]
2014-11-20 paso de desarrollo a apendices
2014-11-20 Arduino con comentarios. Documento - Apendices y anexos. Portada y eso.
2014-11-20 Arduino y Documento.
2014-11-23 Arduino: PID de velocidad en Z.
2014-11-25 correcciones y consideracion de gravedad
2014-11-25 Documento
    Faltan: diagramas, cálculo de parámetros, pruebas y estimación de
    velocidad lineal en el eje z.
2014-11-25 Arduino: Velocidad en Z.
2014-11-26 Matriz de inercia
2014-11-26 diagrama de estacion de control
2014-11-26 Cuadro de mensajes arreglado y referencia anadida al cuadro de velocidad de mensjaes
2014-11-26 Documento: Faltan pruebas del sensor de altura y más nada.
    [Estado_ACC_SinBase_100_mE.csv, Estado_BaseIMU_100_mE_reposo.csv, Estado_SensorFuera_100_mE.csv]
2014-11-26 Documento. Falta lo de altura solamente.
2014-11-27 Mejoras y diagrama de arduino anadido
2014-11-27 Documento a entregar para la tercera revisión.
2014-12-09 esquema de exposicion
    Sujeto a cambios pueden ser mas o menos laminas es para seguir un orden
2014-12-09 Arduino: posición angular y altura.
    [TT_PIDposicionangularPitch.csv, TT_PIDposicionangularRoll.csv]
2015-01-01 Falta agregar sinopsis, introduccion y pruebas del sensor ultrasonico de distancia. Hay que arreglar los numeros de figuras y tablas, y poner todo en un solo documento.
2015-01-01 Faltaba agregar el metodo para calcular Velocidad lineal en z.
2015-01-03 orden y numeros de ilustraciones arreglados
2015-01-05 Correcciones
    Errores ortograficos y de forma, Revisar
2015-01-06 Metodologia arreglado
    Descripcion de la metodolgia basada fundamentalmente en pressman,
    explicada paso a paso de forma generica y con el diagrama en espanol,
    creo que la referencia bibliogracia de Margaret Rouse ya no hace falta
    por facor revisar
2015-01-08 pruebas pid yaw
    [PID_yaw_08012015.csv]
2015-01-09 Documento. Formato y reorganización de la carpeta.
2015-01-12 Sólo faltan los números de las ecuaciones y mejorar la introducción.
2015-01-12 Tomo 1: Números de las ecuaciones.
2015-01-12 Sólo falta arreglar la introducción.
2015-01-12 Indice de apéndices y anexos.
2015-02-07 correciones tomo 1
    diagrama a la primera parte y arreglos de detalles en el tomo
2015-02-07 Tomo 2 - Glosario de términos.
2015-02-07 fuenes glosario pie de pagina
2015-02-07 Glosario de términos 2 arreglado. Posible versión final.
2015-02-12 MATLAB, scripts para analisis de rendimiento de los sistemas de control.
