YoshuaNava/TesisCuadricoptero/Fotos/DSC_0190.JPG

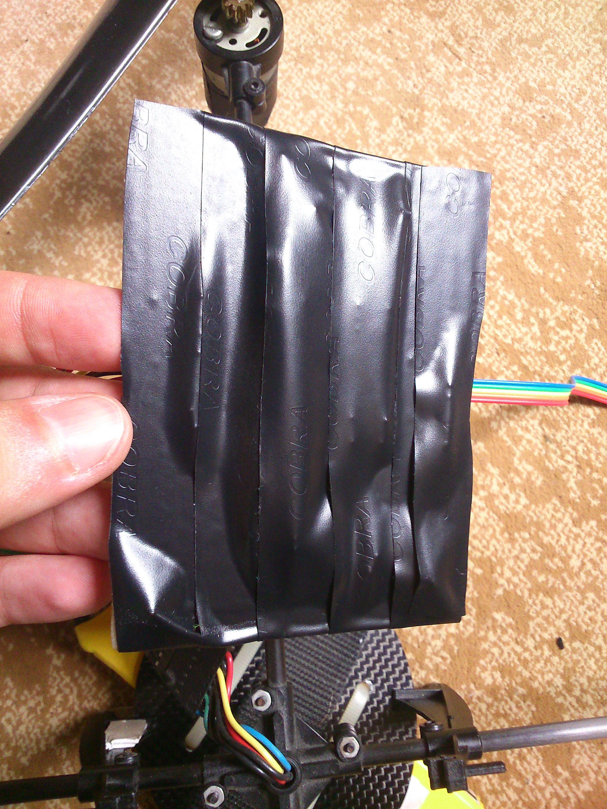
Fotos/DSC_0190.JPG
